maxutko1/semester-project-2-/Pics/20250319_132219.jpg

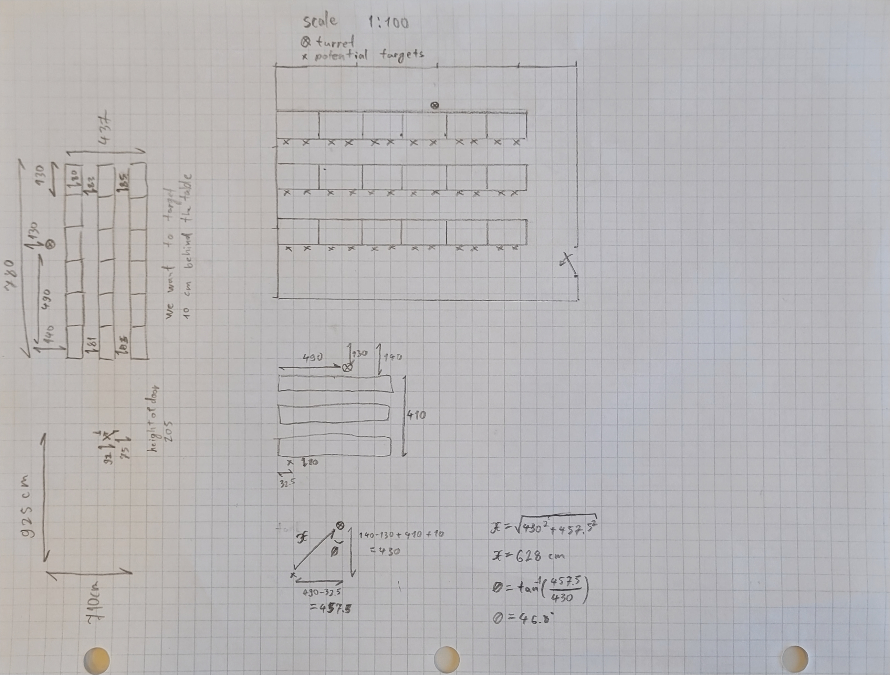
Pics/20250319_132219.jpg
