maxutko1/semester-project-2-/Pressure Tank/very shot pic.jpg

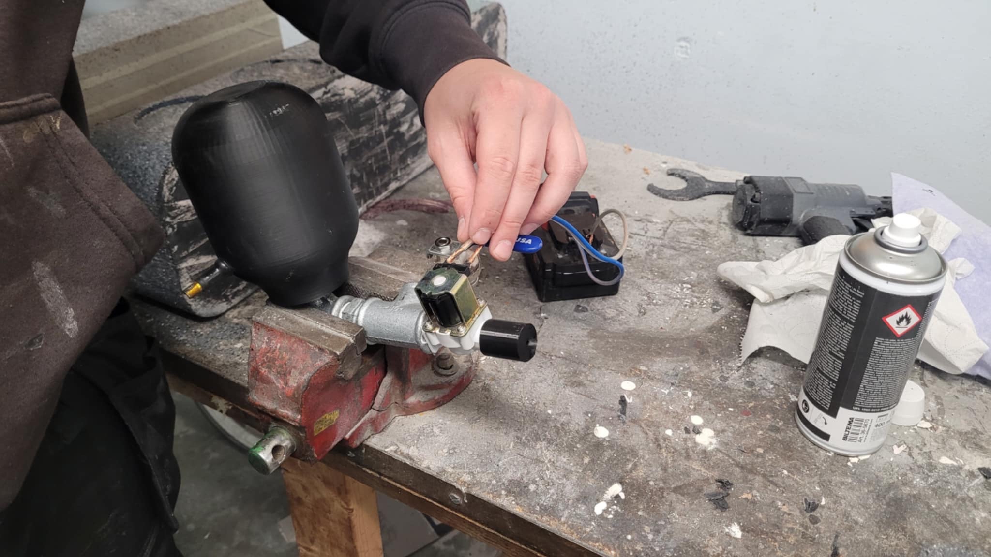
Pressure Tank/very shot pic.jpg
