maxutko1/semester-project-2-/Budget word document.docx

# Budget

Budgeting is often one of the biggest challenges for any engineering project, especially during the learning phase. While it's tempting to prioritize getting a working prototype at all costs, adhering to a budget is critical—both for discipline and to avoid creating unrealistic expectations for future users or customers. For this project, we maintained a total budget of 2000 DKK, which we successfully stayed within.

A significant portion of the budget was allocated to motors and 3D printing. The motors selected for this project are relatively powerful, and due to the iterative nature of our design process, we performed extensive testing and reprinting of components. Although this consumed more filament than a more streamlined approach might have, we collectively agreed that multiple test cycles would result in a more refined final product. The trade-off in material cost was deemed worthwhile for the performance and reliability gains.

Some components were purchased purely for testing purposes—such as breadboards and jumper wires—due to recent limitations in the university facilities. As many students will recognize, these shortages followed the departure of Niels, a key staff member whose absence is still felt. As a result, we found it necessary to procure basic prototyping equipment ourselves to avoid unnecessary delays.

There are also a few items not reflected in the official budget, primarily because they were either unavailable through standard vendors in Denmark or were significantly more affordable through overseas suppliers. These include the PD power delivery board (see Power Board section), the DC-DC buck converter, and the high-pressure pump. These components were instead paid for directly by individual team members, often sourced from “Chinesium” suppliers—a lighthearted term we use for affordable international marketplaces.

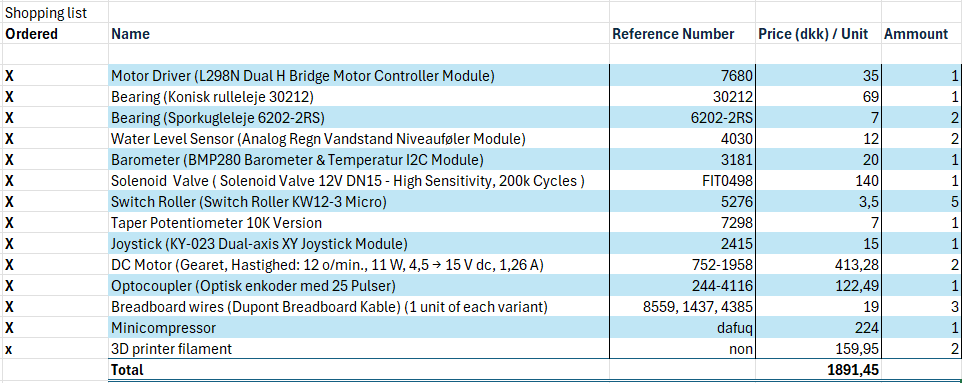
[picture p13: figure]
Et billede, der indeholder tekst, skærmbillede, nummer/tal, Font/skrifttype Indhold genereret af kunstig intelligens kan være forkert.
