maxutko1/semester-project-2-/Cad models/ic162-microswitch-1.snapshot.2/Screenshot_2.jpg

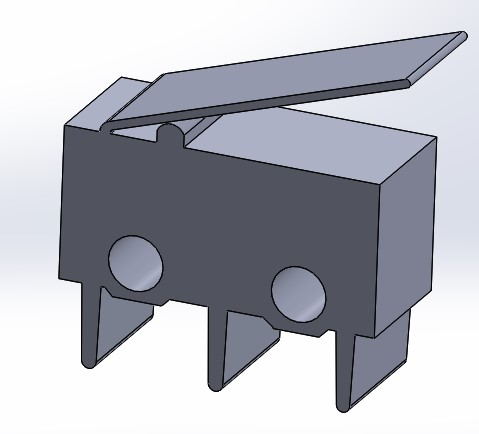
Cad models/ic162-microswitch-1.snapshot.2/Screenshot_2.jpg
