maxutko1/semester-project-2-/Cad models/PotentiometerB10K.png

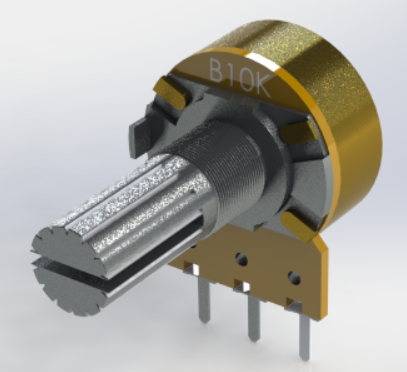
Cad models/PotentiometerB10K.png
