maxutko1/semester-project-2-/Cad models/PotentiometerB10KBack.png

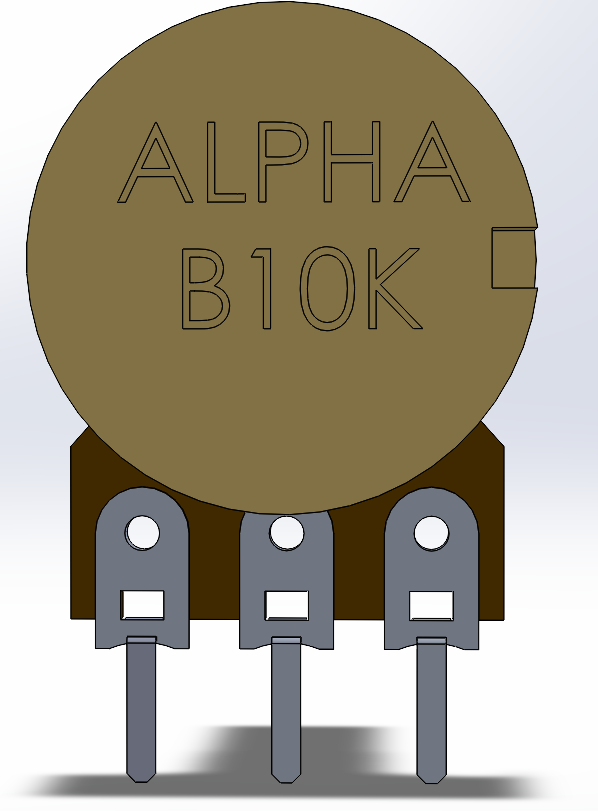
Cad models/PotentiometerB10KBack.png
