maxutko1/semester-project-2-/Cad models/PotentiometerB10KDown.png

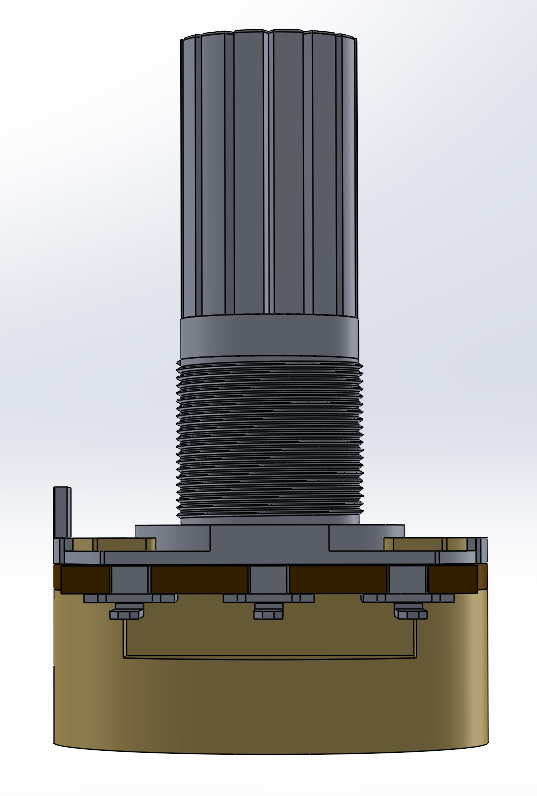
Cad models/PotentiometerB10KDown.png
