maxutko1/semester-project-2-/Cad models/PotentiometerB10KFront.png

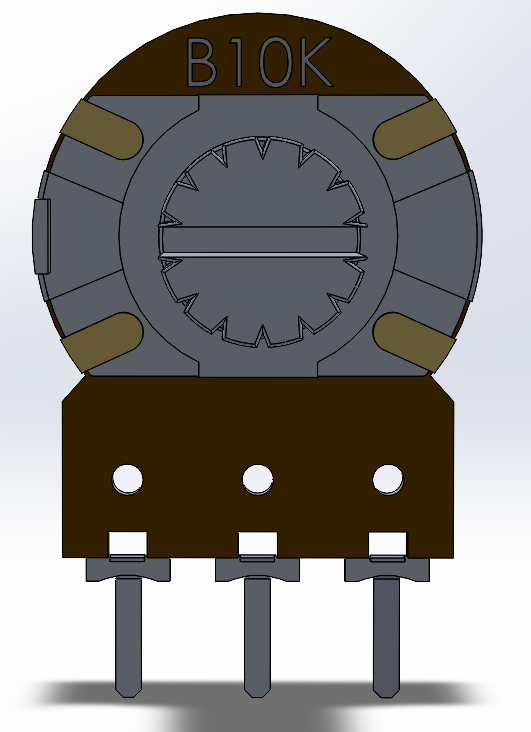
Cad models/PotentiometerB10KFront.png
