maxutko1/semester-project-2-/Cad models/PotentiometerB10KLeft.png

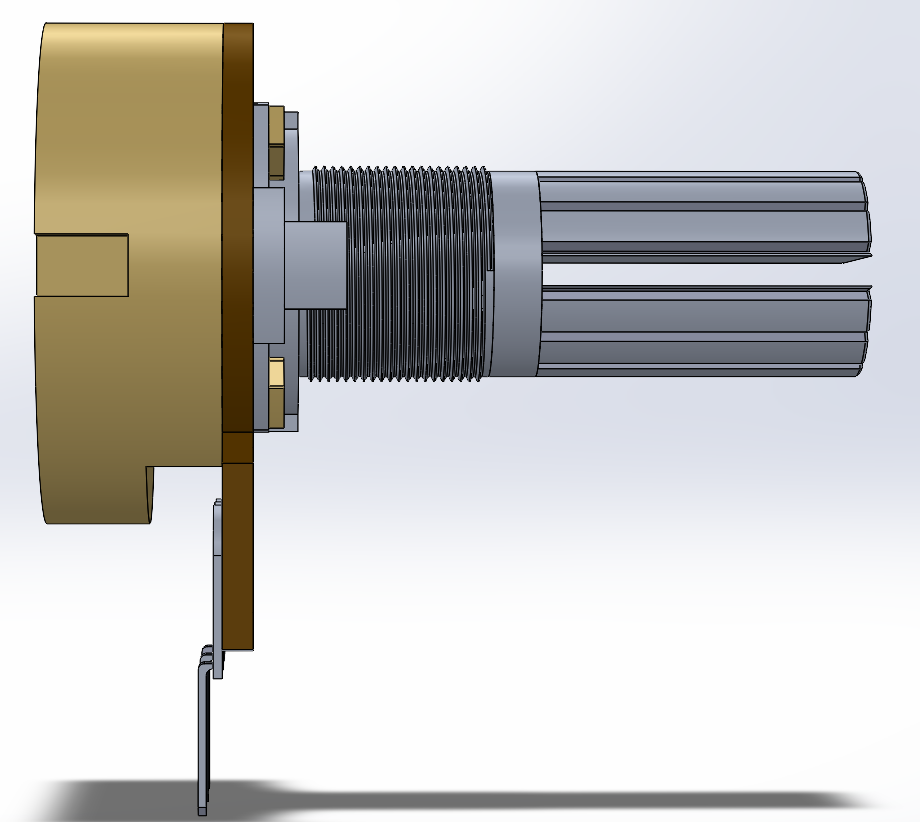
Cad models/PotentiometerB10KLeft.png
