maxutko1/semester-project-2-/Cad models/PotentiometerB10KUp.png

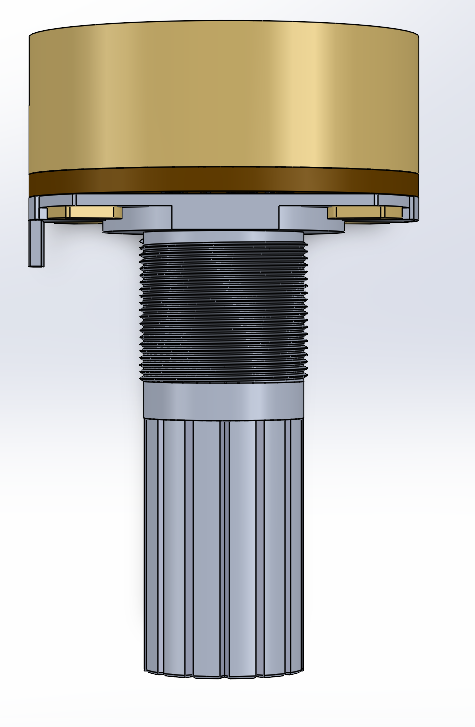
Cad models/PotentiometerB10KUp.png
