maxutko1/semester-project-2-/Cad models/water-level-sensor-5.snapshot.5/Water_level_sensor 3.PNG

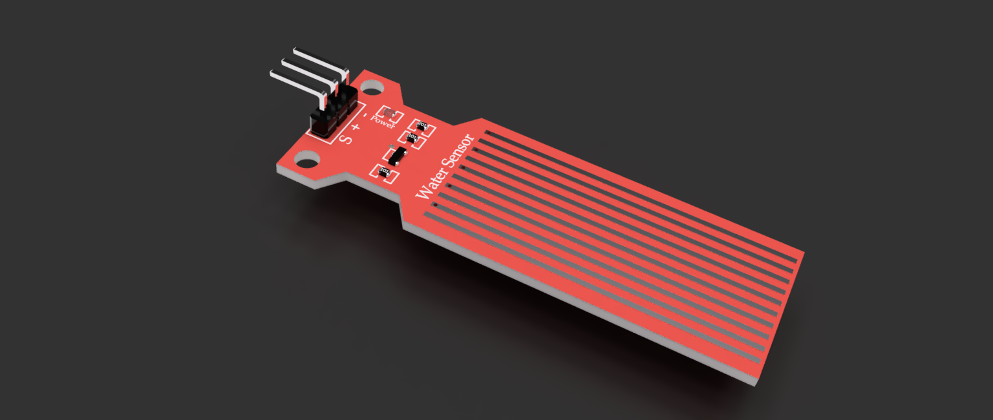
Cad models/water-level-sensor-5.snapshot.5/Water_level_sensor 3.PNG
