maxutko1/semester-project-2-/Mock model for torret/Nueva carpeta/6202.JPG

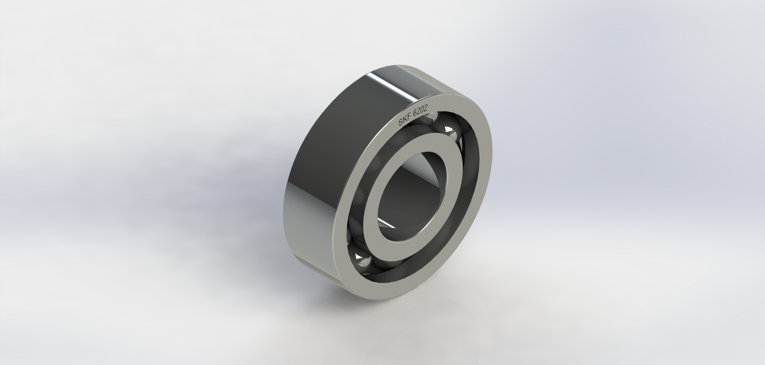
Mock model for torret/Nueva carpeta/6202.JPG
