maxutko1/semester-project-2-/Mock model for torret/Sin título.png

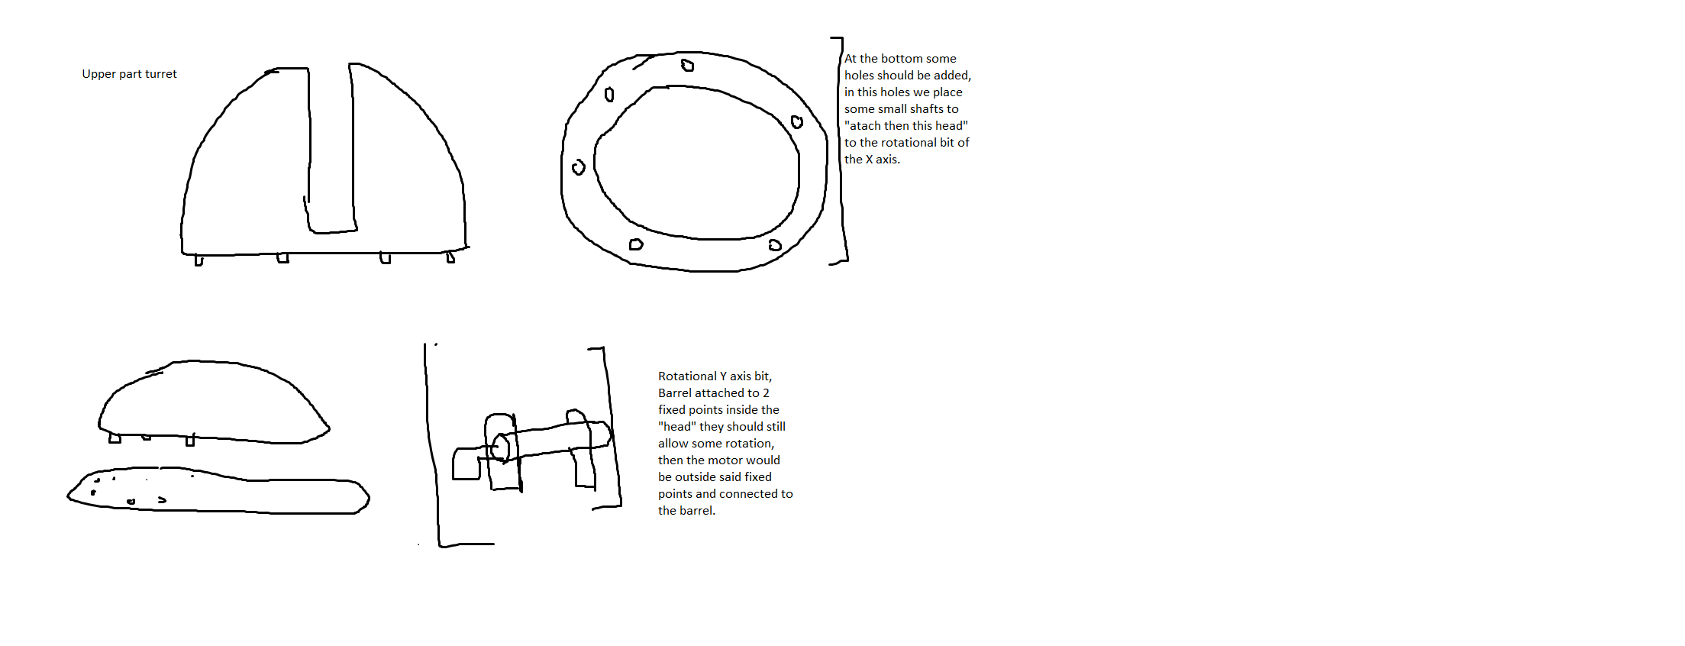
Mock model for torret/Sin título.png
