maxutko1/semester-project-2-/paint.fuckerydo.png

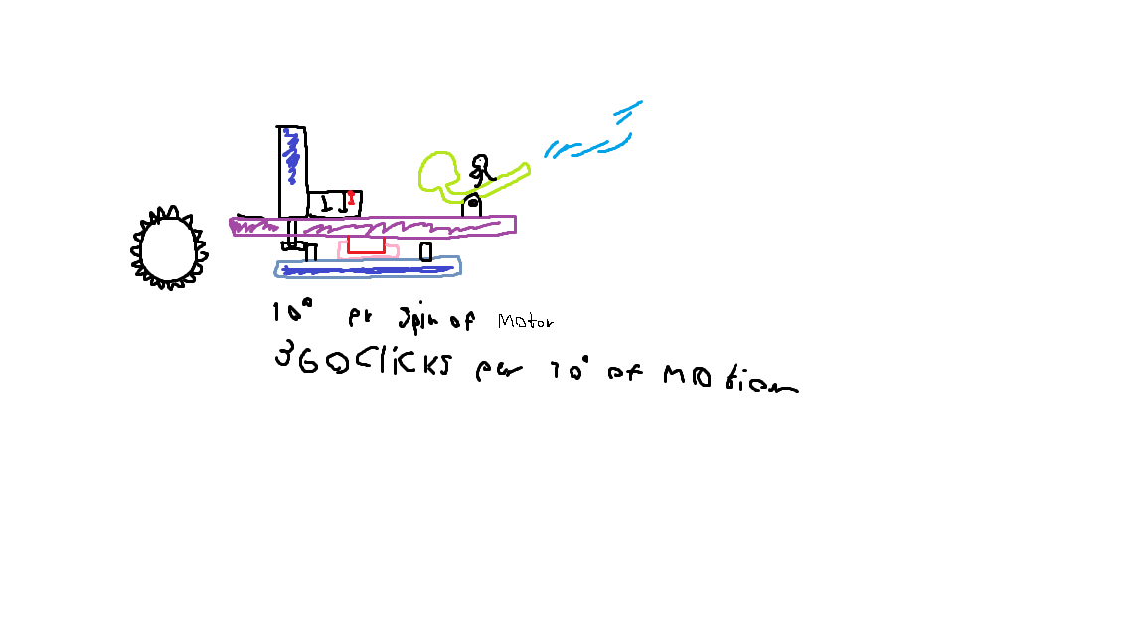
paint.fuckerydo.png
