maxutko1/semester-project-2-/Pics/20250320_143324.jpg

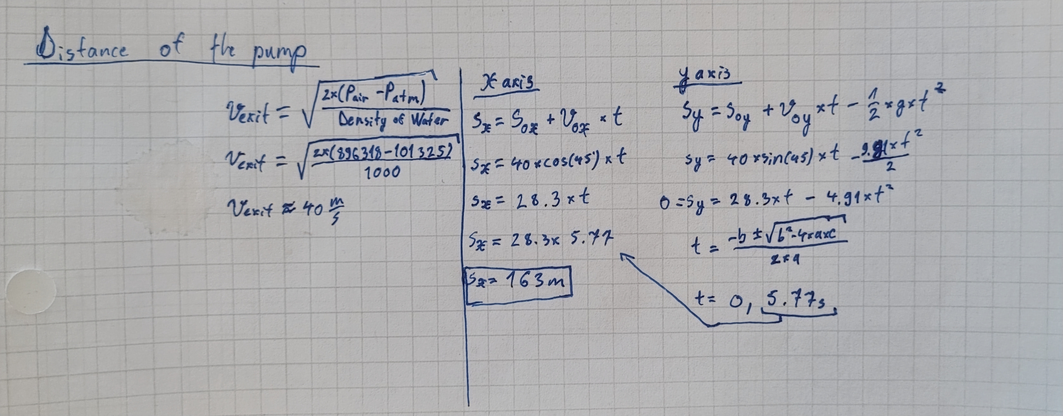
Pics/20250320_143324.jpg
