maxutko1/semester-project-2-/Pics/Sketch base.png

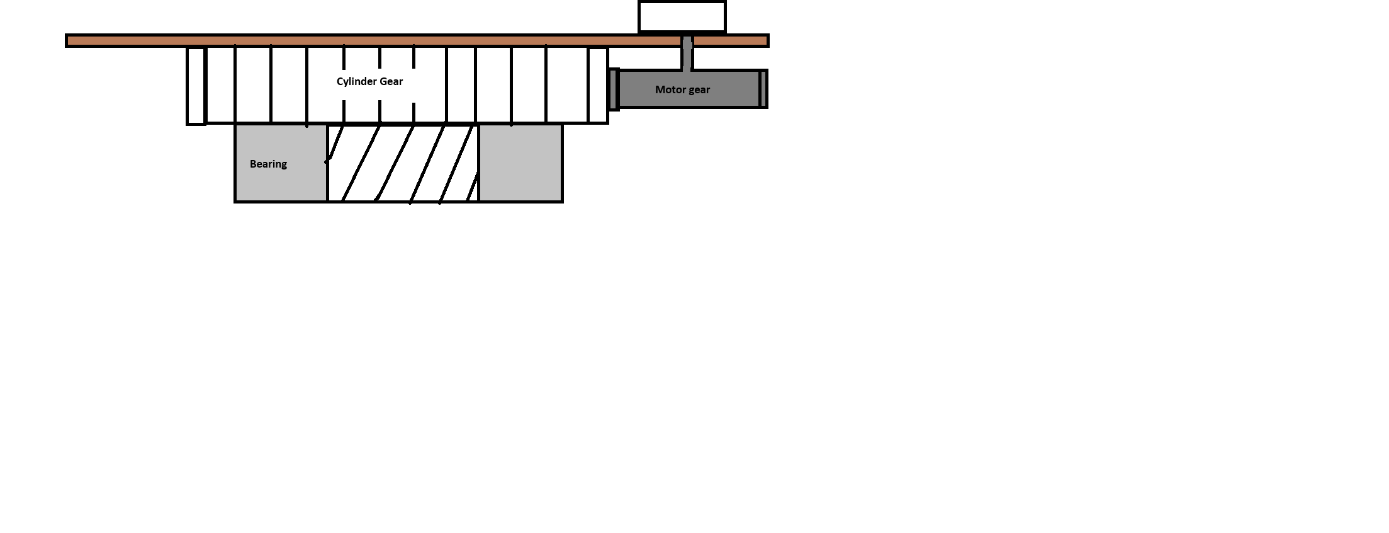
Pics/Sketch base.png
