maxutko1/semester-project-2-/Pressure Tank/20250307_152540.jpg

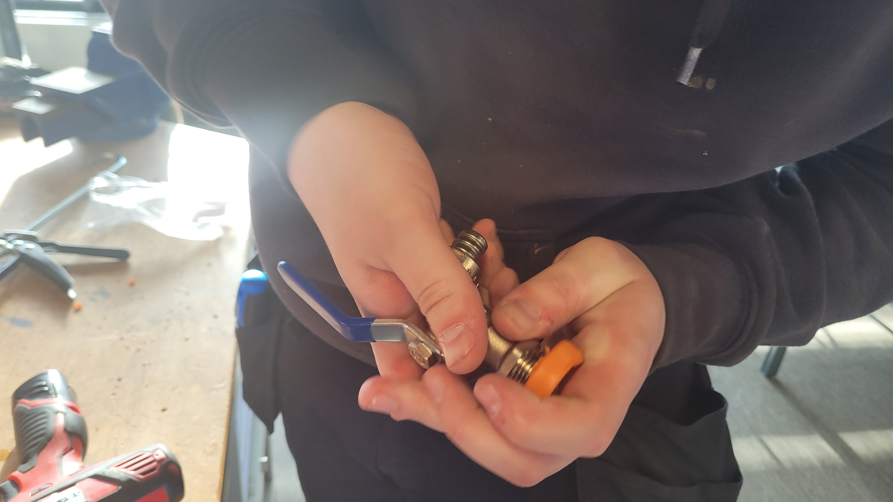
Pressure Tank/20250307_152540.jpg
