maxutko1/semester-project-2-/Pressure Tank/20250310_104949.jpg

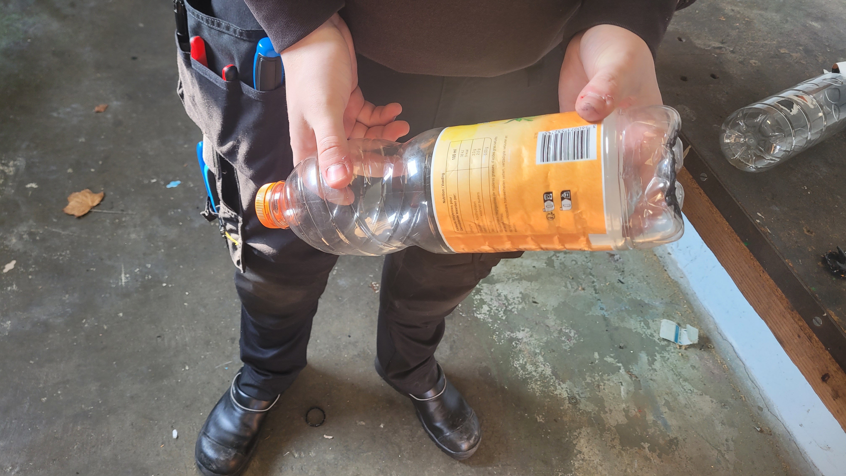
Pressure Tank/20250310_104949.jpg
