maxutko1/semester-project-2-/Pressure Tank/20250310_111705.jpg

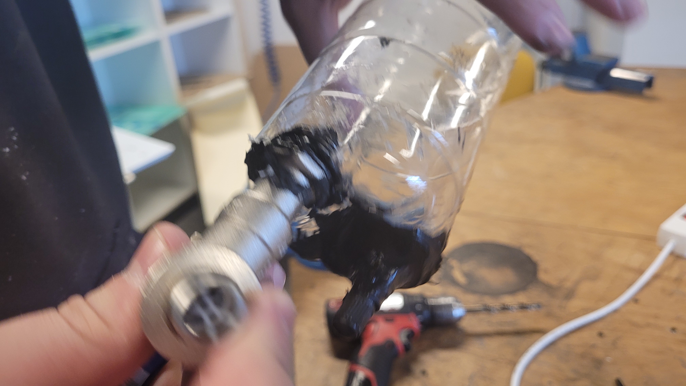
Pressure Tank/20250310_111705.jpg
