maxutko1/semester-project-2-/Pressure Tank/20250312_123249.jpg

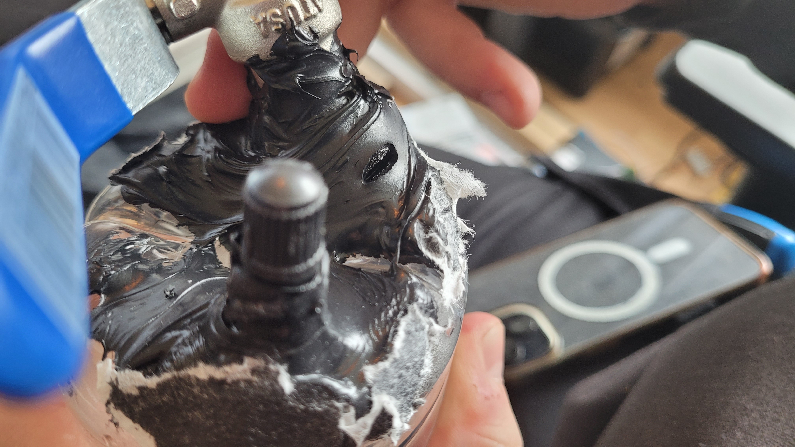
Pressure Tank/20250312_123249.jpg
