maxutko1/semester-project-2-/Pressure Tank/fittings-1-2-1.snapshot.18/Render.JPG

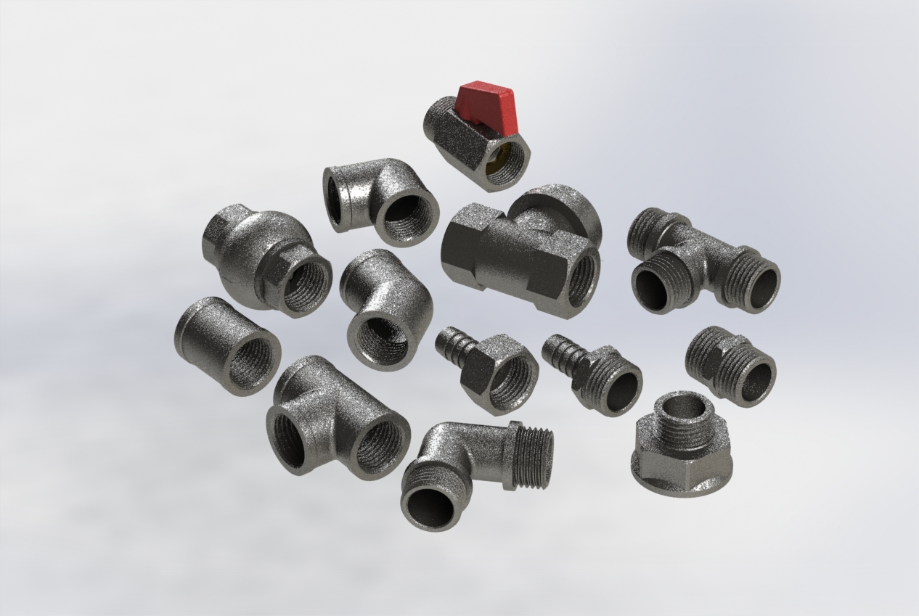
Pressure Tank/fittings-1-2-1.snapshot.18/Render.JPG
