maxutko1/semester-project-2-/Pressure Tank/shooty pic.jpg

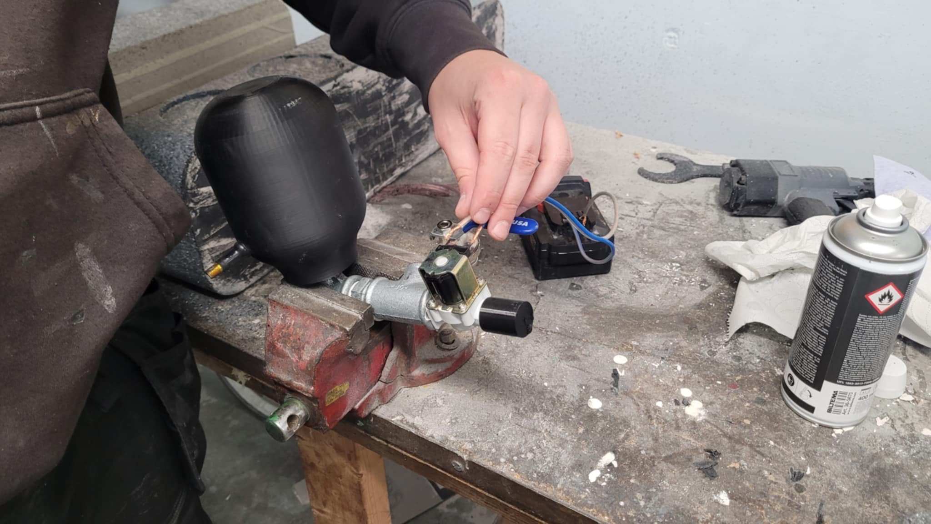
Pressure Tank/shooty pic.jpg
