maxutko1/semester-project-2-/Excel sheets/Shopping List 18.03.2025.xlsx

Shopping list
Ordered | Name | Reference Number | Price (dkk) / Unit | Ammount | Link
X | Motor Driver (L298N Dual H Bridge Motor Controller Module) | 7680 | 35 | 1 | https://ardustore.dk/produkt/l298n-dual-h-bridge-motor-controller-module?gad_source=1
X | Bearing (Konisk rulleleje 30212) | 30212 | 69 | 1 | https://billiglejer.dk/da/30200-serien/3166-konisk-rulleleje-30212.html
X | Bearing (Sporkugleleje 6202-2RS) | 6202-2RS | 7 | 2 | https://billiglejer.dk/da/6200-serien/138-sporkugleleje-6202-2rs.html?gad_source=1
X | Water Level Sensor (Analog Regn Vandstand Niveauføler Module) | 4030 | 12 | 2 | https://ardustore.dk/produkt/analog-regn-vandstand-niveaufoeler-module?gad_source=1
X | Barometer (BMP280 Barometer & Temperatur I2C Module) | 3181 | 20 | 1 | https://ardustore.dk/produkt/bmp280-barometer-temperatur-i2c-module?gad_source=1
X | Solenoid Valve ( Solenoid Valve 12V DN15 - High Sensitivity, 200k Cycles ) | FIT0498 | 140 | 1 | https://let-elektronik.dk/12v-solenoid-valve-dn15
X | Switch Roller (Switch Roller KW12-3 Micro) | 5276 | 3.5 | 5 | https://ardustore.dk/produkt/switch-roller-kw12-3-micro?gad_source=1
X | Taper Potentiometer 10K Version | 7298 | 7 | 1 | https://ardustore.dk/produkt/taper-potmeter
X | Joystick (KY-023 Dual-axis XY Joystick Module) | 2415 | 15 | 1 | https://ardustore.dk/produkt/ky-023-dual-axis-xy-joystick-module
X | DC Motor (Gearet, Hastighed: 12 o/min., 11 W, 4,5 → 15 V dc, 1,26 A) | 752-1958 | 413.28 | 2 | https://dk.rs-online.com/web/p/dc-motorer-jaevnstromsmotorer/7521958
X | Optocoupler (Optisk enkoder med 25 Pulser) | 244-4116 | 122.49 | 1 | https://dk.rs-online.com/web/p/optiske-roterende-indkodere/2444116?gb=s
X | Breadboard wires (Dupont Breadboard Kable) (1 unit of each variant) | 8559, 1437, 4385 | 19 | 3 | https://ardustore.dk/produkt/dupont-breadboard-kabel
X | Minicompressor | dafuq | 224 | 1
x | 3D printer filament | non | 159.95 | 2 | https://3deksperten.dk/products/3de-basic-pla-black-1-75mm-1kg
 | Total |  | 1891.45
