maxutko1/semester-project-2-/Cad models/dual-axis-xy-joystick-module-with-push-button-1.snapshot.1/Joystick/Thumb Joystick.SLDASM

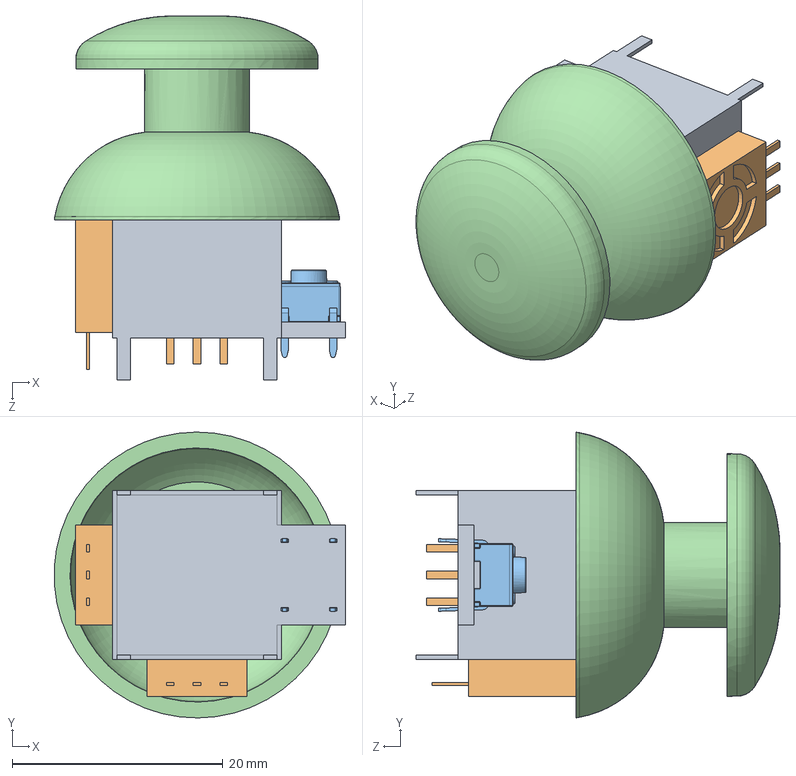
[picture p70: CAD file, 2025-04-01]
Cad models/dual-axis-xy-joystick-module-with-push-button-1.snapshot.1/Joystick/Thumb Joystick.SLDASM
27.6 x 27.1 x 34.5 mm
potentiometer x 2
tactileswitch-short
joystickhead
