maxutko1/semester-project-2-/Cad models/dual-axis-xy-joystick-module-with-push-button-1.snapshot.1/Joystick/Joystick assembly.STEP

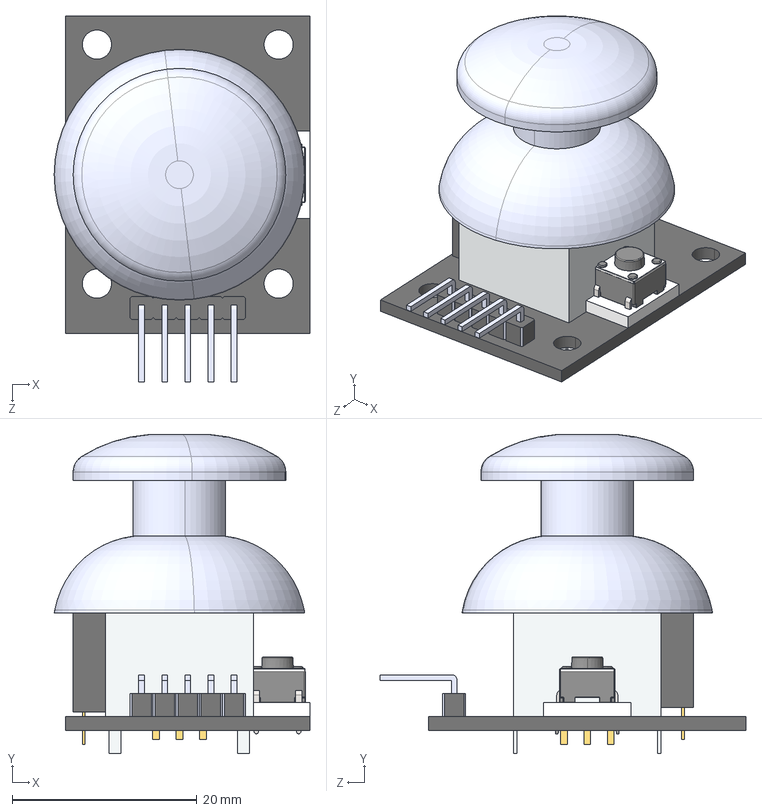
[picture p71: CAD file, 2025-04-01]
Cad models/dual-axis-xy-joystick-module-with-push-button-1.snapshot.1/Joystick/Joystick assembly.STEP
27.7 x 34.5 x 39.5 mm
board
potentiometer___ x 2
tactileswitch-short
joystickhead___
