maxutko1/semester-project-2-/Absolutely every .stl/POT10K.step

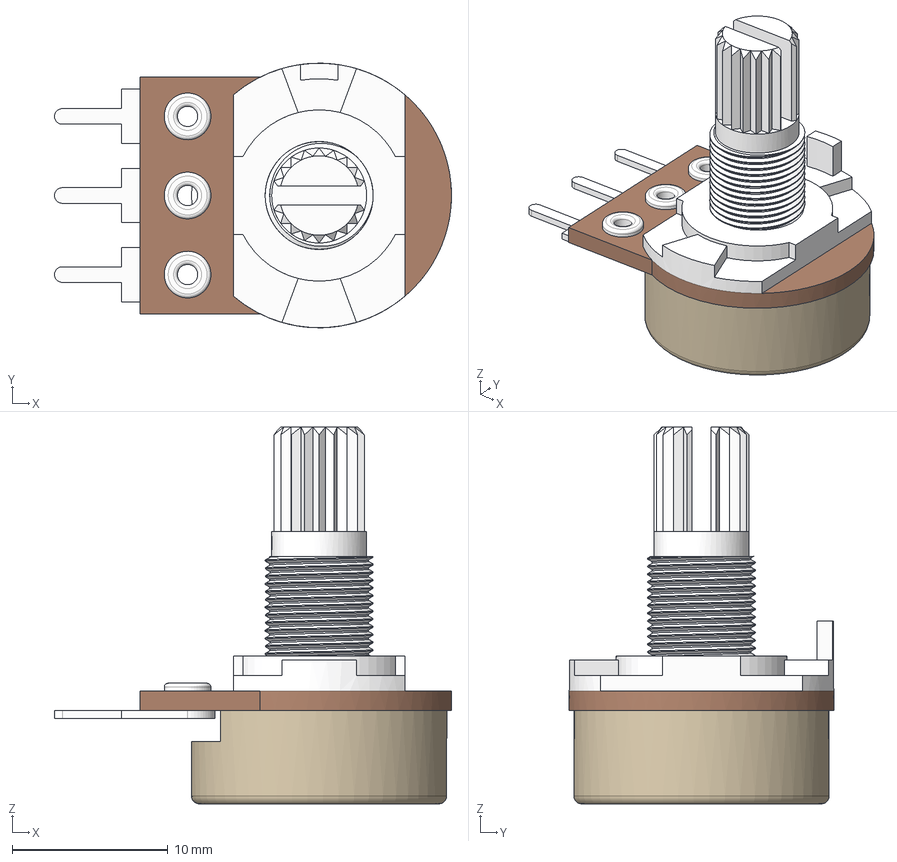
[picture p72: CAD file, 2025-05-29]
Absolutely every .stl/POT10K.step
25.5 x 17.0 x 24.2 mm
