maxutko1/semester-project-2-/Cad models/bmp388-barometer-1.snapshot.1/BMP388_Barometer v1.step

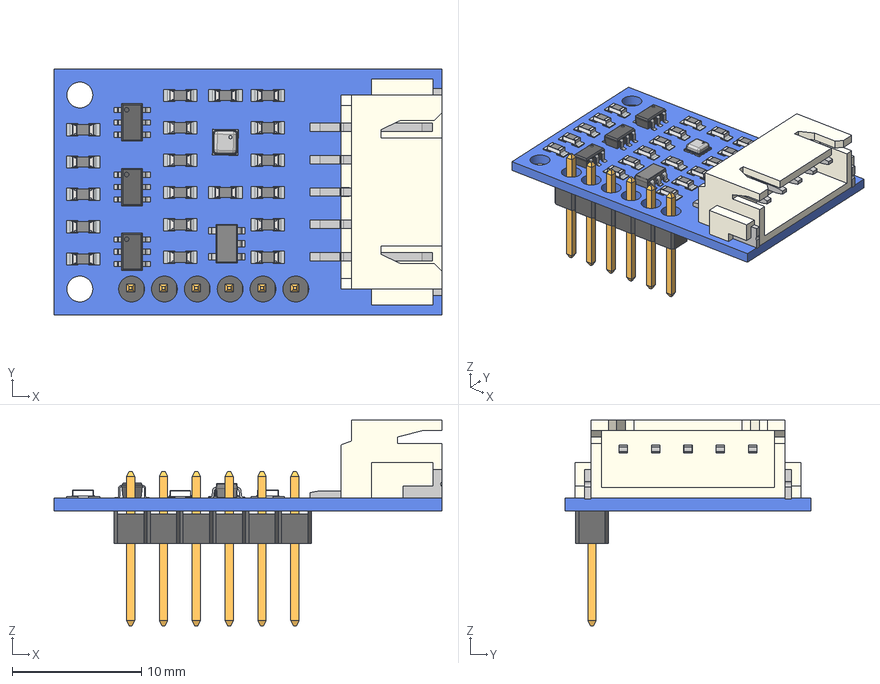
[picture p73: CAD file, 2025-04-01]
Cad models/bmp388-barometer-1.snapshot.1/BMP388_Barometer v1.step
30.0 x 19.0 x 15.9 mm
Base_PCB
JST-XH5-SMD.step
6-Pin Header - Male - 2.54mm.step
smd_0603.step x 20
SOT23-6.step x 3
SOT23-5.stp
Bosch BMP388.step
