maxutko1/semester-project-2-/Cad models/dual-axis-xy-joystick-module-with-push-button-1.snapshot.1/Joystick/board.SLDPRT

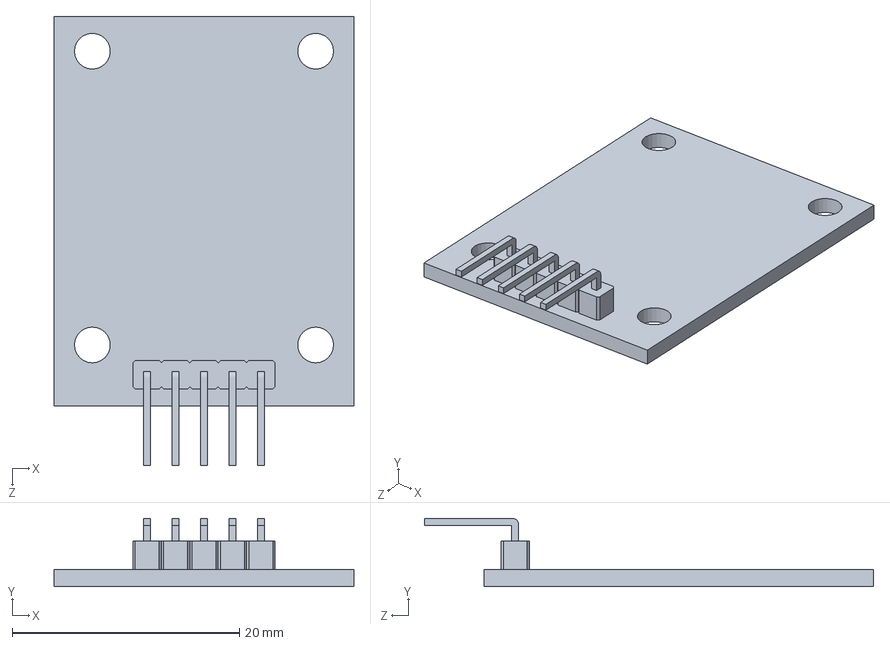
[picture p74: CAD file, 2025-04-01]
Cad models/dual-axis-xy-joystick-module-with-push-button-1.snapshot.1/Joystick/board.SLDPRT
26.4 x 6.01 x 39.5 mm
