maxutko1/semester-project-2-/Cad models/hydralectric-solenoid-valve-1-2-inch-1.snapshot.1/SOLENOID_FLUSH.STEP

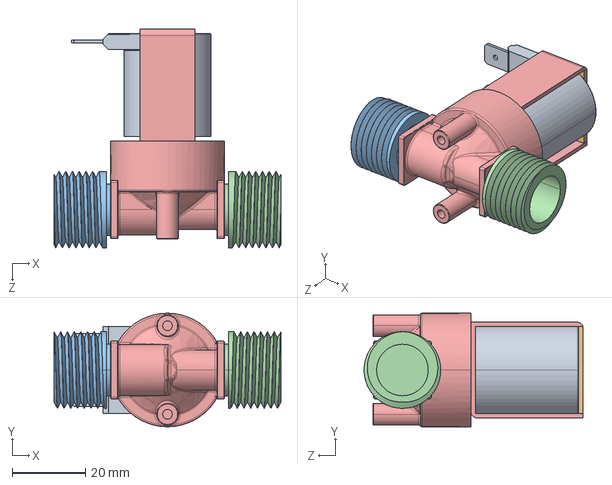
[picture p75: CAD file, 2025-04-01]
Cad models/hydralectric-solenoid-valve-1-2-inch-1.snapshot.1/SOLENOID_FLUSH.STEP
62.1 x 31.1 x 59.8 mm
