maxutko1/semester-project-2-/Cad models/ic162-microswitch-1.snapshot.2/IC162-Microswitch.SLDPRT

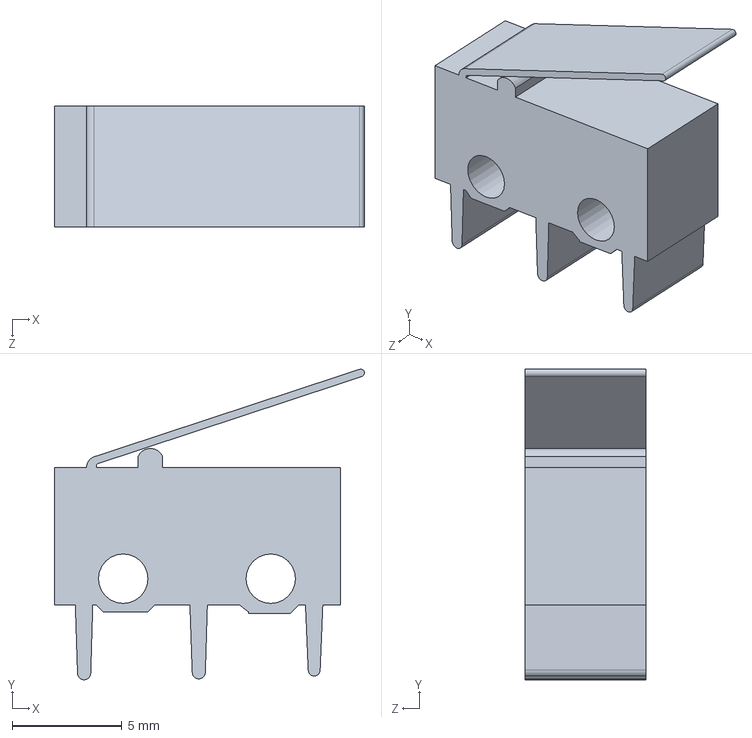
[picture p76: CAD file, 2025-04-01]
Cad models/ic162-microswitch-1.snapshot.2/IC162-Microswitch.SLDPRT
14.1 x 14.1 x 5.50 mm
