maxutko1/semester-project-2-/Cad models/PotentiometerB10K.SLDPRT

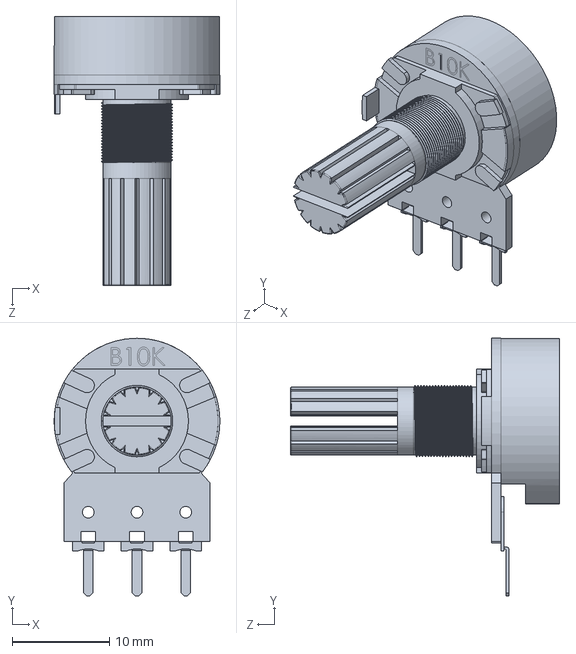
[picture p77: CAD file, 2025-05-29]
Cad models/PotentiometerB10K.SLDPRT
17.0 x 26.4 x 27.6 mm
