maxutko1/semester-project-2-/Cad models/water-level-sensor-5.snapshot.5/Water level sensor.step

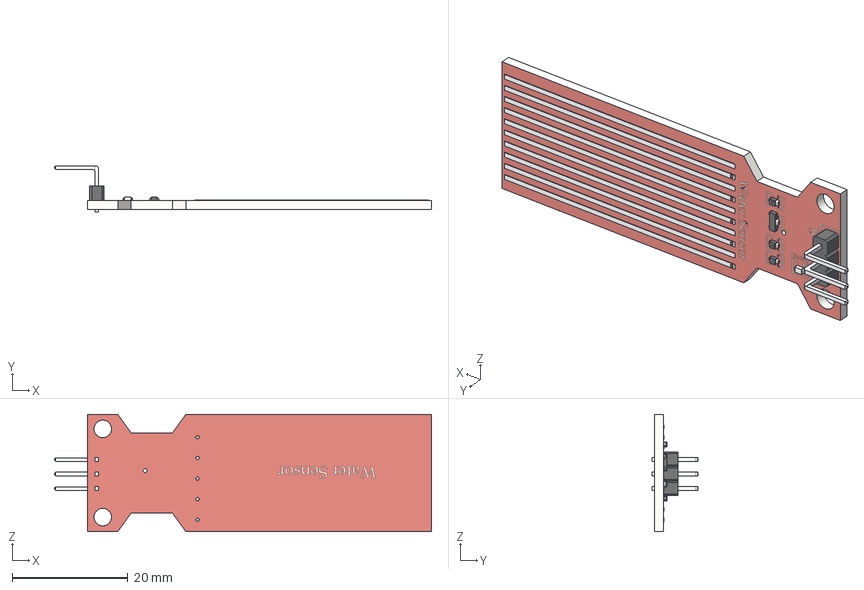
[picture p78: CAD file, 2025-04-01]
Cad models/water-level-sensor-5.snapshot.5/Water level sensor.step
65.0 x 8.00 x 20.2 mm
