maxutko1/semester-project-2-/Cad models/X-axis Motor holder/X AXIS ASSEMBLY/Y-axis Base.stp

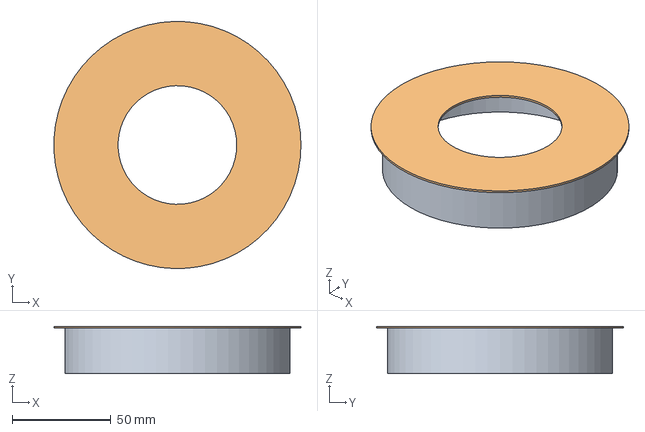
[picture p79: CAD file, 2025-05-20]
Cad models/X-axis Motor holder/X AXIS ASSEMBLY/Y-axis Base.stp
124.9 x 125.0 x 24.0 mm
