maxutko1/semester-project-2-/Mock model for torret/Nueva carpeta/SKF BALL BEARING 6202 15x35x11.STEP

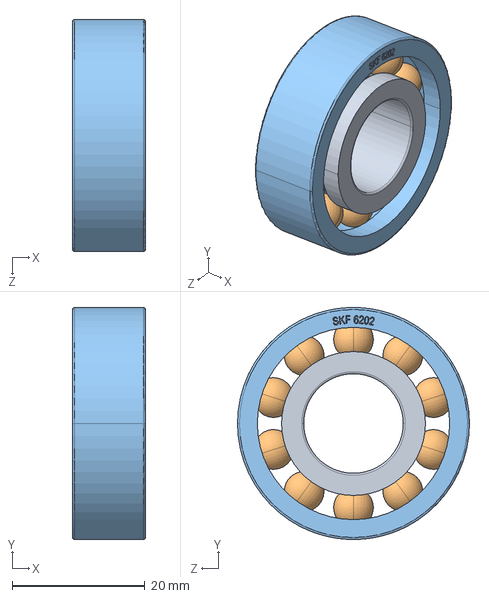
[picture p80: CAD file, 2025-03-25]
Mock model for torret/Nueva carpeta/SKF BALL BEARING 6202 15x35x11.STEP
11.0 x 35.0 x 35.0 mm
