maxutko1/semester-project-2-/Pressure Tank/fittings-1-2-1.snapshot.18/VTr.270.STEP

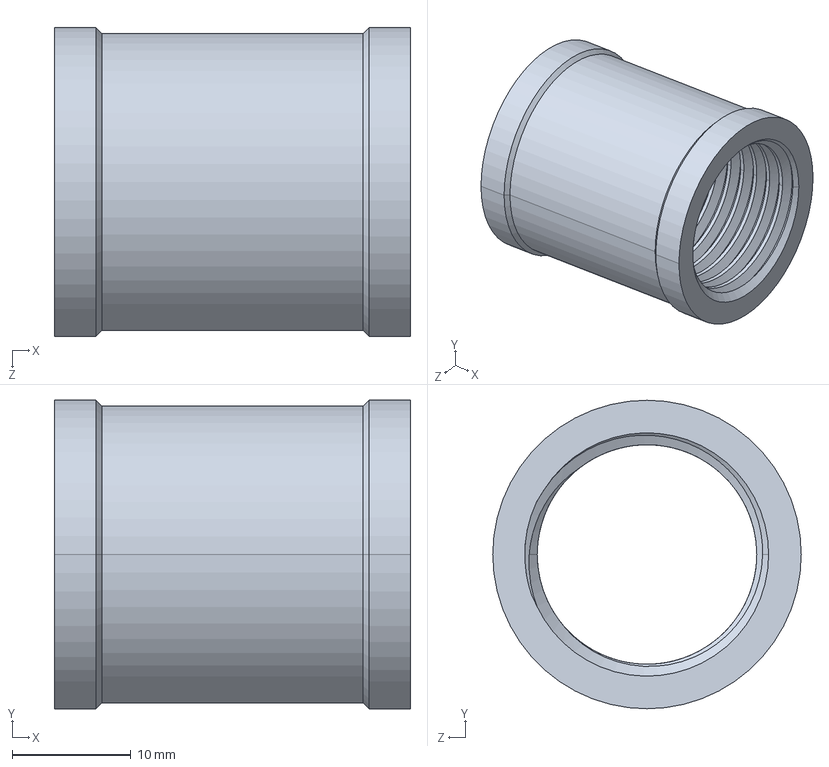
[picture p81: CAD file, 2025-05-20]
Pressure Tank/fittings-1-2-1.snapshot.18/VTr.270.STEP
30.0 x 26.0 x 26.0 mm
