maxutko1/semester-project-2-/Absolutely every .stl/Manche V2.stl

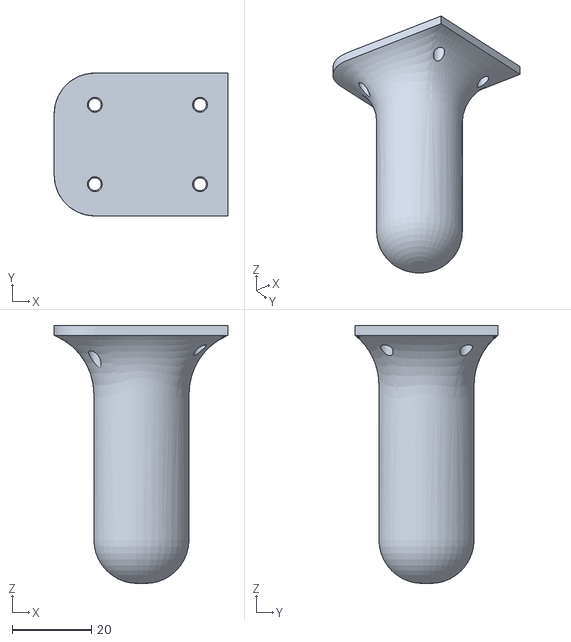
[picture p82: CAD file, 2025-05-29]
Absolutely every .stl/Manche V2.stl
43.8 x 36.0 x 65.0
