maxutko1/semester-project-2-/Cad models/16t gear.stl

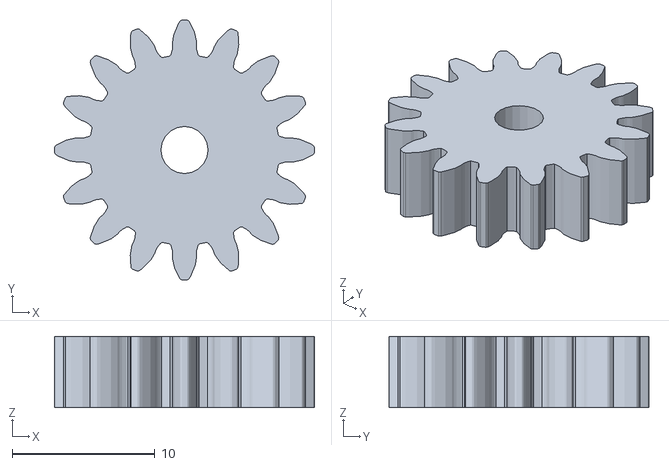
[picture p83: CAD file, 2025-05-27]
Cad models/16t gear.stl
18.2 x 18.2 x 5.00
