maxutko1/semester-project-2-/Cad models/X-axis Motor holder/X AXIS ASSEMBLY/gear 3.stp

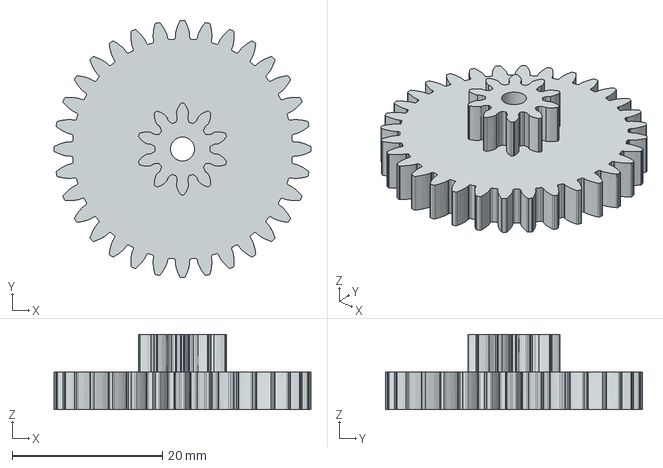
[picture p84: CAD file, 2025-05-17]
Cad models/X-axis Motor holder/X AXIS ASSEMBLY/gear 3.stp
34.2 x 34.2 x 10.0 mm
