maxutko1/semester-project-2-/Pressure Tank/fittings-1-2-1.snapshot.18/VTr.090.STEP

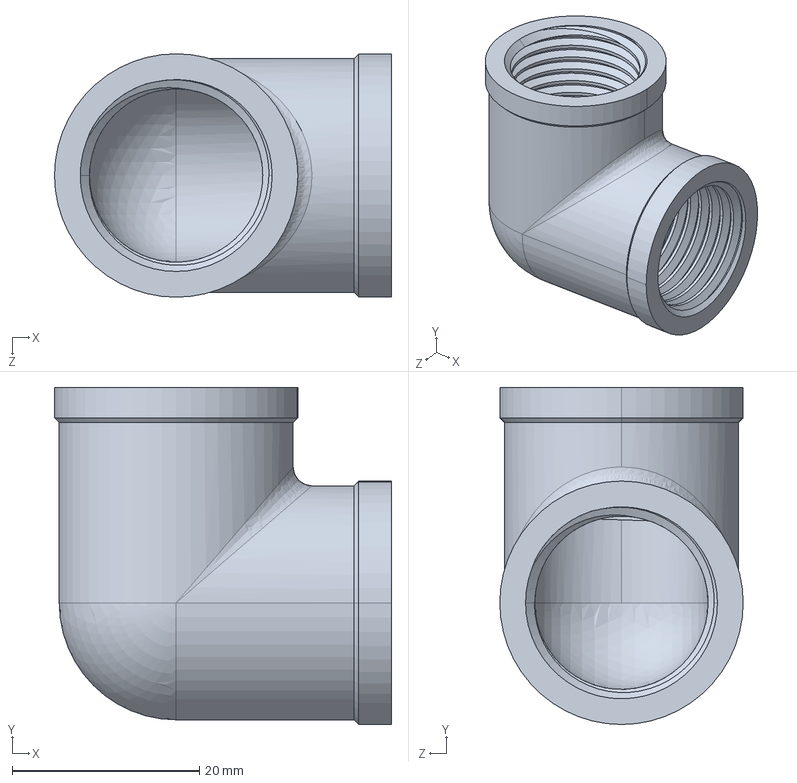
[picture p85: CAD file, 2025-05-20]
Pressure Tank/fittings-1-2-1.snapshot.18/VTr.090.STEP
36.0 x 36.0 x 26.0 mm
