maxutko1/semester-project-2-/Pressure Tank/Pressure tank, 3d print. rev 001 inventor file.stp

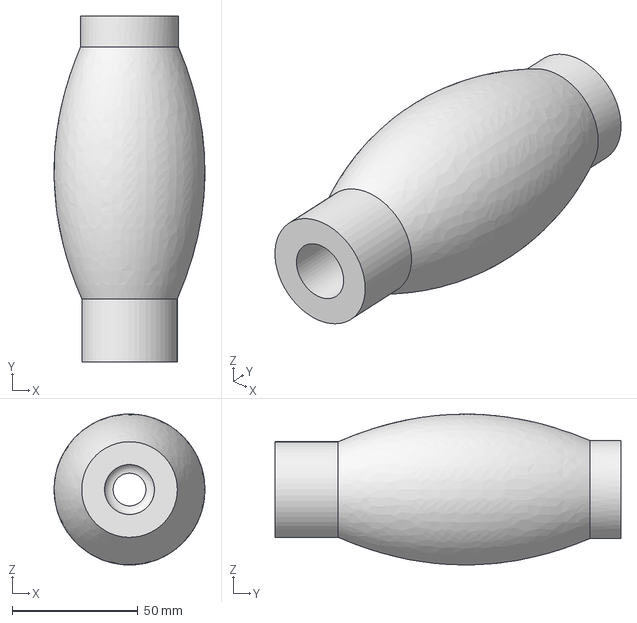
[picture p86: CAD file, 2025-03-20]
Pressure Tank/Pressure tank, 3d print. rev 001 inventor file.stp
60.0 x 137.3 x 60.0 mm
