maxutko1/semester-project-2-/Absolutely every .stl/Joystick Holder.stl

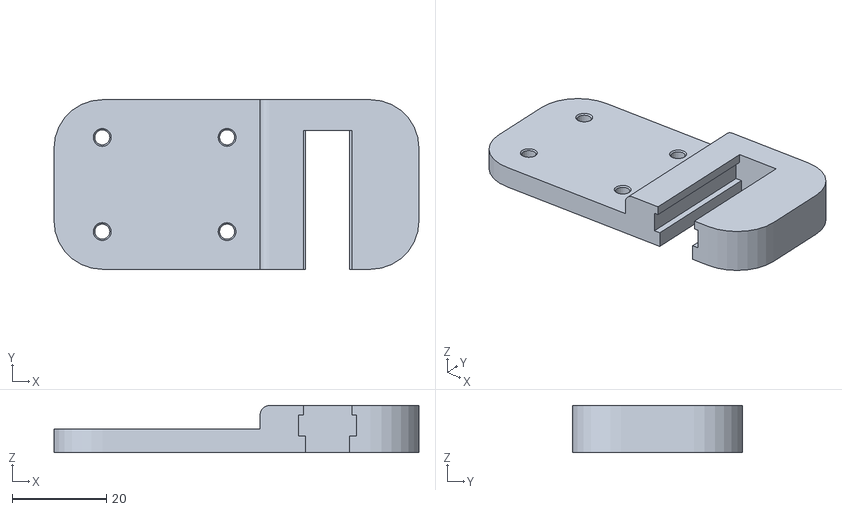
[picture p87: CAD file, 2025-05-29]
Absolutely every .stl/Joystick Holder.stl
77.5 x 36.0 x 10.0
