maxutko1/semester-project-2-/Cad models/25t gear.stl

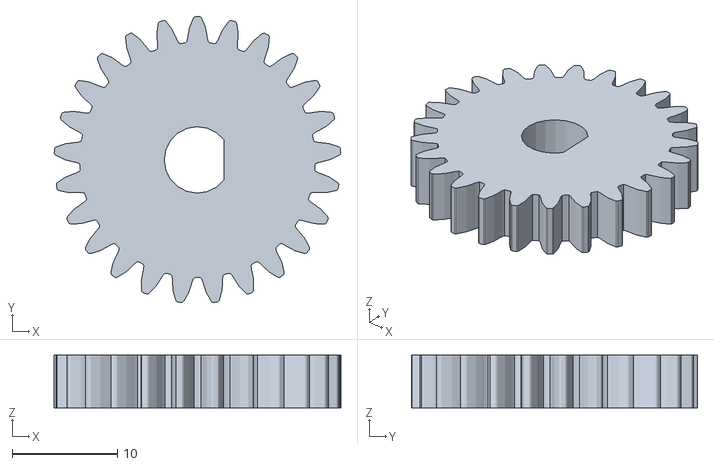
[picture p88: CAD file, 2025-05-27]
Cad models/25t gear.stl
27.2 x 27.1 x 5.00
