maxutko1/semester-project-2-/Cad models/dual-axis-xy-joystick-module-with-push-button-1.snapshot.1/Joystick/potentiometer.SLDPRT

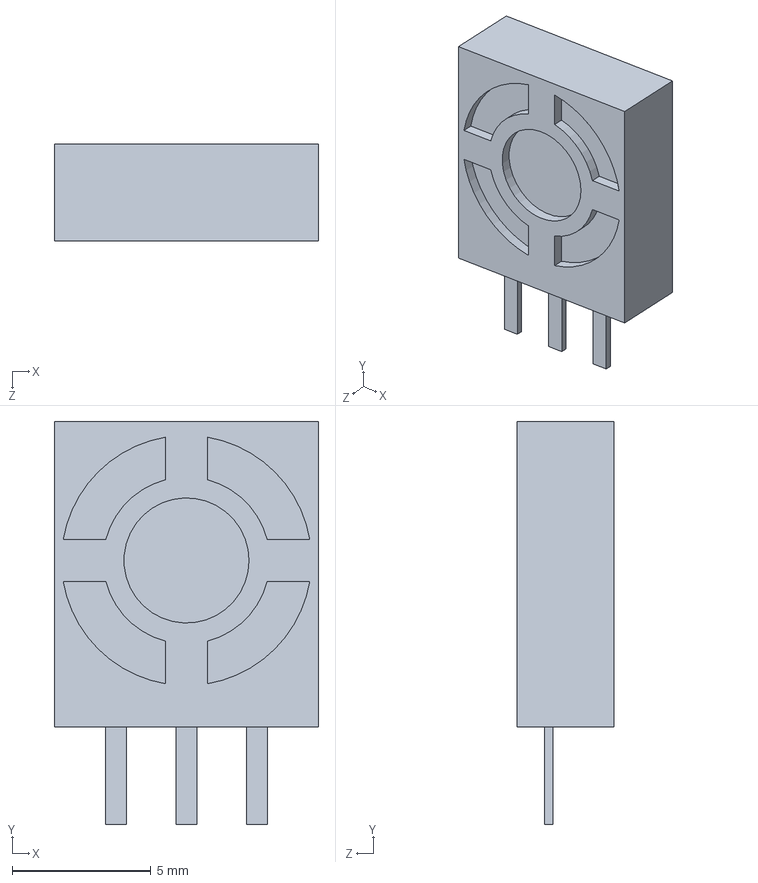
[picture p89: CAD file, 2025-04-01]
Cad models/dual-axis-xy-joystick-module-with-push-button-1.snapshot.1/Joystick/potentiometer.SLDPRT
9.50 x 14.5 x 3.50 mm
