maxutko1/semester-project-2-/Cad models/X-axis Motor holder/X AXIS ASSEMBLY/Test Base.stp

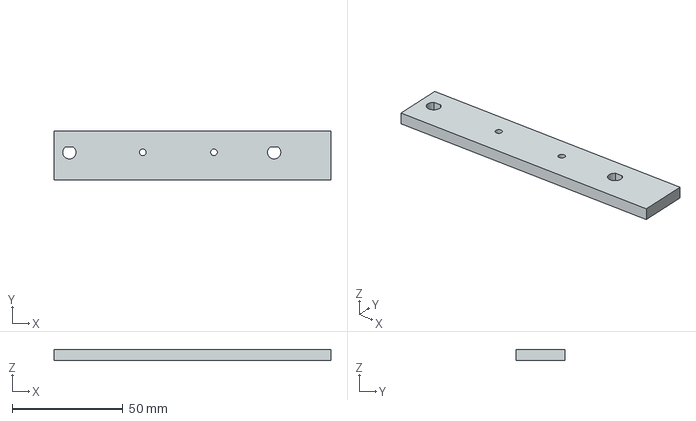
[picture p90: CAD file, 2025-05-17]
Cad models/X-axis Motor holder/X AXIS ASSEMBLY/Test Base.stp
125.3 x 22.1 x 5.00 mm
