maxutko1/semester-project-2-/Pressure Tank/fittings-1-2-1.snapshot.18/VTr.654.STEP

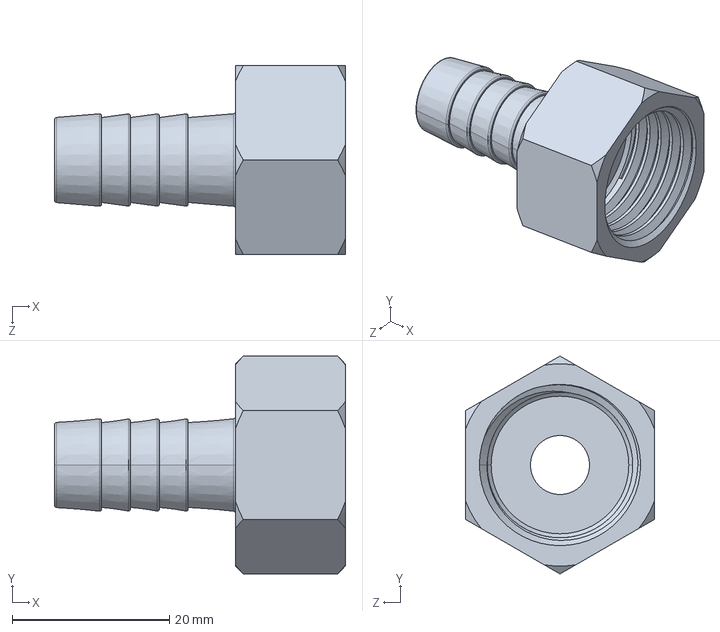
[picture p91: CAD file, 2025-05-20]
Pressure Tank/fittings-1-2-1.snapshot.18/VTr.654.STEP
37.0 x 27.7 x 24.0 mm
