maxutko1/semester-project-2-/Absolutely every .stl/holders for y axis motor rev 002.stl

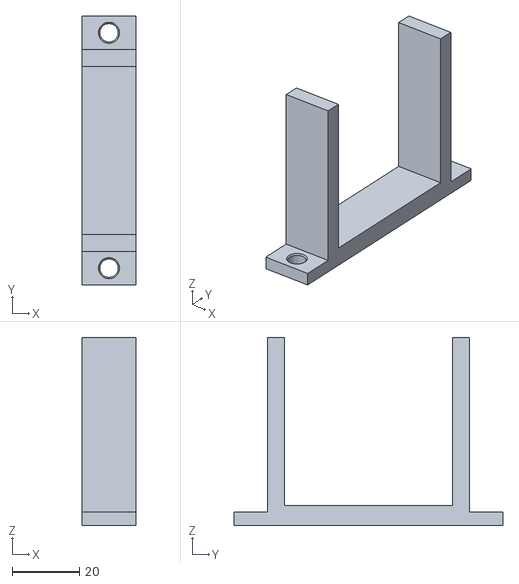
[picture p92: CAD file, 2025-05-27]
Absolutely every .stl/holders for y axis motor rev 002.stl
16.0 x 80.0 x 56.0
