maxutko1/semester-project-2-/Cad models/dual-axis-xy-joystick-module-with-push-button-1.snapshot.1/Joystick/body.SLDPRT

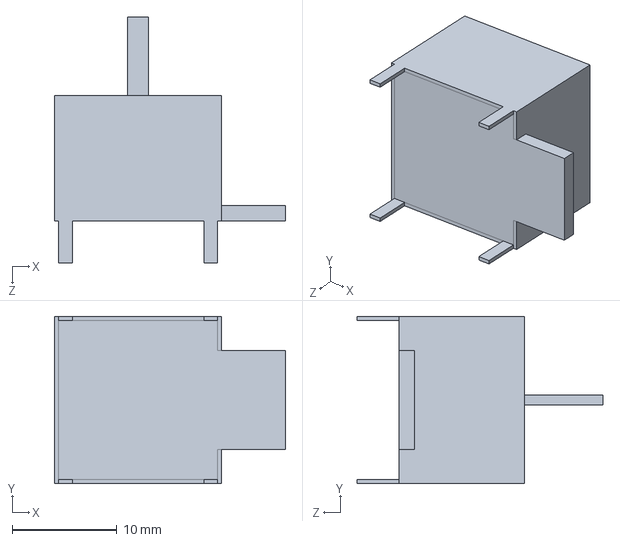
[picture p93: CAD file, 2025-04-01]
Cad models/dual-axis-xy-joystick-module-with-push-button-1.snapshot.1/Joystick/body.SLDPRT
22.1 x 16.0 x 23.5 mm
