maxutko1/semester-project-2-/Cad models/X-axis Motor holder/X AXIS ASSEMBLY/encoder gear.stp

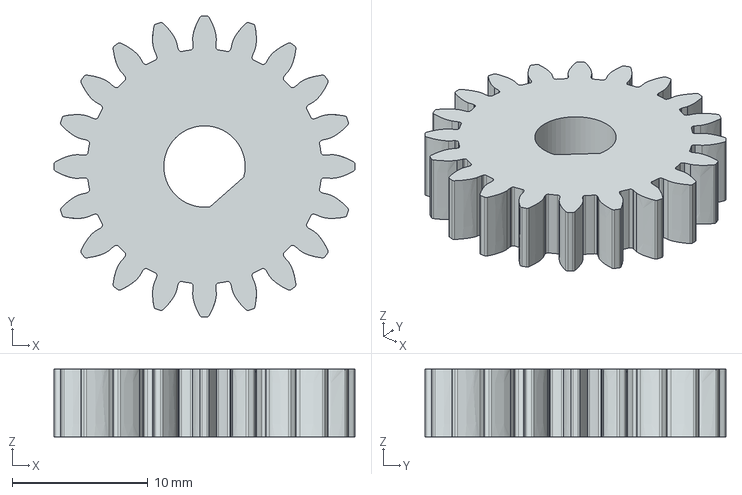
[picture p94: CAD file, 2025-05-17]
Cad models/X-axis Motor holder/X AXIS ASSEMBLY/encoder gear.stp
22.2 x 22.2 x 5.00 mm
