maxutko1/semester-project-2-/Pressure Tank/fittings-1-2-1.snapshot.18/VTr.093.STEP

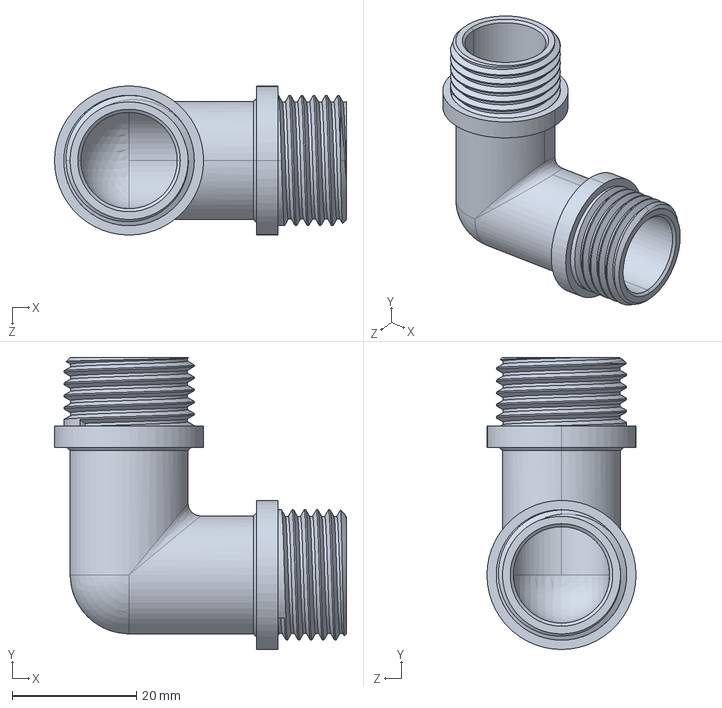
[picture p95: CAD file, 2025-05-20]
Pressure Tank/fittings-1-2-1.snapshot.18/VTr.093.STEP
47.0 x 47.0 x 24.0 mm
