maxutko1/semester-project-2-/Absolutely every .stl/holder for y axis motor.stl

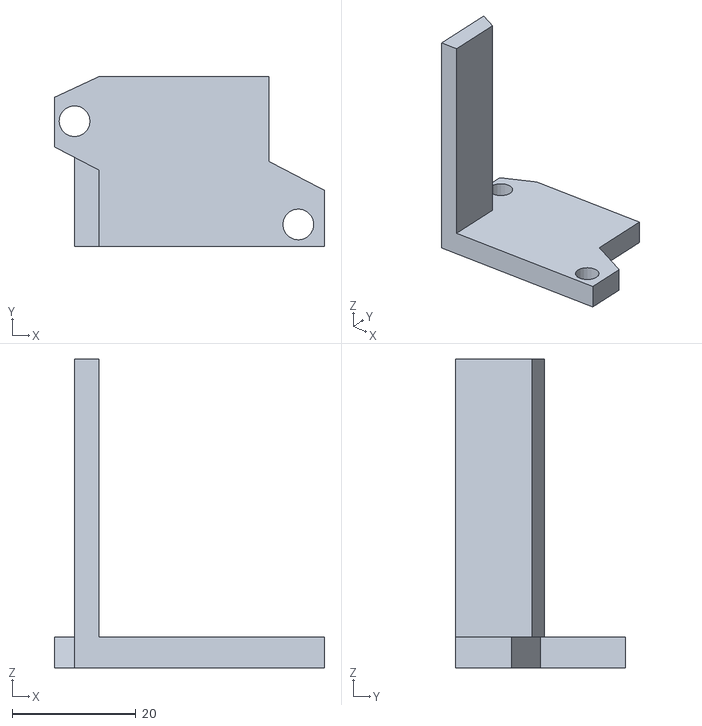
[picture p96: CAD file, 2025-05-27]
Absolutely every .stl/holder for y axis motor.stl
43.7 x 27.5 x 50.0
