maxutko1/semester-project-2-/Cad models/X-axis Motor holder/X AXIS ASSEMBLY/gear 1.stp

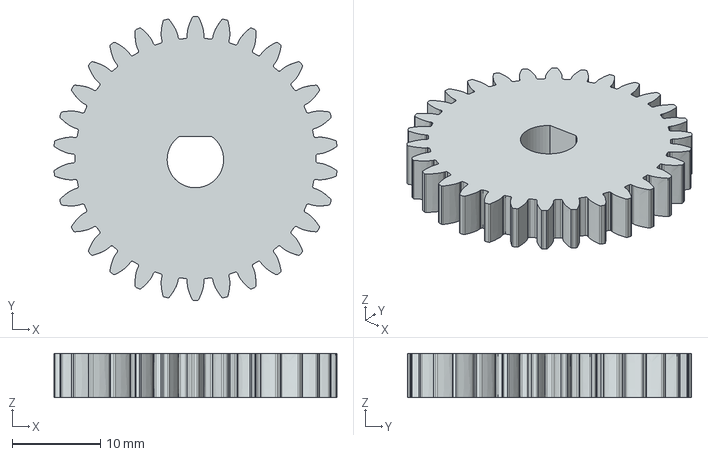
[picture p97: CAD file, 2025-05-17]
Cad models/X-axis Motor holder/X AXIS ASSEMBLY/gear 1.stp
32.1 x 32.2 x 5.00 mm
