maxutko1/semester-project-2-/Pressure Tank/fittings-1-2-1.snapshot.18/VTr.131.STEP

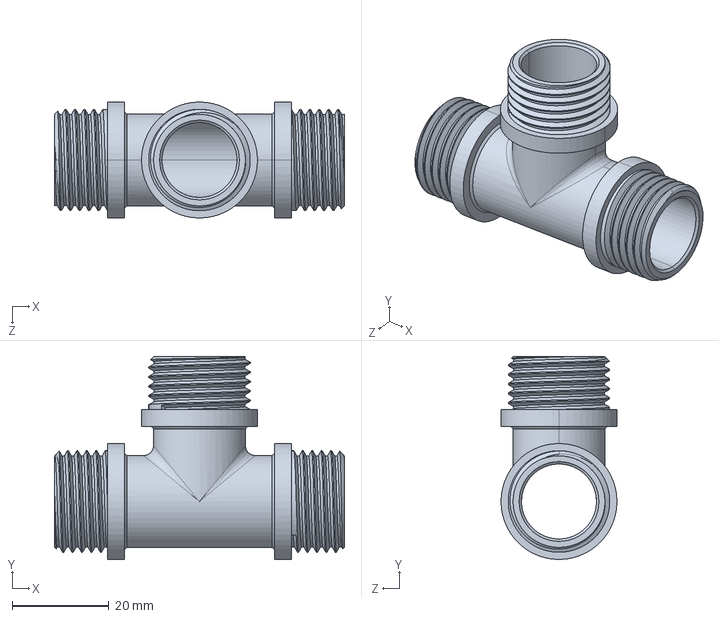
[picture p98: CAD file, 2025-05-20]
Pressure Tank/fittings-1-2-1.snapshot.18/VTr.131.STEP
60.0 x 42.0 x 24.0 mm
