maxutko1/semester-project-2-/Absolutely every .stl/Y-axis new.stl

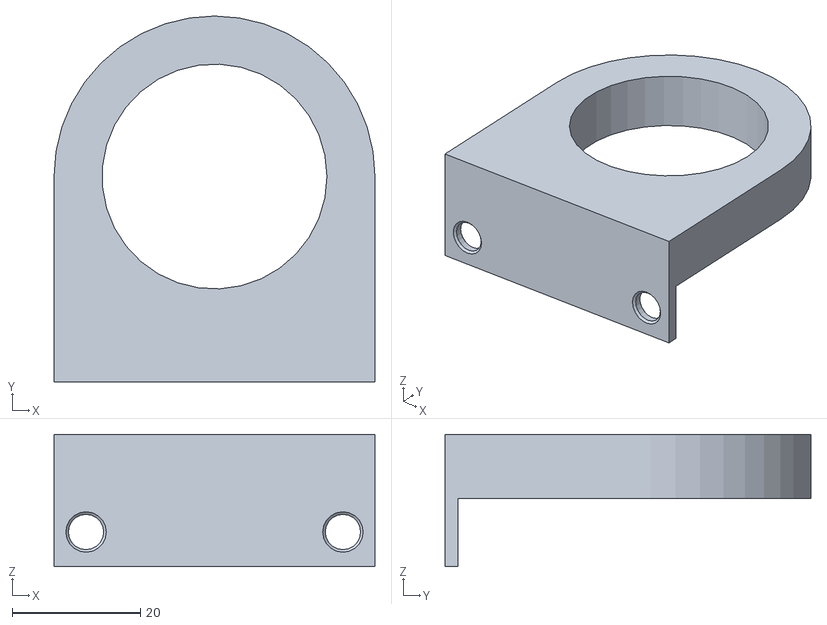
[picture p99: CAD file, 2025-05-21]
Absolutely every .stl/Y-axis new.stl
50.0 x 57.0 x 20.6
