maxutko1/semester-project-2-/Cad models/dual-axis-xy-joystick-module-with-push-button-1.snapshot.1/Joystick/tactileswitch-short.SLDPRT

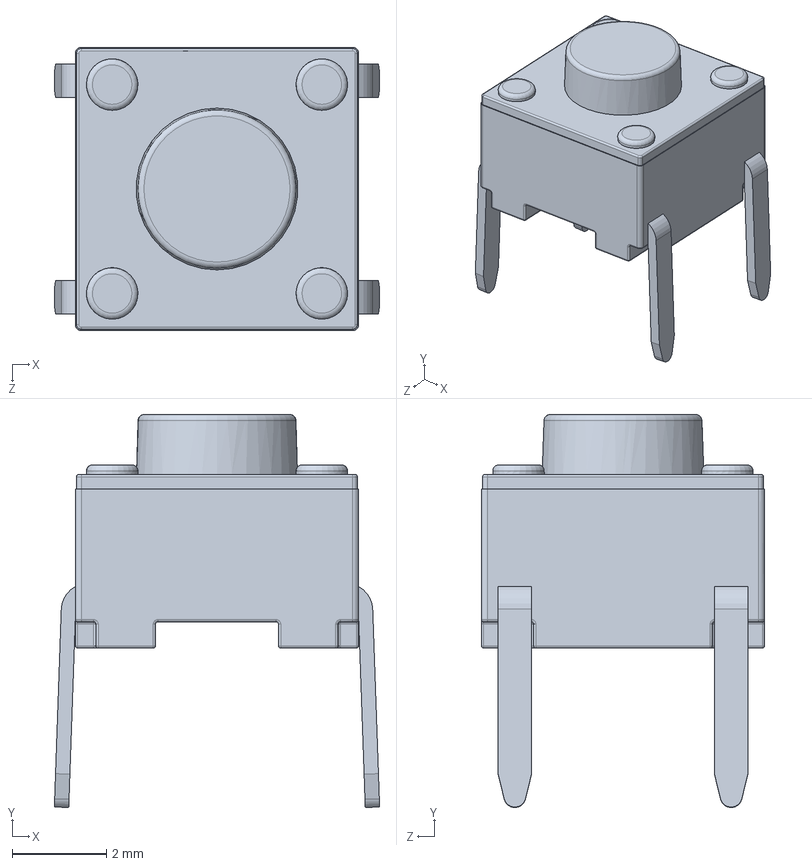
[picture p100: CAD file, 2025-04-01]
Cad models/dual-axis-xy-joystick-module-with-push-button-1.snapshot.1/Joystick/tactileswitch-short.SLDPRT
6.89 x 8.33 x 6.01 mm
