maxutko1/semester-project-2-/Cad models/X-axis Motor holder/X AXIS ASSEMBLY/gear 2.stp

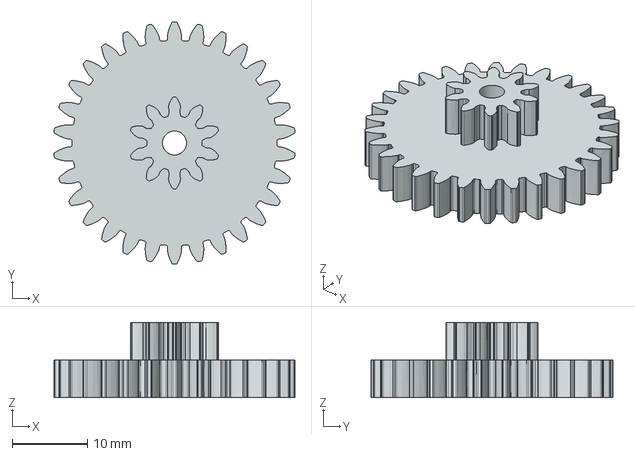
[picture p101: CAD file, 2025-05-17]
Cad models/X-axis Motor holder/X AXIS ASSEMBLY/gear 2.stp
32.1 x 32.2 x 10.0 mm
