maxutko1/semester-project-2-/Pressure Tank/fittings-1-2-1.snapshot.18/VT.151.STEP

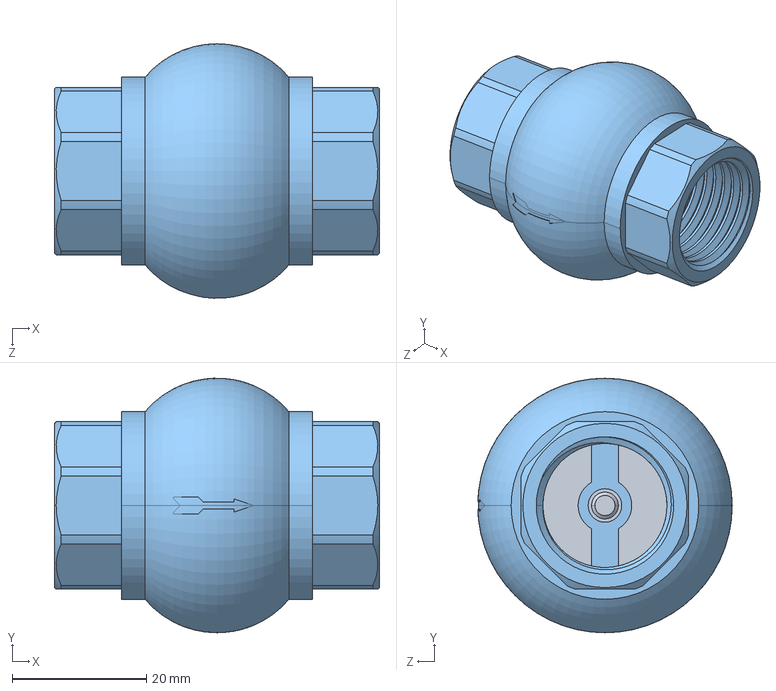
[picture p102: CAD file, 2025-05-20]
Pressure Tank/fittings-1-2-1.snapshot.18/VT.151.STEP
48.5 x 38.0 x 38.0 mm
