maxutko1/semester-project-2-/Cad models/dual-axis-xy-joystick-module-with-push-button-1.snapshot.1/Joystick/joystickhead.SLDPRT

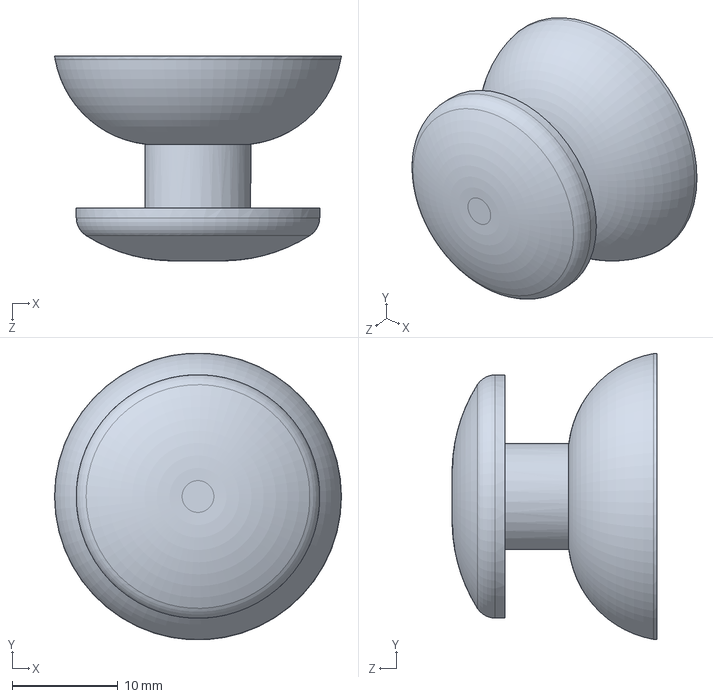
[picture p103: CAD file, 2025-04-01]
Cad models/dual-axis-xy-joystick-module-with-push-button-1.snapshot.1/Joystick/joystickhead.SLDPRT
27.1 x 27.1 x 19.3 mm
