maxutko1/semester-project-2-/Pressure Tank/fittings-1-2-1.snapshot.18/VTr.582.STEP

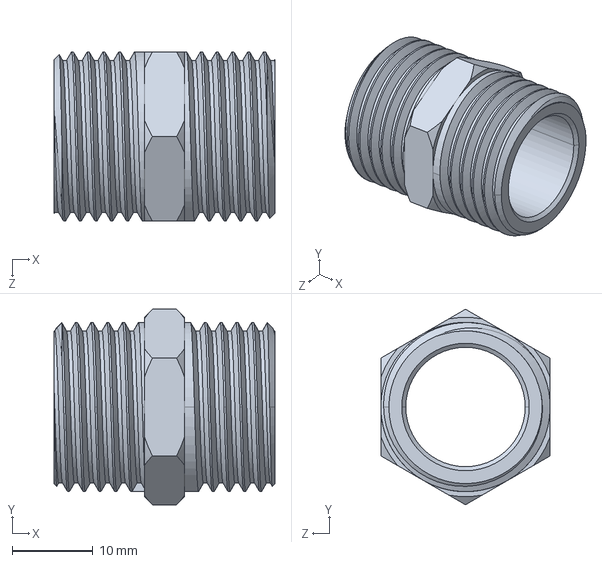
[picture p104: CAD file, 2025-05-20]
Pressure Tank/fittings-1-2-1.snapshot.18/VTr.582.STEP
27.4 x 24.2 x 21.0 mm
