maxutko1/semester-project-2-/Absolutely every .stl/Connecting Cylinder_1 with holes.stl

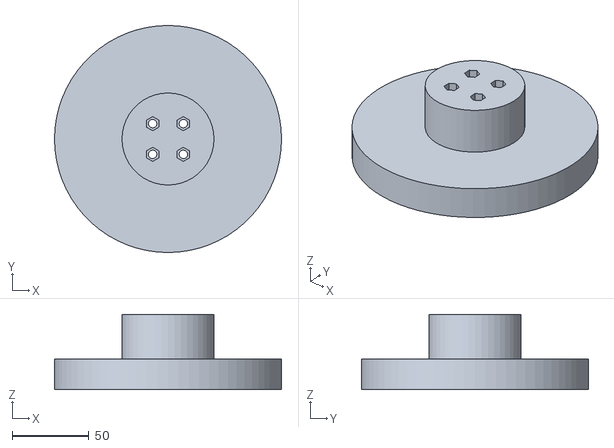
[picture p105: CAD file, 2025-05-21]
Absolutely every .stl/Connecting Cylinder_1 with holes.stl
148.0 x 148.0 x 49.0
