maxutko1/semester-project-2-/Pressure Tank/fittings-1-2-1.snapshot.18/VTr.091.STEP

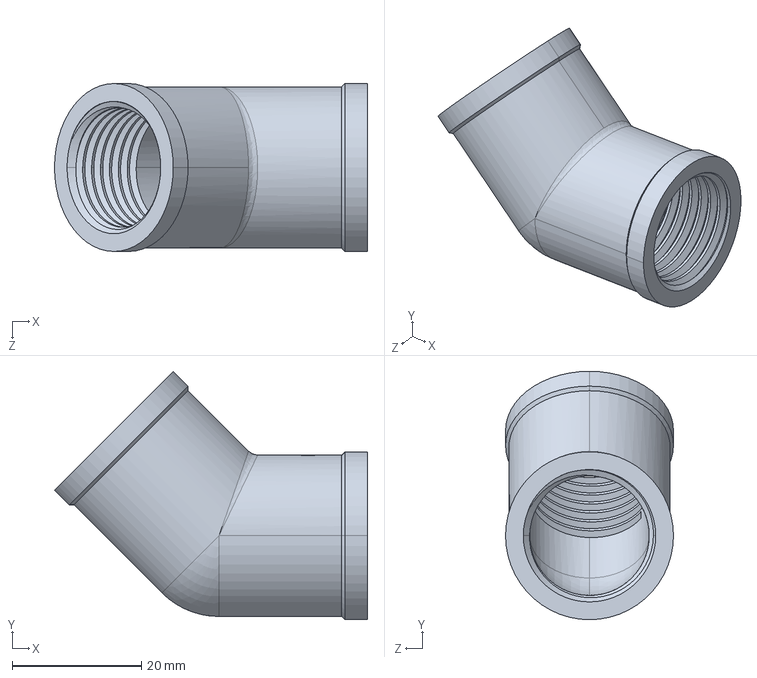
[picture p106: CAD file, 2025-05-20]
Pressure Tank/fittings-1-2-1.snapshot.18/VTr.091.STEP
48.5 x 38.5 x 26.0 mm
