maxutko1/semester-project-2-/Absolutely every .stl/axel for x axis turning.stl

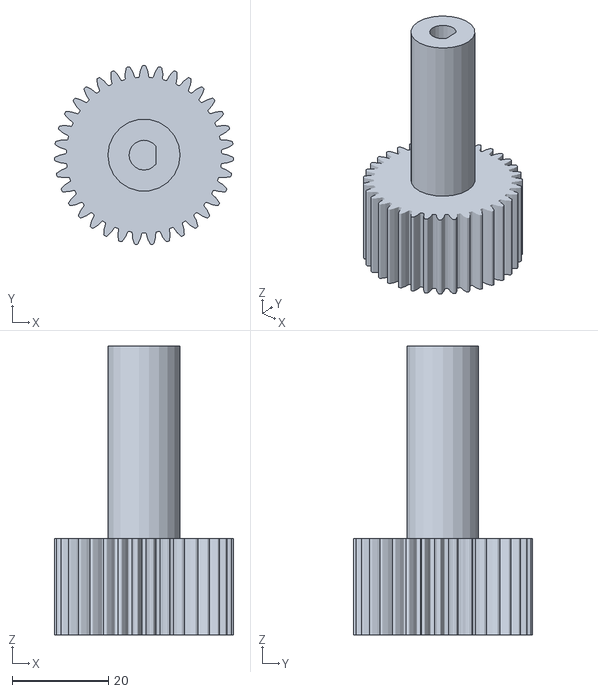
[picture p107: CAD file, 2025-05-20]
Absolutely every .stl/axel for x axis turning.stl
37.2 x 37.1 x 60.0
