maxutko1/semester-project-2-/Absolutely every .stl/y axis holder part 2.stl

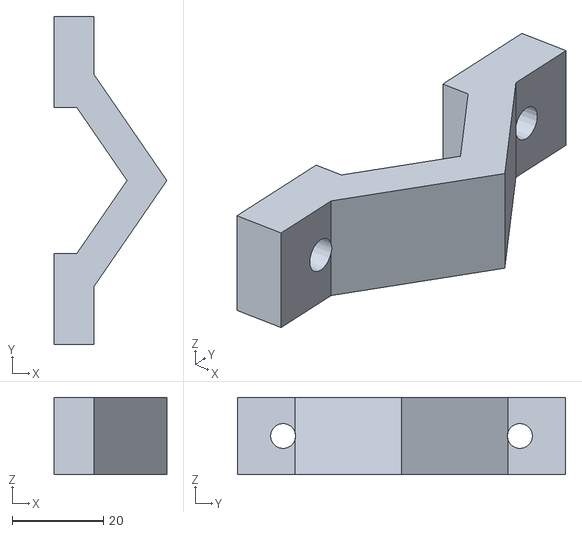
[picture p109: CAD file, 2025-05-20]
Absolutely every .stl/y axis holder part 2.stl
24.8 x 72.0 x 17.0
