maxutko1/semester-project-2-/Pressure Tank/fittings-1-2-1.snapshot.18/VTr.592.STEP

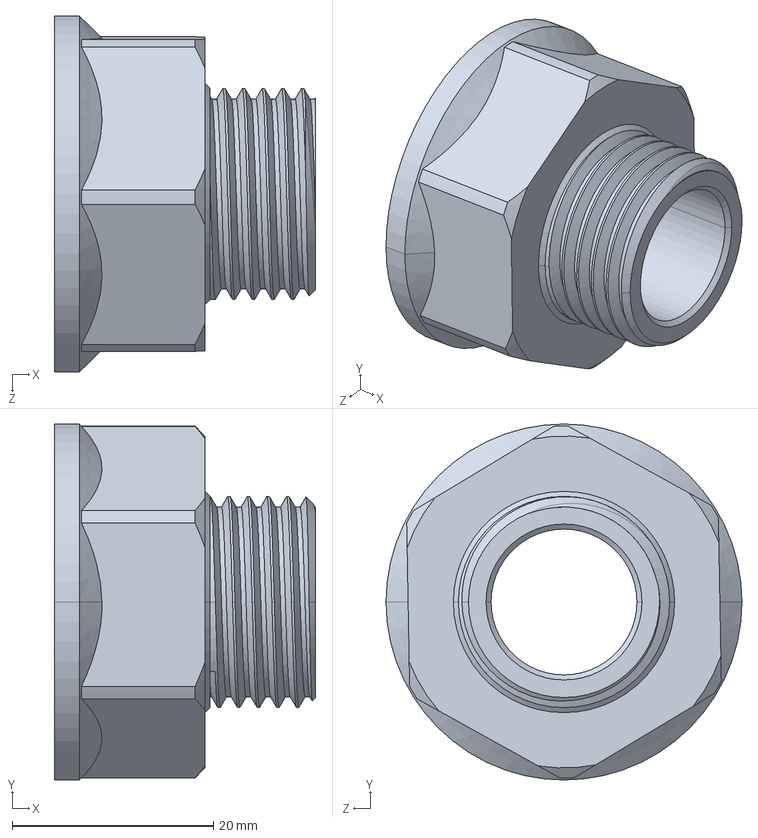
[picture p110: CAD file, 2025-05-20]
Pressure Tank/fittings-1-2-1.snapshot.18/VTr.592.STEP
26.0 x 35.4 x 35.4 mm
