maxutko1/semester-project-2-/Absolutely every .stl/base for big bearing.stl

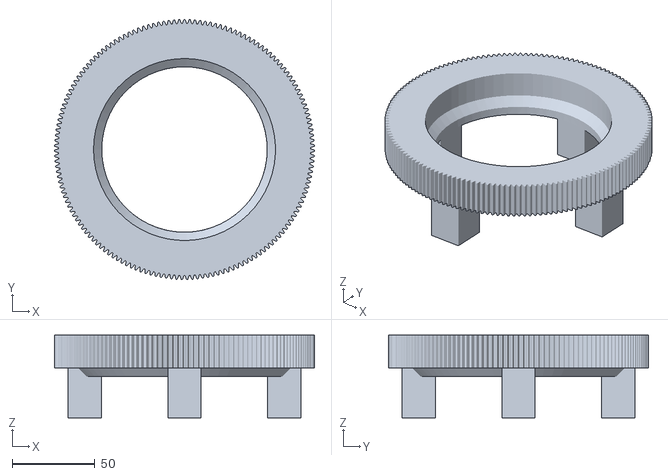
[picture p111: CAD file, 2025-05-20]
Absolutely every .stl/base for big bearing.stl
157.2 x 157.2 x 50.0
