maxutko1/semester-project-2-/Pressure Tank/fittings-1-2-1.snapshot.18/VTr.650.STEP

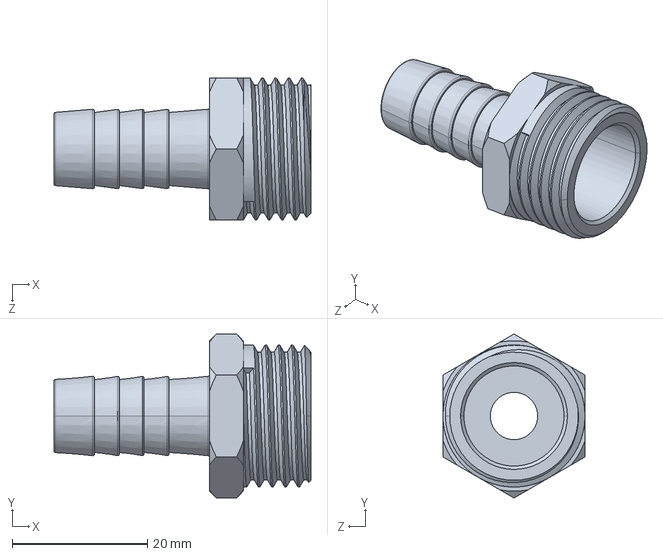
[picture p112: CAD file, 2025-05-20]
Pressure Tank/fittings-1-2-1.snapshot.18/VTr.650.STEP
38.0 x 24.2 x 21.0 mm
