maxutko1/semester-project-2-/Absolutely every .stl/new y axis_1.stl

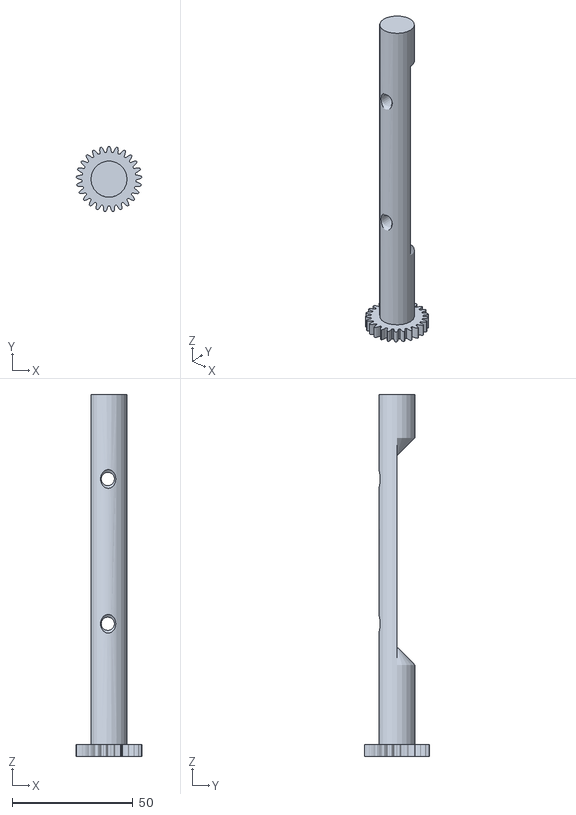
[picture p113: CAD file, 2025-05-20]
Absolutely every .stl/new y axis_1.stl
27.2 x 27.1 x 150.0
