maxutko1/semester-project-2-/Pressure Tank/fittings-1-2-1.snapshot.18/VT.388.STEP

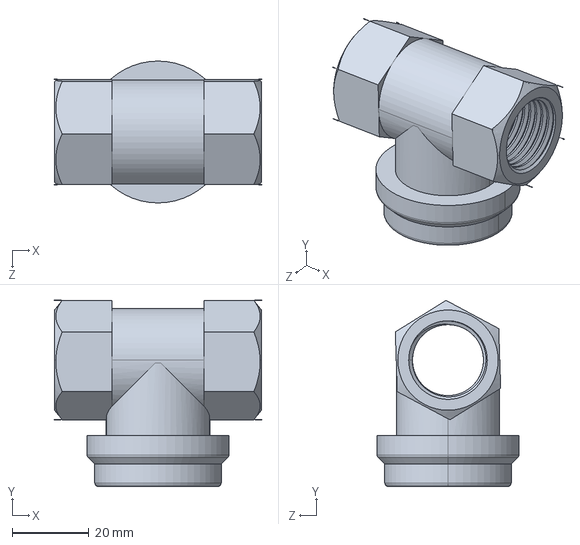
[picture p114: CAD file, 2025-05-20]
Pressure Tank/fittings-1-2-1.snapshot.18/VT.388.STEP
54.0 x 48.6 x 37.0 mm
