maxutko1/semester-project-2-/Absolutely every .stl/motor right part.stl

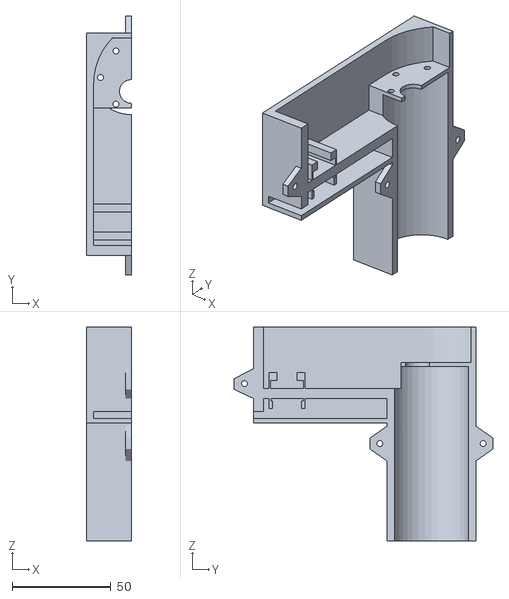
[picture p115: CAD file, 2025-05-16]
Absolutely every .stl/motor right part.stl
22.5 x 130.9 x 108.1
