maxutko1/semester-project-2-/Absolutely every .stl/base.stl

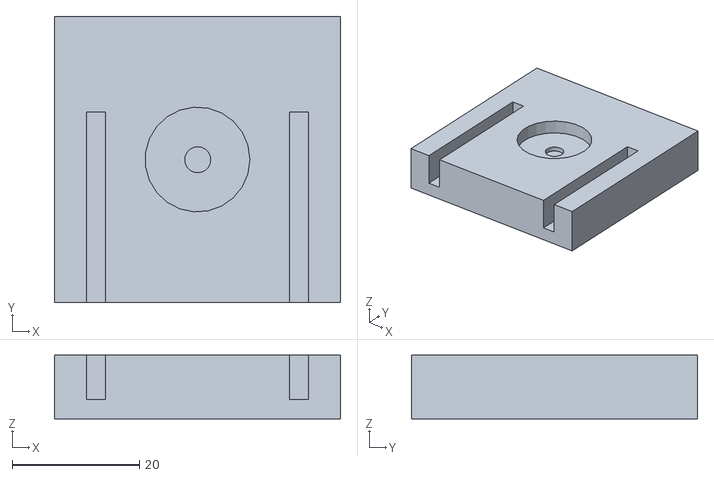
[picture p116: CAD file, 2025-05-15]
Absolutely every .stl/base.stl
45.0 x 45.0 x 10.0
