maxutko1/semester-project-2-/Absolutely every .stl/lid model.stl

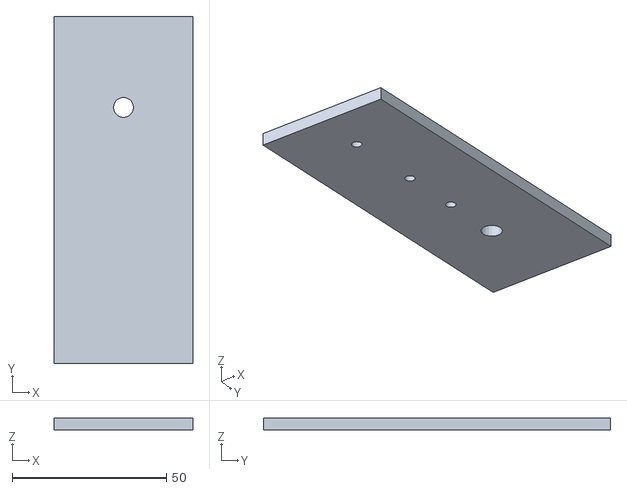
[picture p117: CAD file, 2025-05-15]
Absolutely every .stl/lid model.stl
45.0 x 112.5 x 4.00
