maxutko1/semester-project-2-/Absolutely every .stl/Holder 1 Part 1.stl

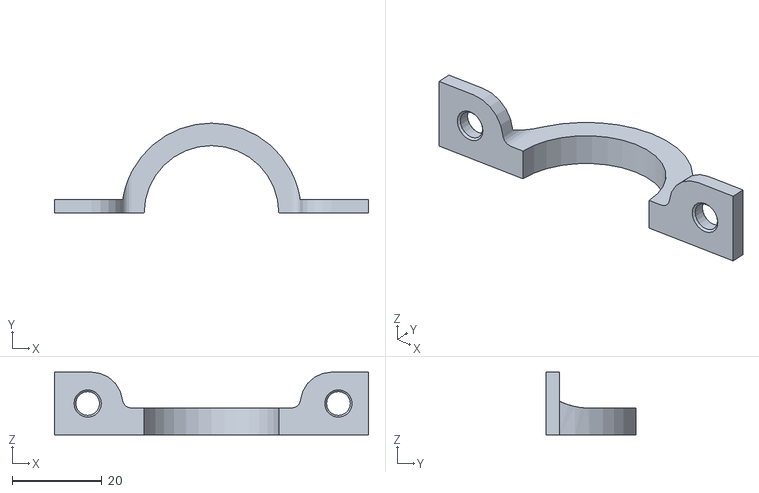
[picture p118: CAD file, 2025-05-15]
Absolutely every .stl/Holder 1 Part 1.stl
70.0 x 20.0 x 14.0
