maxutko1/semester-project-2-/Absolutely every .stl/Connecting Cylinder.stl

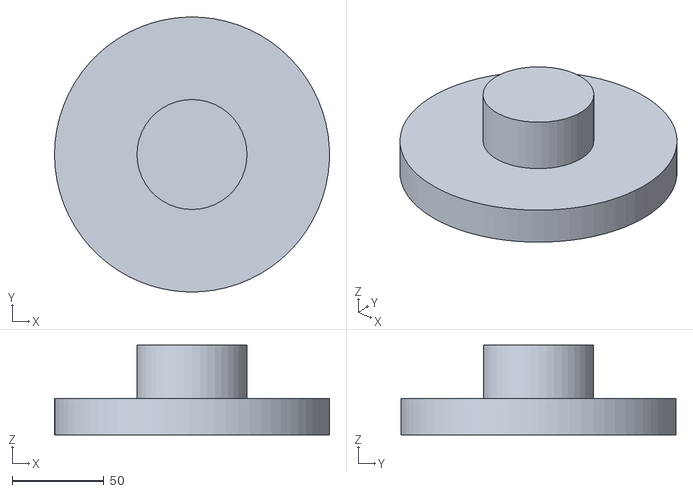
[picture p119: CAD file, 2025-05-15]
Absolutely every .stl/Connecting Cylinder.stl
150.0 x 150.0 x 49.0
