maxutko1/semester-project-2-/Absolutely every .stl/Holder 1 Part 2.stl

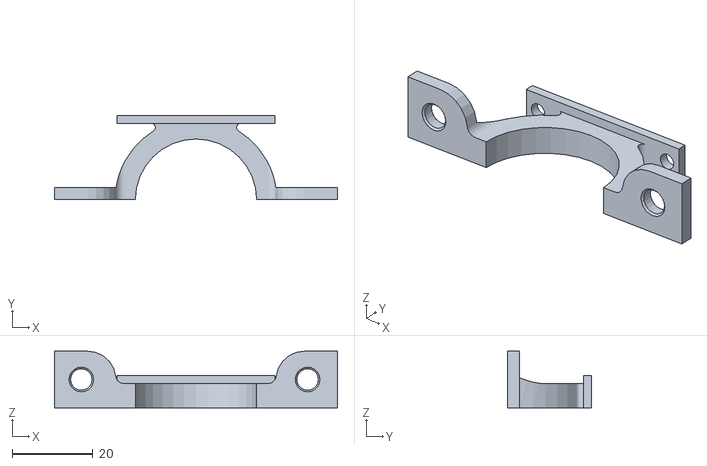
[picture p120: CAD file, 2025-05-15]
Absolutely every .stl/Holder 1 Part 2.stl
70.0 x 20.9 x 14.0
