maxutko1/semester-project-2-/Absolutely every .stl/mount on y axis part 1.stl

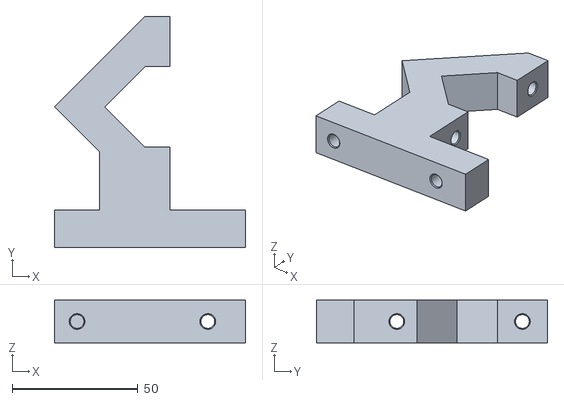
[picture p121: CAD file, 2025-05-15]
Absolutely every .stl/mount on y axis part 1.stl
76.0 x 92.0 x 17.0
