maxutko1/semester-project-2-/Absolutely every .stl/New Legs Holder.stl

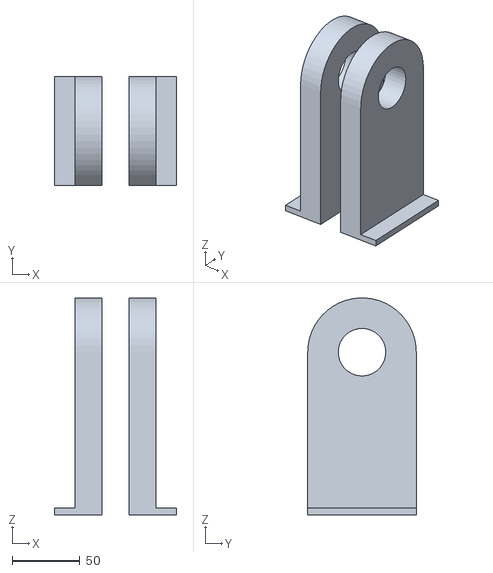
[picture p122: CAD file, 2025-05-15]
Absolutely every .stl/New Legs Holder.stl
90.0 x 80.0 x 159.9
