maxutko1/semester-project-2-/Absolutely every .stl/holder for pump 2.stl

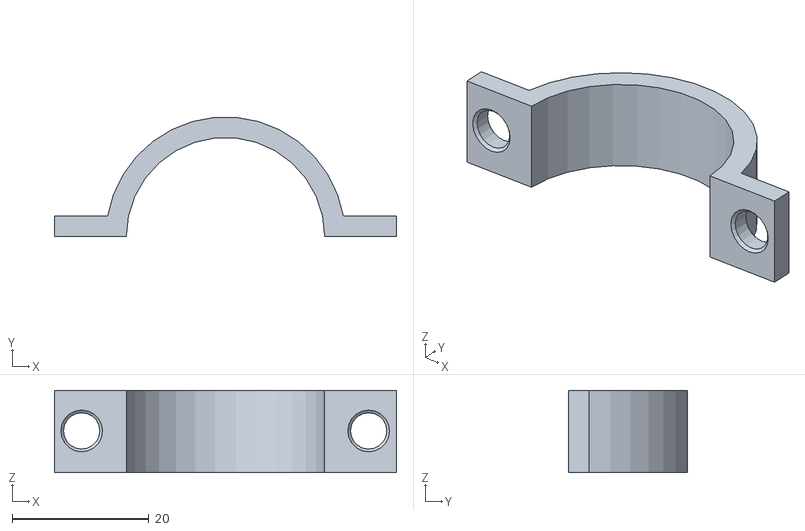
[picture p123: CAD file, 2025-05-13]
Absolutely every .stl/holder for pump 2.stl
50.0 x 17.4 x 12.0
