maxutko1/semester-project-2-/Absolutely every .stl/holder, new.stl

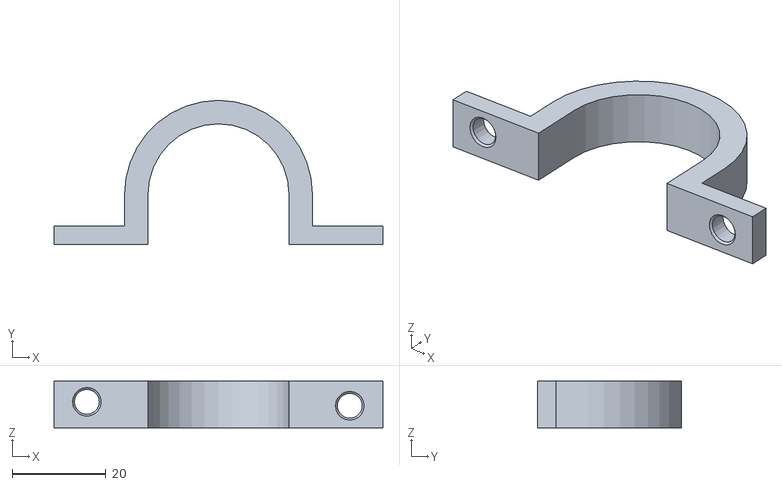
[picture p124: CAD file, 2025-05-13]
Absolutely every .stl/holder, new.stl
70.0 x 30.7 x 10.0
