maxutko1/semester-project-2-/Absolutely every .stl/holder for pump.stl

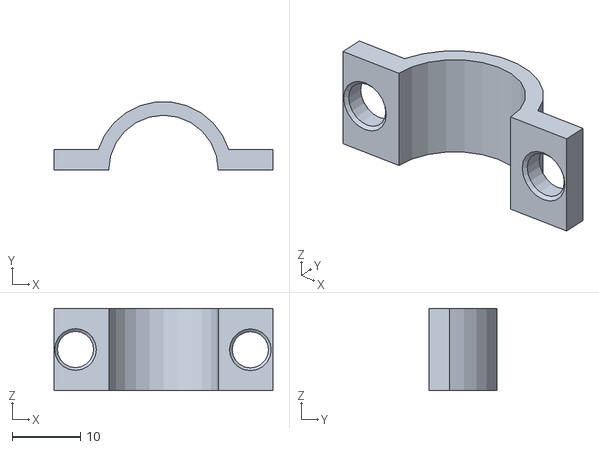
[picture p125: CAD file, 2025-05-13]
Absolutely every .stl/holder for pump.stl
32.0 x 9.93 x 12.0
