maxutko1/semester-project-2-/Absolutely every .stl/turn around mf.stl

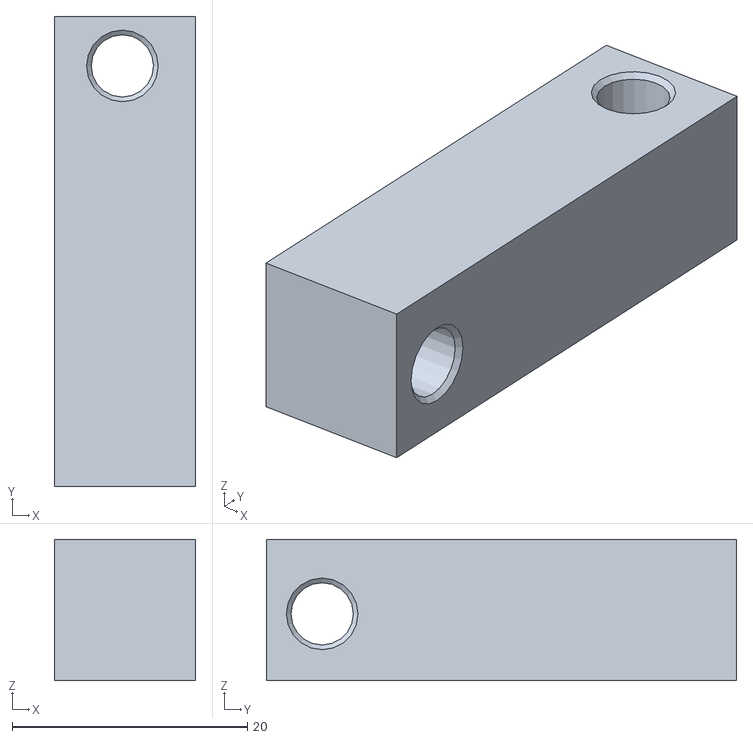
[picture p126: CAD file, 2025-05-13]
Absolutely every .stl/turn around mf.stl
12.0 x 40.0 x 12.0
