maxutko1/semester-project-2-/Absolutely every .stl/Holder.stl

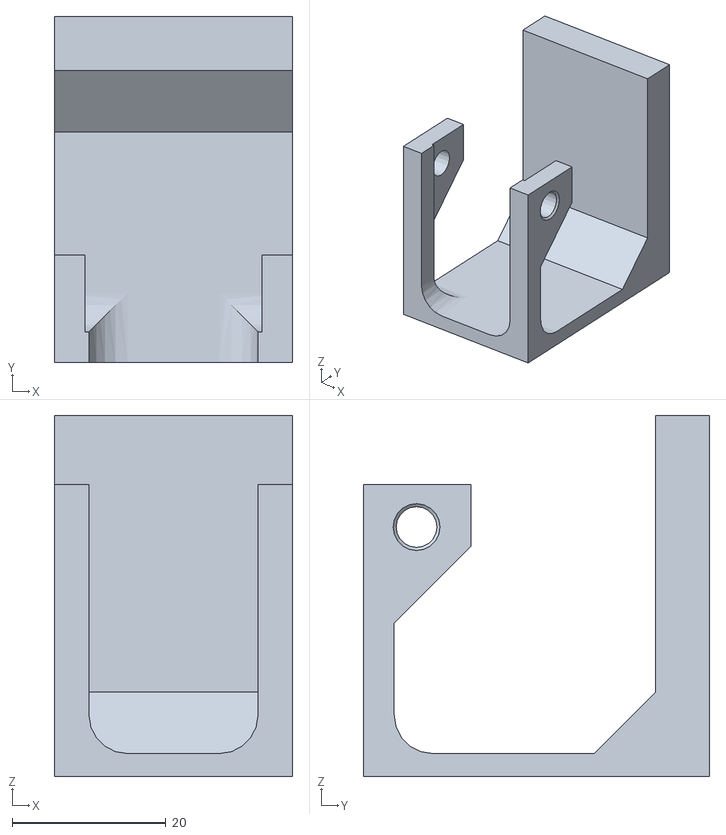
[picture p127: CAD file, 2025-05-12]
Absolutely every .stl/Holder.stl
31.0 x 45.0 x 47.0
