maxutko1/semester-project-2-/Absolutely every .stl/Pressure tank, 3d print. rev 007 STL.stl

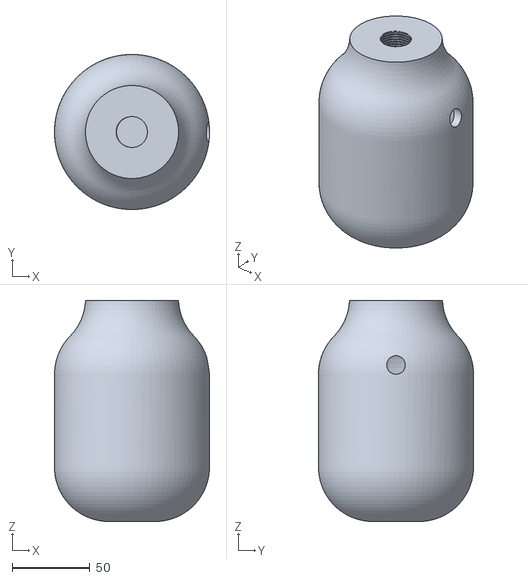
[picture p128: CAD file, 2025-05-12]
Absolutely every .stl/Pressure tank, 3d print. rev 007 STL.stl
100.0 x 100.0 x 142.5
