maxutko1/semester-project-2-/Absolutely every .stl/model1_2.stl

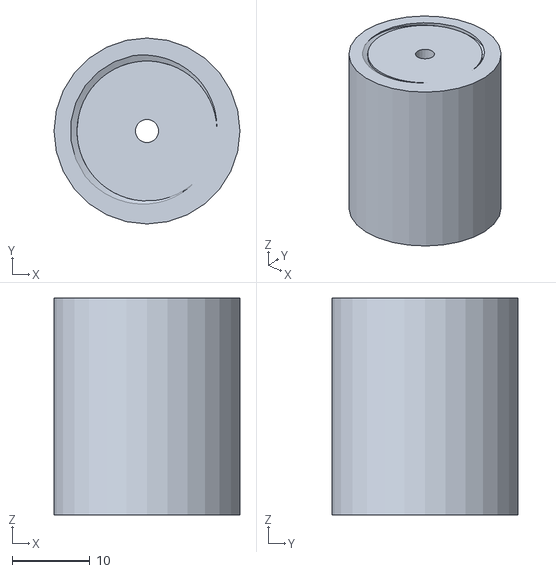
[picture p129: CAD file, 2025-05-12]
Absolutely every .stl/model1_2.stl
24.0 x 24.0 x 28.0
