maxutko1/semester-project-2-/Absolutely every .stl/Rotating Shaft.stl

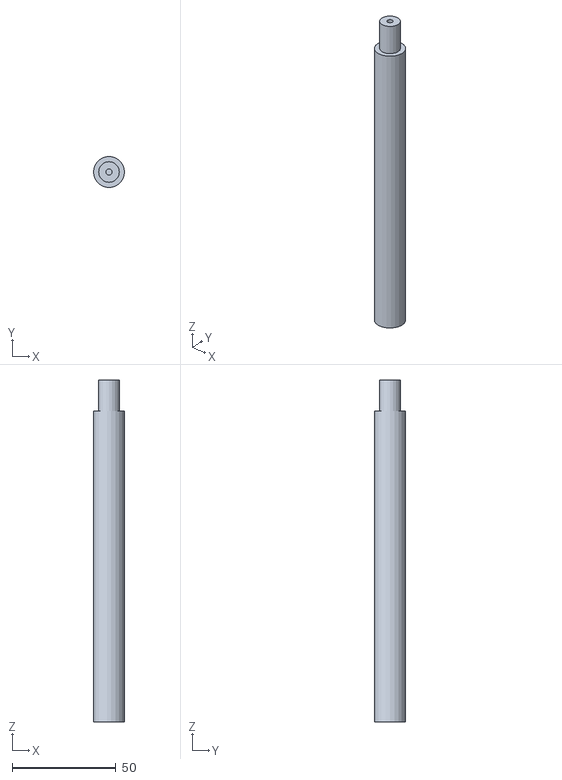
[picture p130: CAD file, 2025-05-12]
Absolutely every .stl/Rotating Shaft.stl
15.0 x 14.8 x 165.0
