maxutko1/semester-project-2-/Absolutely every .stl/Y-axis.stl

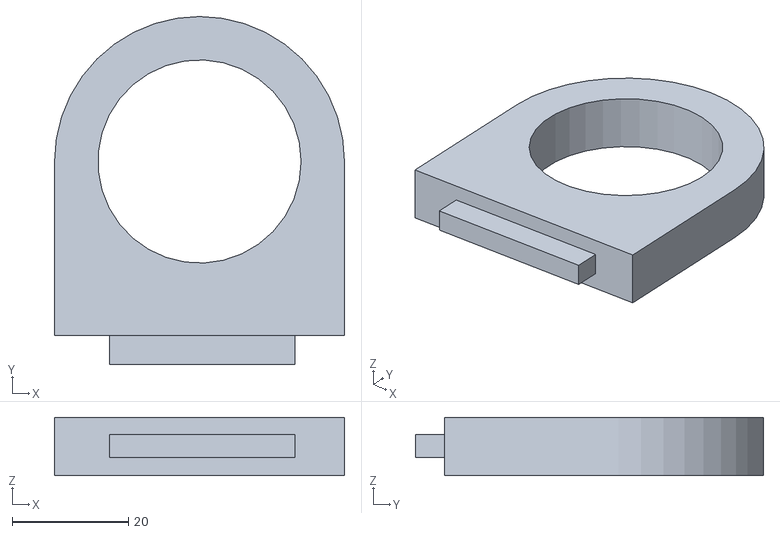
[picture p132: CAD file, 2025-05-12]
Absolutely every .stl/Y-axis.stl
50.0 x 60.0 x 10.0
