maxutko1/semester-project-2-/Absolutely every .stl/model1_4.stl

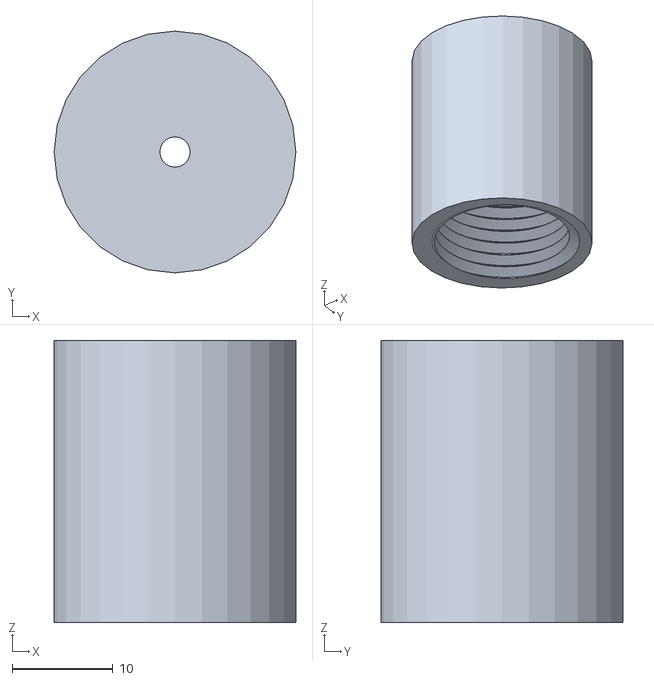
[picture p133: CAD file, 2025-05-12]
Absolutely every .stl/model1_4.stl
24.0 x 24.0 x 28.0
