maxutko1/semester-project-2-/Absolutely every .stl/model1_1.stl

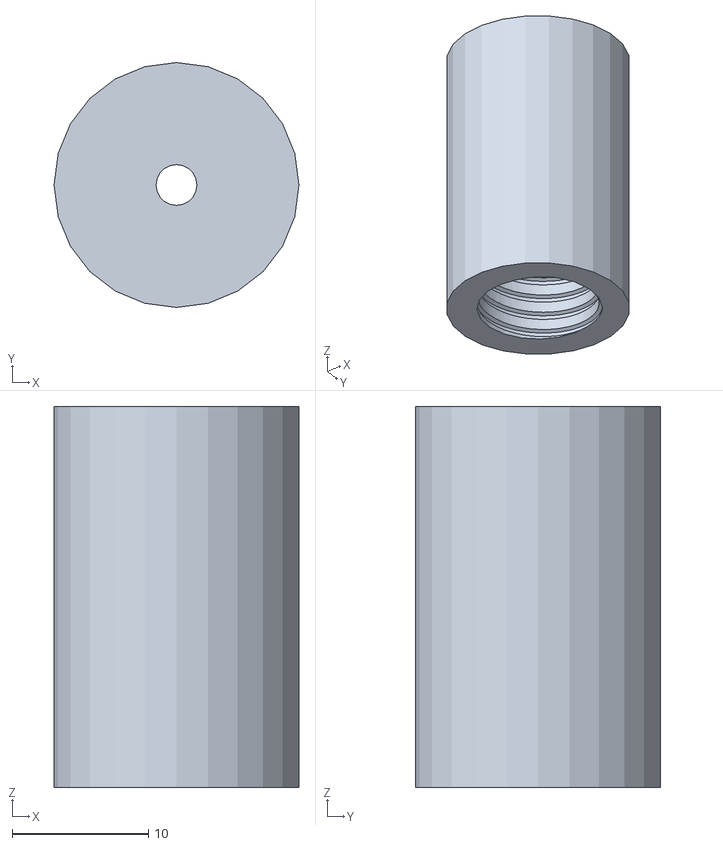
[picture p134: CAD file, 2025-05-12]
Absolutely every .stl/model1_1.stl
18.0 x 18.0 x 28.0
