maxutko1/semester-project-2-/Absolutely every .stl/Pressure tank, 3d print. rev 006.stl

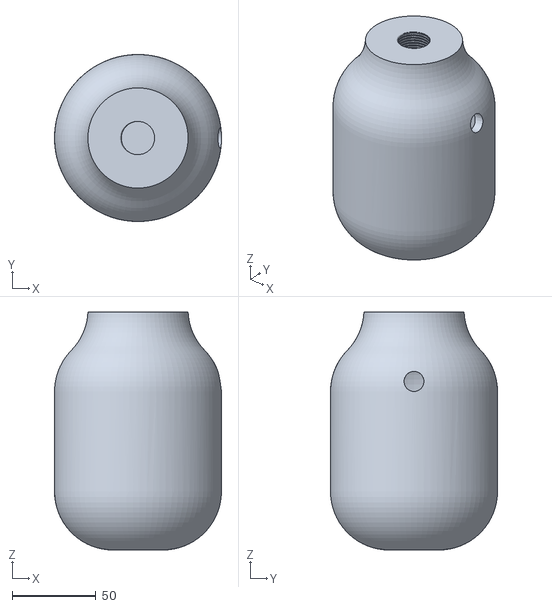
[picture p135: CAD file, 2025-05-12]
Absolutely every .stl/Pressure tank, 3d print. rev 006.stl
100.0 x 100.0 x 142.5
