maxutko1/semester-project-2-/Absolutely every .stl/model rev 4.stl

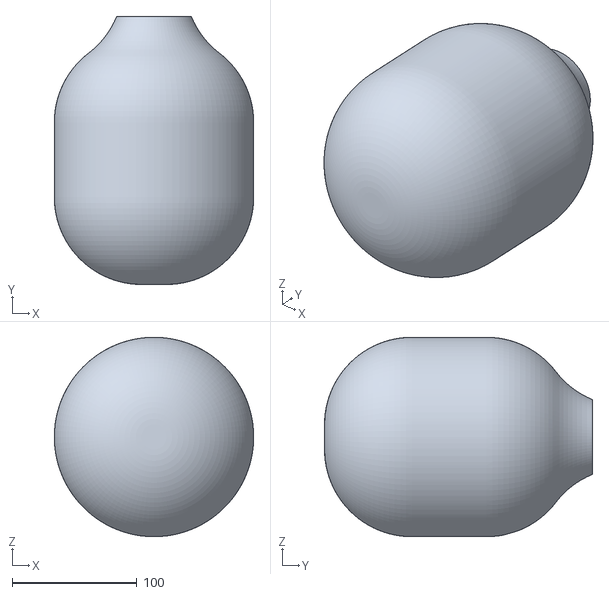
[picture p136: CAD file, 2025-05-12]
Absolutely every .stl/model rev 4.stl
160.0 x 215.0 x 160.0
