maxutko1/semester-project-2-/Absolutely every .stl/Tank Gasket.stl

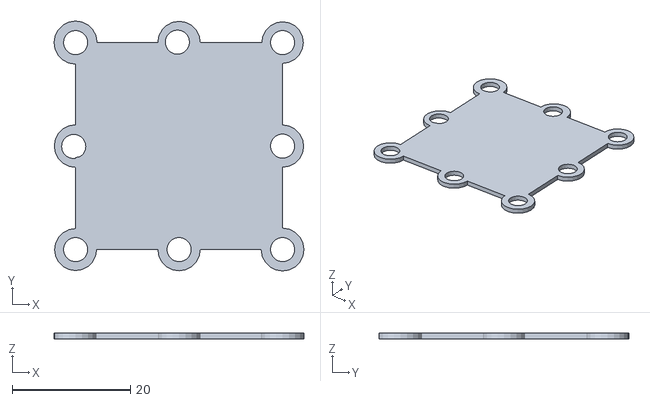
[picture p137: CAD file, 2025-03-26]
Absolutely every .stl/Tank Gasket.stl
42.3 x 42.3 x 1
