maxutko1/semester-project-2-/Absolutely every .stl/Tank Lid.stl

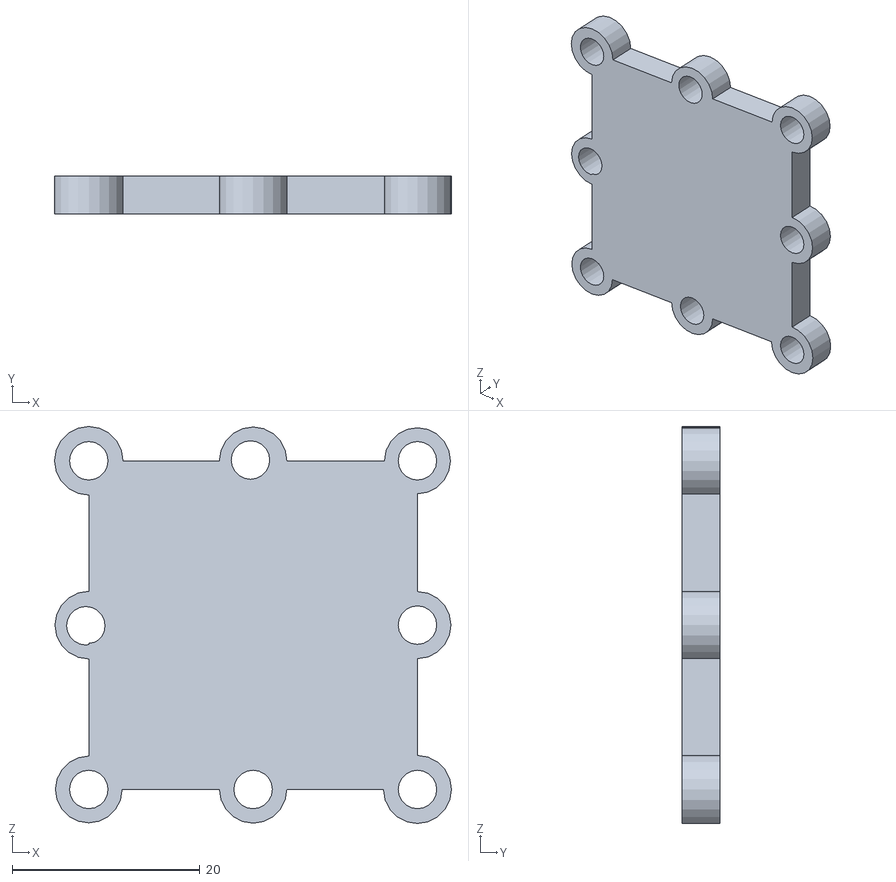
[picture p138: CAD file, 2025-03-25]
Absolutely every .stl/Tank Lid.stl
42.3 x 4.00 x 42.3
