maxutko1/semester-project-2-/Absolutely every .stl/model1.stl

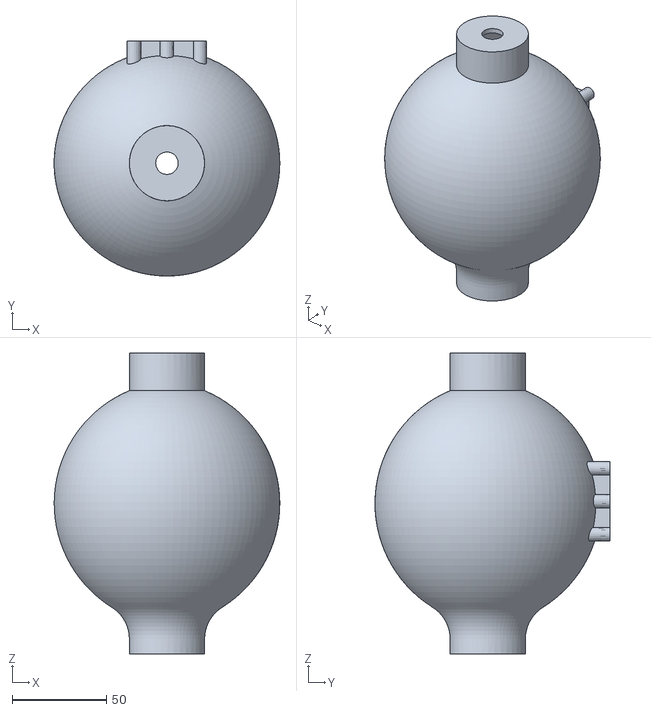
[picture p139: CAD file, 2025-03-25]
Absolutely every .stl/model1.stl
119.9 x 125.0 x 160.0
