maxutko1/semester-project-2-/Absolutely every .stl/Pressure tank, 3d print. rev 001 something new.stl

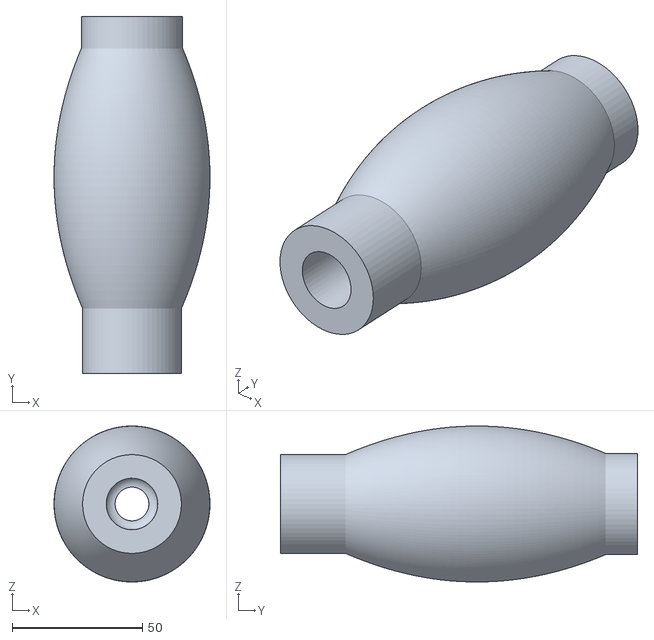
[picture p140: CAD file, 2025-03-22]
Absolutely every .stl/Pressure tank, 3d print. rev 001 something new.stl
60.0 x 137.3 x 60.0
