maxutko1/semester-project-2-/Absolutely every .stl/new bigger tank.stl

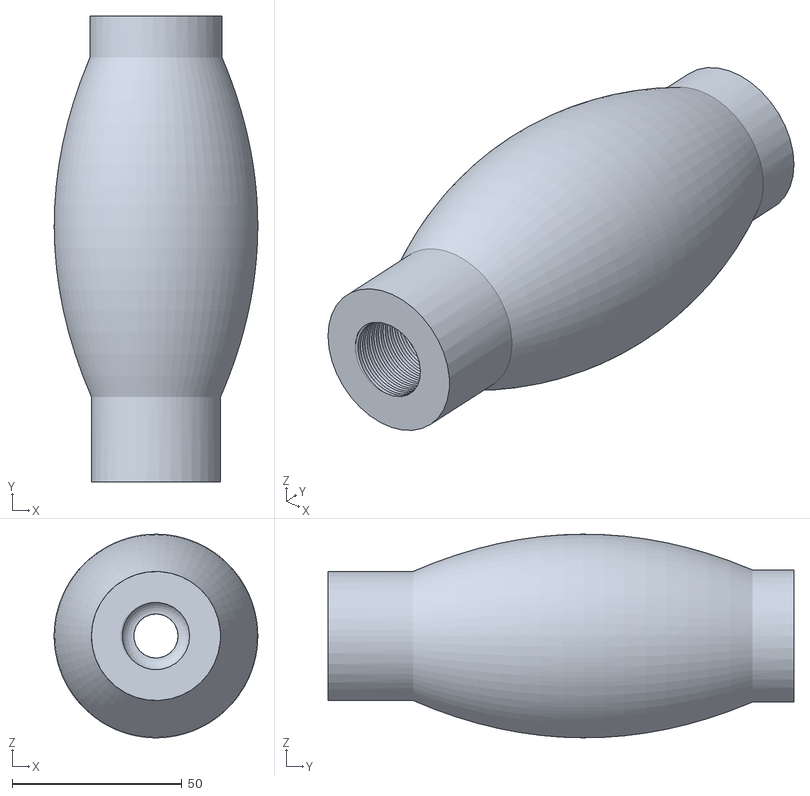
[picture p141: CAD file, 2025-03-22]
Absolutely every .stl/new bigger tank.stl
60.0 x 137.3 x 60.0
