maxutko1/semester-project-2-/(list of files, cad)

Other CAD files:
Pressure Tank/Tank gasket.gcode.3mf
Pressure Tank/Pressure tank, 3d print. rev 001.stp
Absolutely every .stl/new gear for encoder.stl
Absolutely every .stl/motor model.stl
Absolutely every .stl/nx pressure tank.stl
163119831-100-6202-2z/6202-2z.x_t
Absolutely every .prt/1m 20t gear.prt
Absolutely every .prt/22mm holder part 1.prt
Absolutely every .prt/30212 NX model.prt
Absolutely every .prt/32mm holder.prt
Absolutely every .prt/6-Pin Header - Male - 2.54mm.step (1).prt
Absolutely every .prt/6-Pin Header - Male - 2.54mm.step.prt
Absolutely every .prt/6202 bearing part 2.prt
Absolutely every .prt/6202 bearing.prt
Absolutely every .prt/6202.prt
Absolutely every .prt/90 degree bend.prt
Absolutely every .prt/90 degree turn.prt
Absolutely every .prt/ANSI B18.6.5M - 3.5 x 1.3 x 13 - B - I.prt
Absolutely every .prt/BMP388_Barometer v1_step.prt
Absolutely every .prt/Barometer.prt
Absolutely every .prt/Base.prt
Absolutely every .prt/Base_PCB.prt
Absolutely every .prt/Body.prt
Absolutely every .prt/Bosch BMP388.step.prt
Absolutely every .prt/Box Assembly.prt
Absolutely every .prt/Box shell.prt
Absolutely every .prt/Box side 1.prt
Absolutely every .prt/Box.prt
Absolutely every .prt/Cannon.prt
Absolutely every .prt/Connecting Cylinder.prt
Absolutely every .prt/Diaphram.prt
Absolutely every .prt/Entire assembly.prt
Absolutely every .prt/Frame.prt
Absolutely every .prt/Head(Rotational part).prt
Absolutely every .prt/JST-XH5-SMD.step.prt
Absolutely every .prt/Joystick Holder.prt
Absolutely every .prt/Joystick assembly_step.prt
Absolutely every .prt/Motor Holder lower - test.prt
Absolutely every .prt/New Legs Holder.prt
Absolutely every .prt/Pin.prt
Absolutely every .prt/Piston.prt
Absolutely every .prt/Plunger.prt
Absolutely every .prt/Pressure Plate.prt
Absolutely every .prt/Relay holder part 1.prt
Absolutely every .prt/Relay holder part 2.prt
Absolutely every .prt/Rotating Shaft.prt
Absolutely every .prt/SKF BALL BEARING 6202 15x35x11_step.prt
Absolutely every .prt/SOLENOID_FLUSH_step.prt
Absolutely every .prt/SOT23-5.stp.prt
Absolutely every .prt/SOT23-6.step.prt
Absolutely every .prt/Solenoid.prt
Absolutely every .prt/Thumb Joystick___.prt
Absolutely every .prt/Torret.prt
Absolutely every .prt/Turret Head.prt
Absolutely every .prt/Water level sensor_step.prt
Absolutely every .prt/Water tank Valve and tube.prt
Absolutely every .prt/Y-axis.prt
Absolutely every .prt/ada boks.prt
Absolutely every .prt/assembly of pressure tank.prt
Absolutely every .prt/assembly1.prt
Absolutely every .prt/axel for x axis turning.prt
Absolutely every .prt/base for big bearing.stl.prt
Absolutely every .prt/base plate that was laser cut model.prt
Absolutely every .prt/bearing holder for axel for x axis turning.prt
Absolutely every .prt/board.prt
Absolutely every .prt/body___.prt
Absolutely every .prt/box part 2.prt
Absolutely every .prt/connecting thread part.prt
Absolutely every .prt/encoder gear.prt
Absolutely every .prt/gear 1.prt
Absolutely every .prt/gear 2.prt
Absolutely every .prt/gear 3.prt
Absolutely every .prt/gears.prt
Absolutely every .prt/holder for tank.prt
Absolutely every .prt/holder for y axis motor.prt
Absolutely every .prt/holders for y axis motor rev 002.prt
Absolutely every .prt/i have no idea at this point bro.prt
Absolutely every .prt/joystickhead___.prt
Absolutely every .prt/model rev 3.prt
Absolutely every .prt/model turret base.prt
Absolutely every .prt/model y motor.prt
Absolutely every .prt/model1.prt
Absolutely every .prt/model4.prt
Absolutely every .prt/motor holder upper.prt
Absolutely every .prt/new y axis.prt
Absolutely every .prt/nozzle.prt
Absolutely every .prt/nx pressure tank v2.prt
Absolutely every .prt/nx pressure tank.prt
Absolutely every .prt/potentiometer___.prt
Absolutely every .prt/shaft.prt
Absolutely every .prt/smd_0603.step.prt
Absolutely every .prt/solenoid valve.prt
Absolutely every .prt/t piece.prt
Absolutely every .prt/tactileswitch-short.prt
Absolutely every .prt/x axis 2.0.prt
Absolutely every .prt/y axis holder part 1 rev 002.prt
Absolutely every .prt/y axis holder part 1.prt
Absolutely every .prt/y axis holder part 2 rev 002.prt
Absolutely every .prt/y axis holder part 2.prt
Absolutely every .stl/Pressure tank, 3d print. rev 001 STL.stl
Absolutely every .stl/Pressure tank, 3d print. rev 002 STL.stl
Absolutely every .stl/Pressure tank, 3d print. rev 003 STL.stl
Absolutely every .stl/Pressure tank, 3d print. rev 005.stl
Absolutely every .stl/base for big bearing.stl.prt
Cad models/160385048-100-skf_bearing_30202_2/skf_bearing_30202_2.x_t
Cad models/161059289-100-30212-a/30212-a.x_t
Cad models/16t gear.prt
Cad models/1m 20t gear.prt
Cad models/22mm holder part 1.prt
Cad models/25t gear.prt
Cad models/32mm holder.prt
Cad models/6202 bearing part 2.prt
Cad models/90 degree bend.prt
Cad models/90 degree turn.prt
Cad models/ANSI B18.6.5M - 3.5 x 1.3 x 13 - B - I.prt
Cad models/Body.prt
Cad models/Diaphram.prt
Cad models/Entire assembly.prt
Cad models/Frame.prt
Cad models/Piston.prt
Cad models/Plunger.prt
Cad models/Pressure Plate.prt
Cad models/Relay holder part 1.prt
Cad models/Relay holder part 2.prt
Cad models/Solenoid.prt
Cad models/Tank Model.prt
Cad models/X-axis Motor holder/X AXIS ASSEMBLY/Test Base.3mf
Cad models/X-axis Motor holder/X AXIS ASSEMBLY/Y-axis Base.3mf
Cad models/X-axis Motor holder/X AXIS ASSEMBLY/encoder gear.3mf
Cad models/X-axis Motor holder/x axis 2.0.prt
Cad models/assembly of pressure tank.prt
Cad models/assembly1.prt
Cad models/axel for x axis turning.prt
Cad models/base for big bearing.stl.prt
Cad models/base plate that was laser cut model.prt
Cad models/bearing holder for axel for x axis turning.prt
Cad models/connecting thread part.prt
Cad models/dual-axis-xy-joystick-module-with-push-button-1.snapshot.1/Joystick/Joystick assembly.SLDASM
Cad models/holder for tank.prt
Cad models/i have no idea at this point bro.prt
Cad models/model rev 3.prt
Cad models/model turret base.prt
Cad models/model y motor.prt
Cad models/model1.prt
Cad models/model4.prt
Cad models/new y axis.prt
Cad models/nozzle.prt
Cad models/nx pressure tank v2.prt
Cad models/nx pressure tank.prt
Cad models/ring between connecting cylinder and base.prt
Cad models/solenoid valve.prt
Cad models/t piece.prt
Cad models/water-level-sensor-5.snapshot.5/Water level sensor.f3d
Cad models/y axis holder part 1 rev 002.prt
Cad models/y axis holder part 1.prt
Cad models/y axis holder part 2 rev 002.prt
Cad models/y axis holder part 2.prt
Joystick stuff/Holder/Joystick Holder.prt
Joystick stuff/Holder/Joystick grip.prt
Joystick stuff/Holder/Manche V2.prt
Joystick stuff/Holder/assembly joystick.prt
Mock model for torret/Nueva carpeta/SKF BALL BEARING 6202 15x35x11.SLDPRT
Mock model for torret/Nueva carpeta/SKF BALL BEARING 6202 15x35x11.ipt
Mock model for torret/Y-axis.prt
Pressure Tank/OldVersions/Pressure tank, 3d print. rev 001 inventor file.0001.ipt
Pressure Tank/Pressure tank, 3d print. rev 001 inventor file.ipt
Pressure Tank/fittings-1-2-1.snapshot.18/VT.151.IGS
Pressure Tank/fittings-1-2-1.snapshot.18/VT.388.IGS
Pressure Tank/fittings-1-2-1.snapshot.18/VTr.090.IGS
Pressure Tank/fittings-1-2-1.snapshot.18/VTr.091.IGS
Pressure Tank/fittings-1-2-1.snapshot.18/VTr.093.IGS
Pressure Tank/fittings-1-2-1.snapshot.18/VTr.130.IGS
Pressure Tank/fittings-1-2-1.snapshot.18/VTr.131.IGS
Pressure Tank/fittings-1-2-1.snapshot.18/VTr.270.IGS
Pressure Tank/fittings-1-2-1.snapshot.18/VTr.582.IGS
Pressure Tank/fittings-1-2-1.snapshot.18/VTr.592.IGS
Pressure Tank/fittings-1-2-1.snapshot.18/VTr.650.IGS
Pressure Tank/fittings-1-2-1.snapshot.18/VTr.654.IGS
