maxutko1/semester-project-2-/Maschine Drawings/assembly joystick.mechdraw.pdf

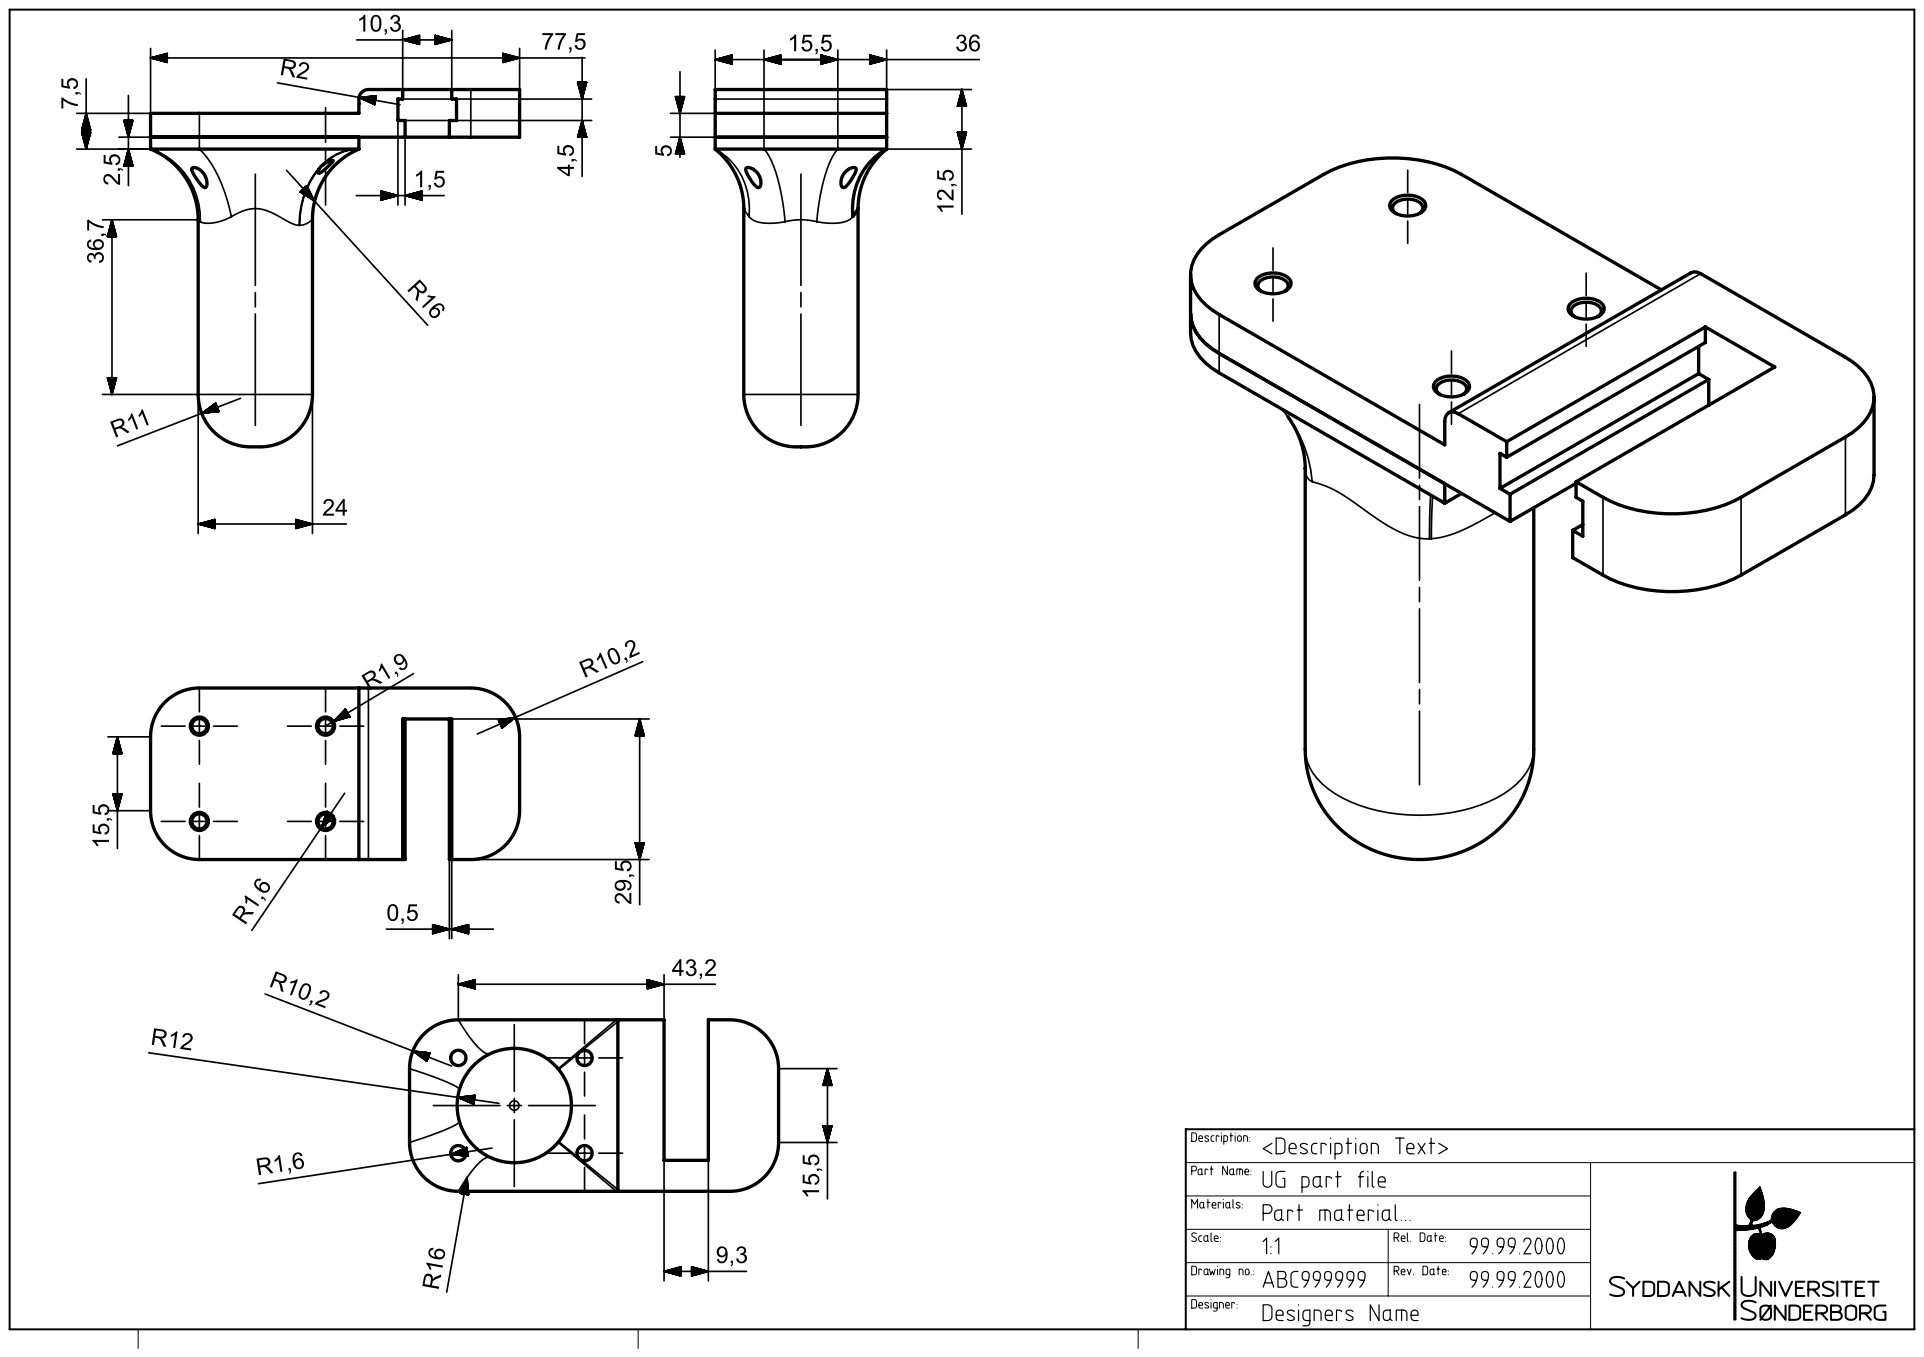
[picture p142: page 1]
