maxutko1/semester-project-2-/Apendix/All machine drawings.pdf

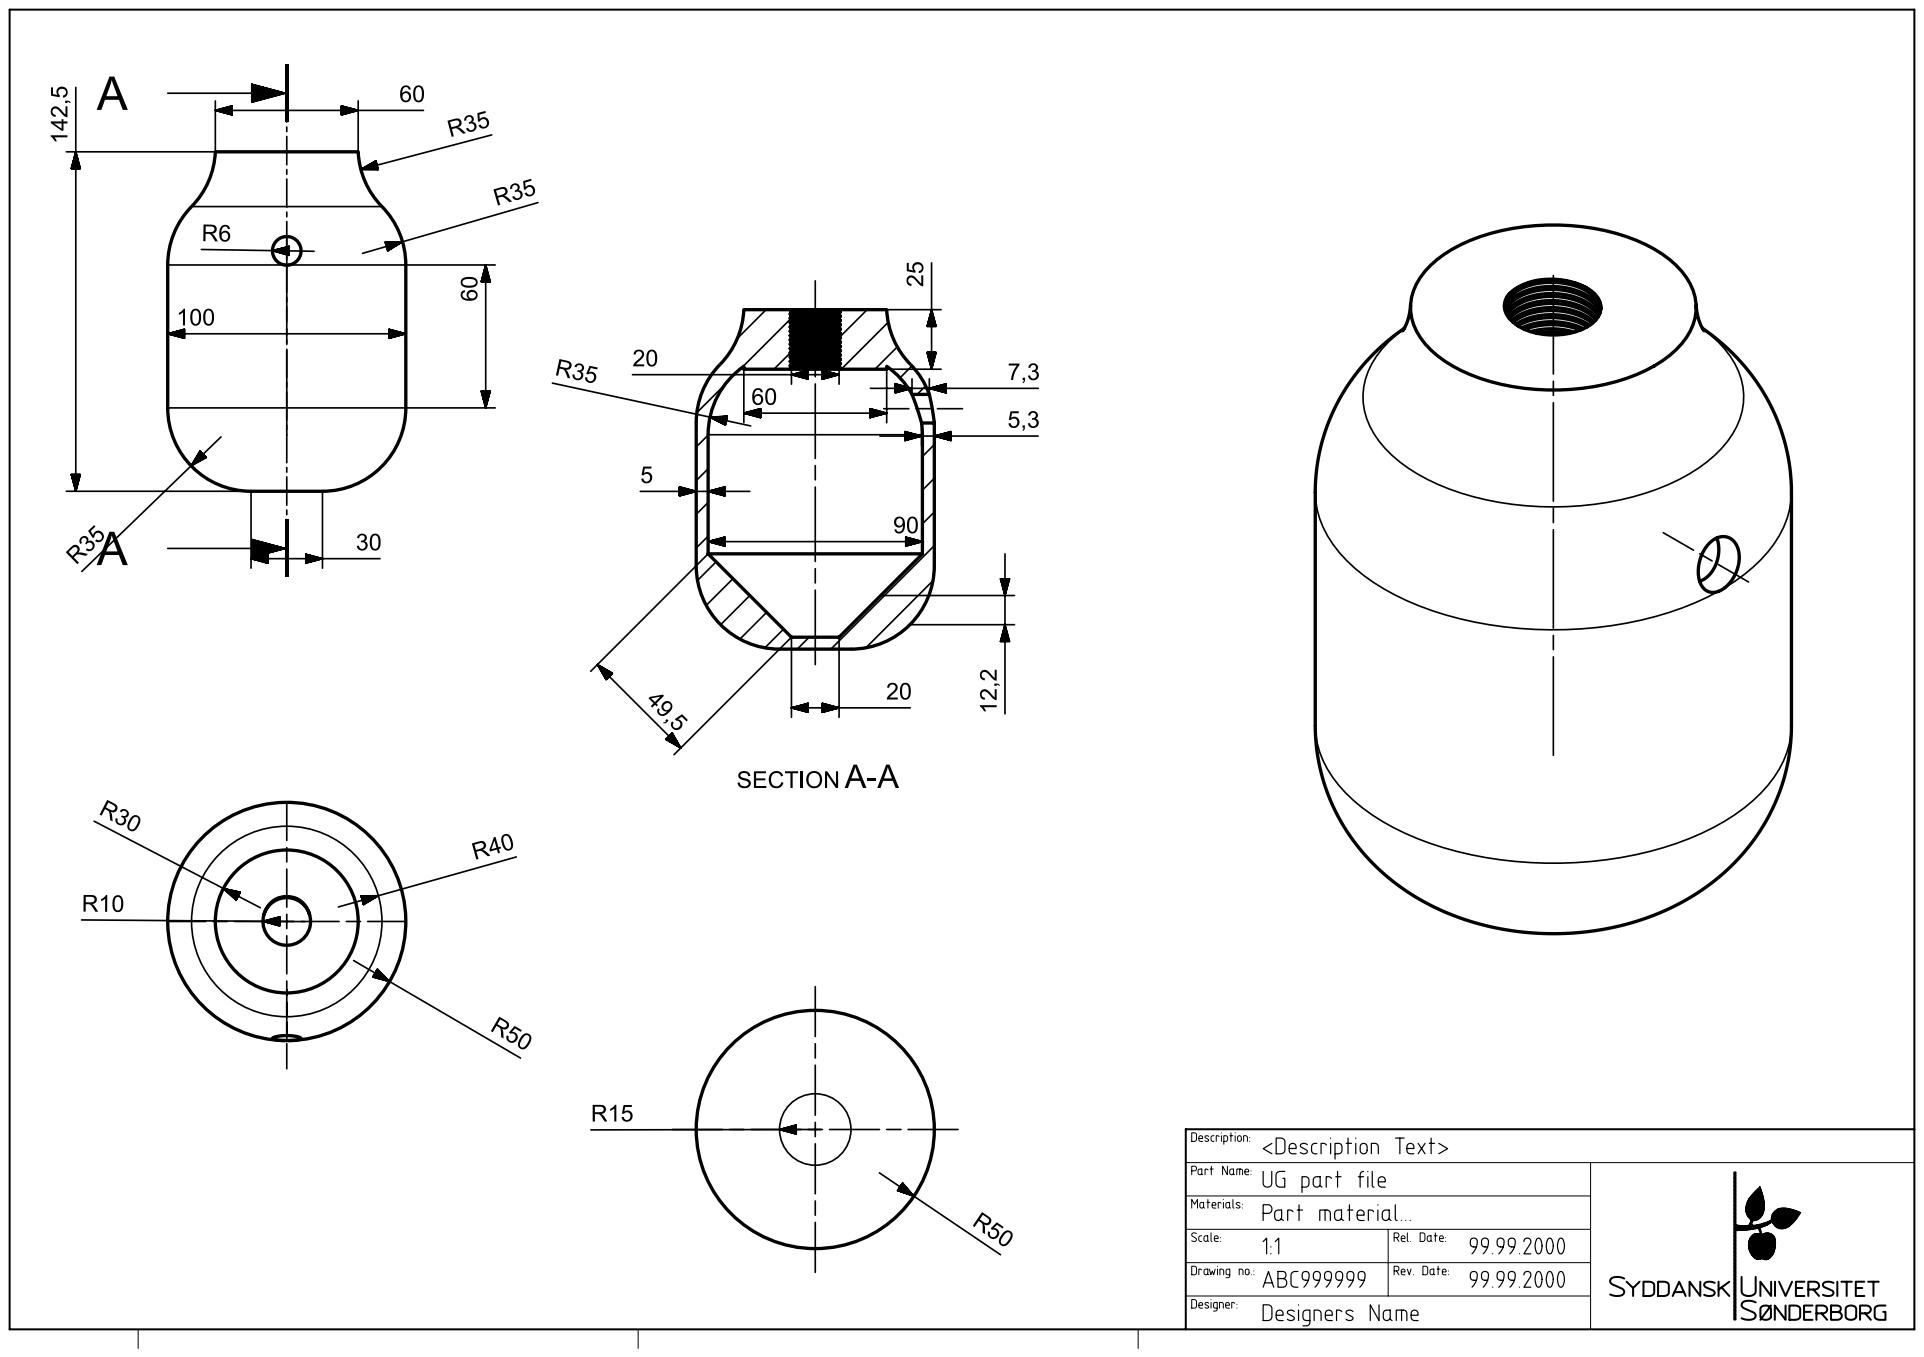
[picture p143: page 2]

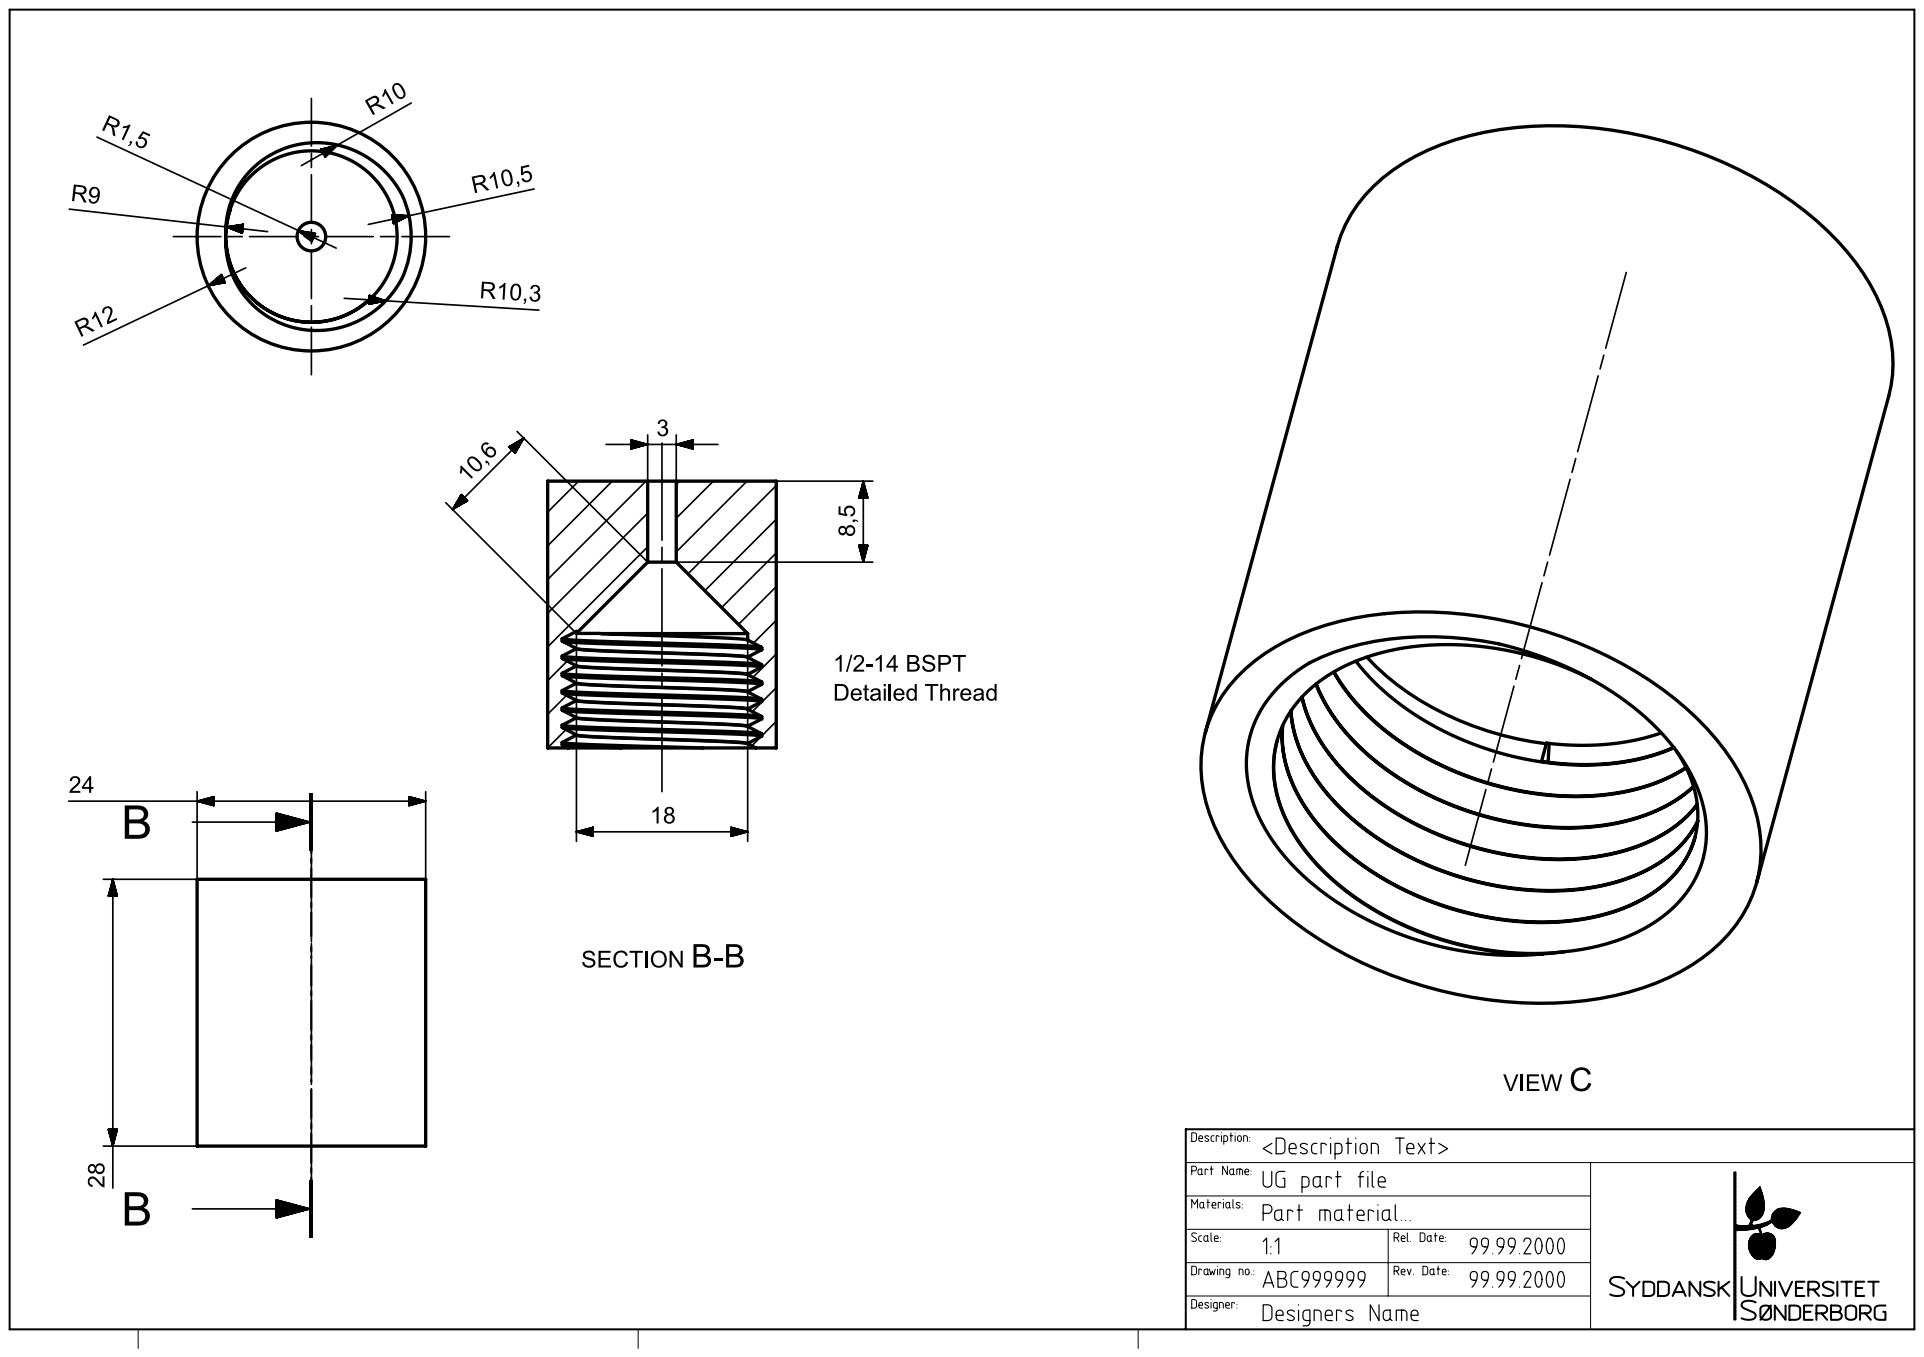
[picture p144: page 3]

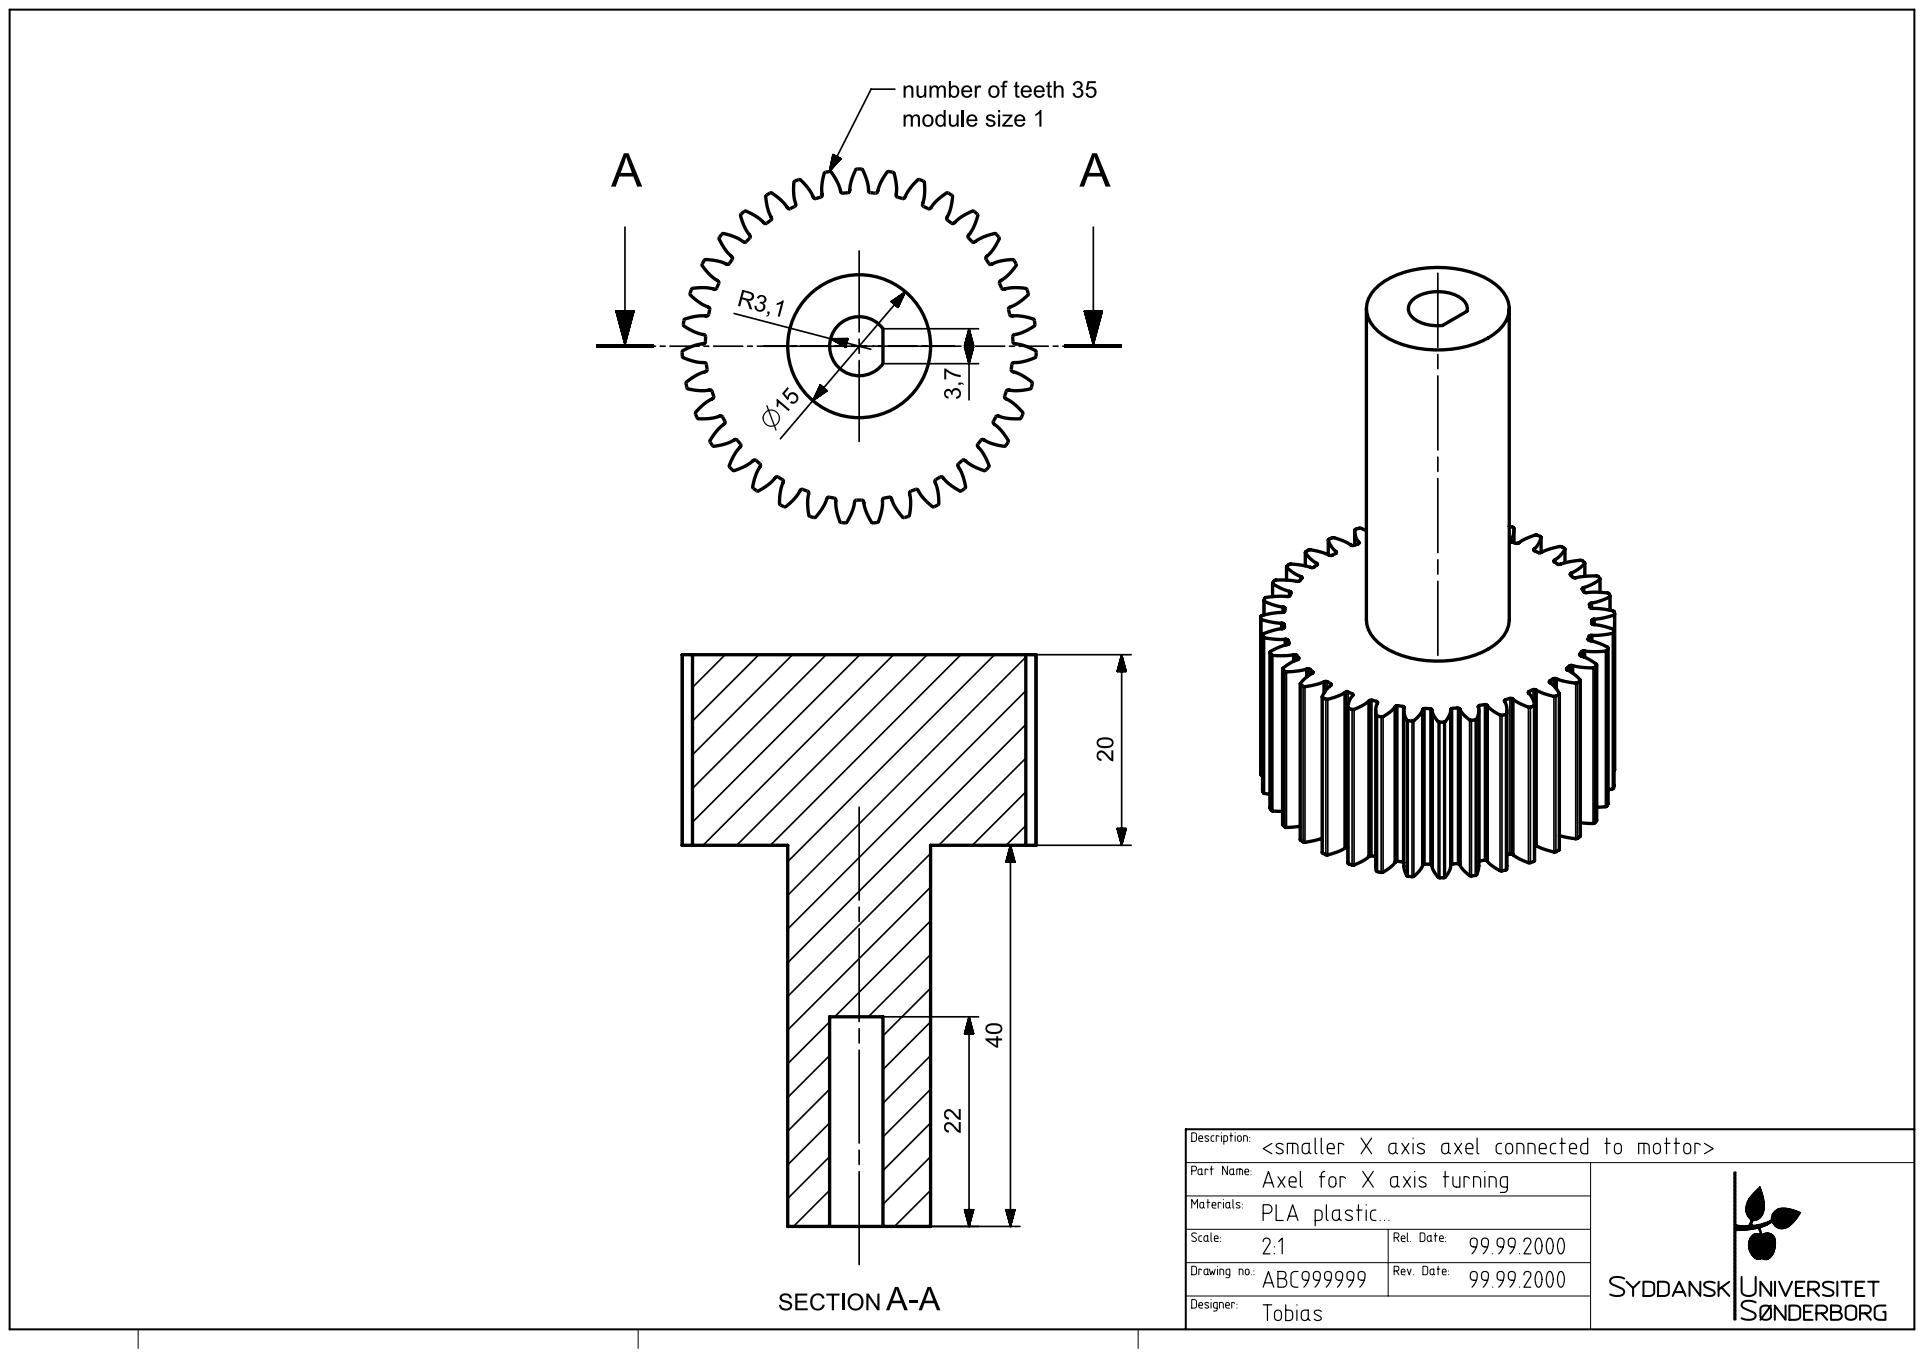
[picture p145: page 4]

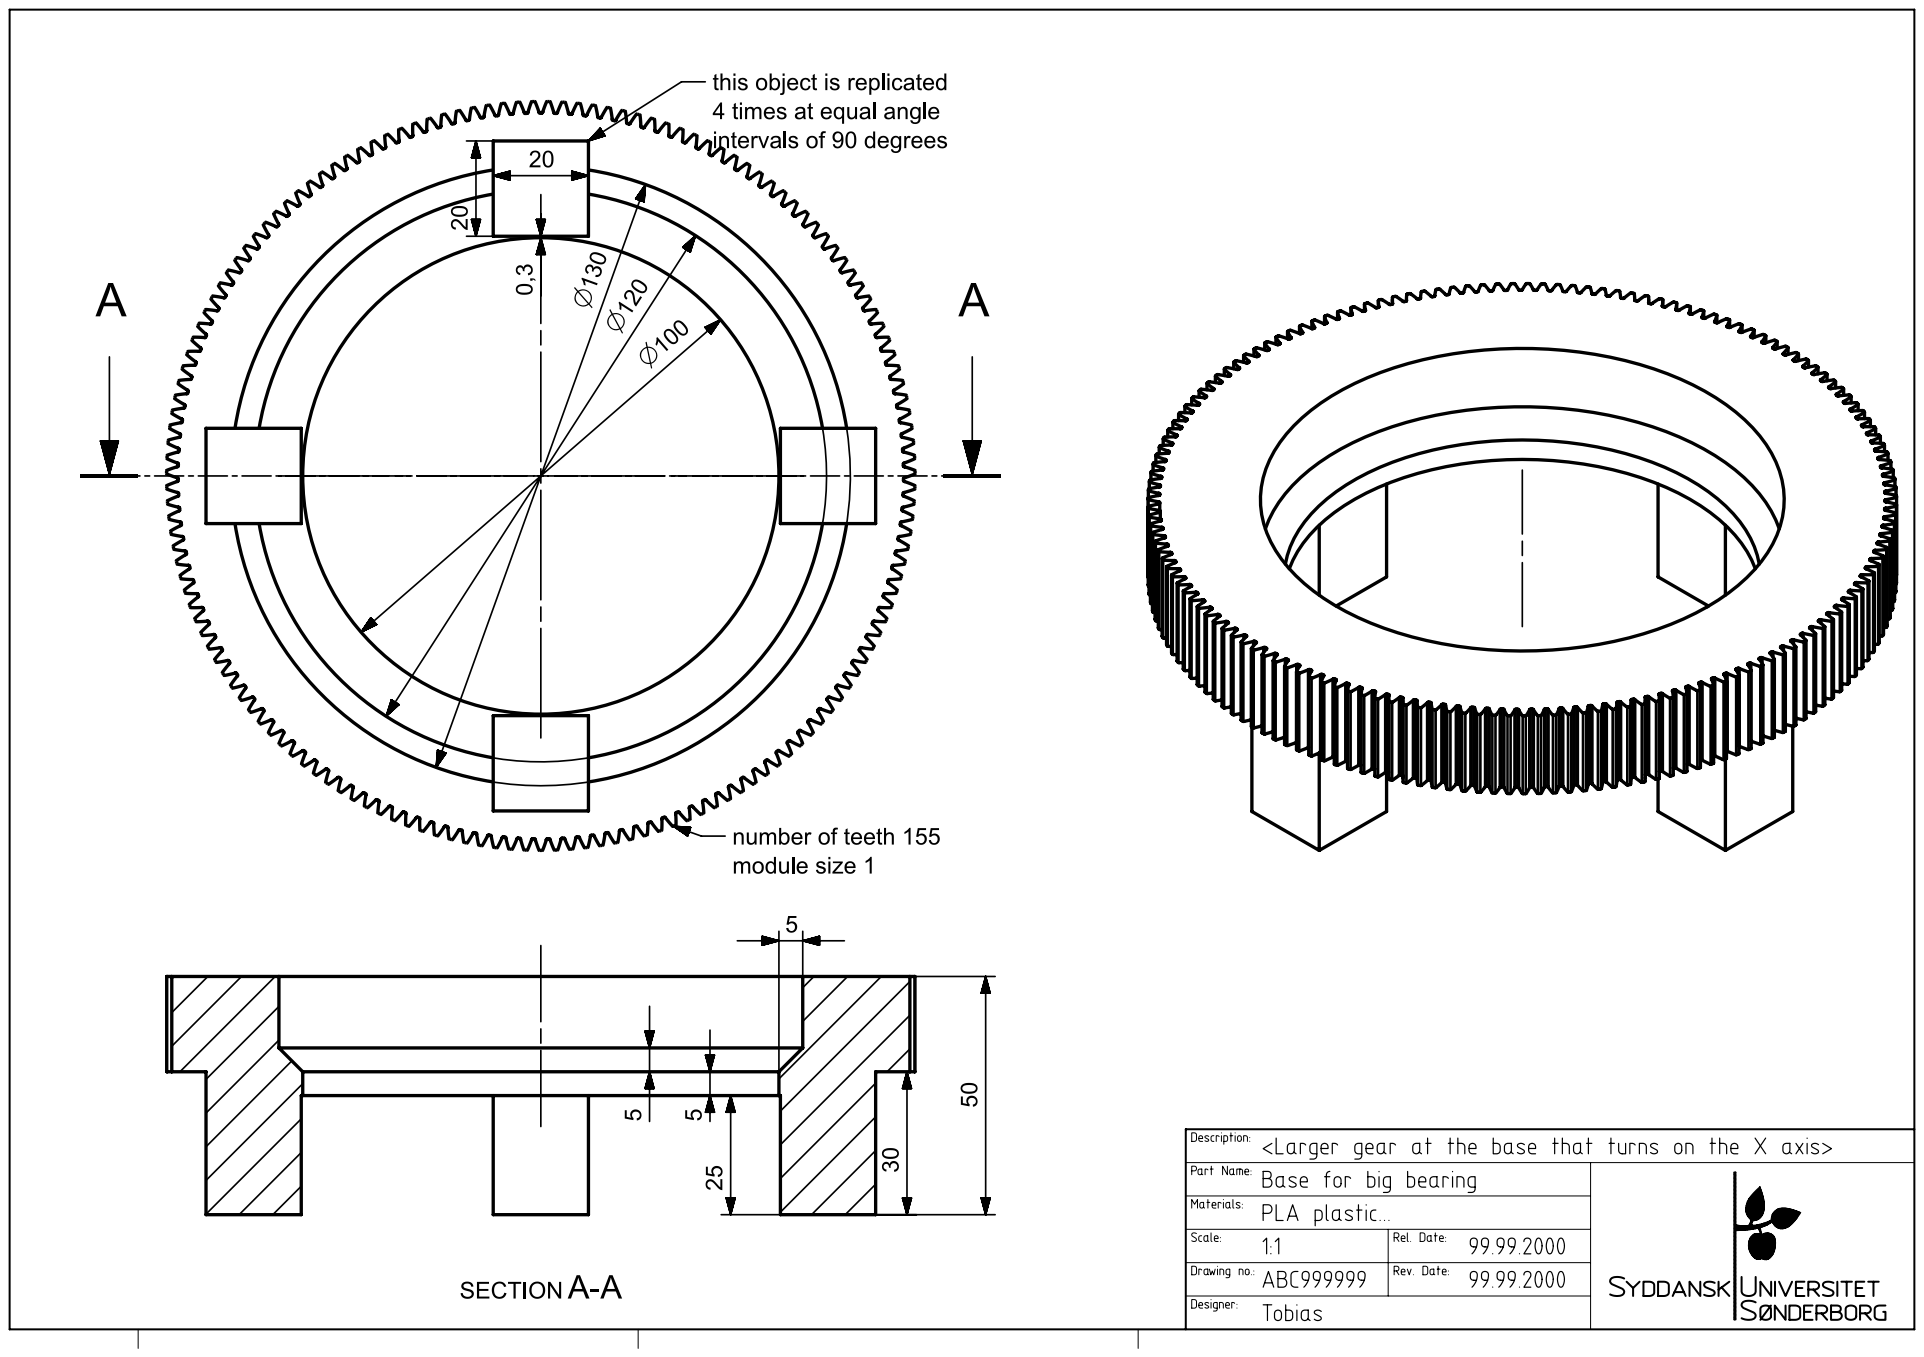
[picture p146: page 5]

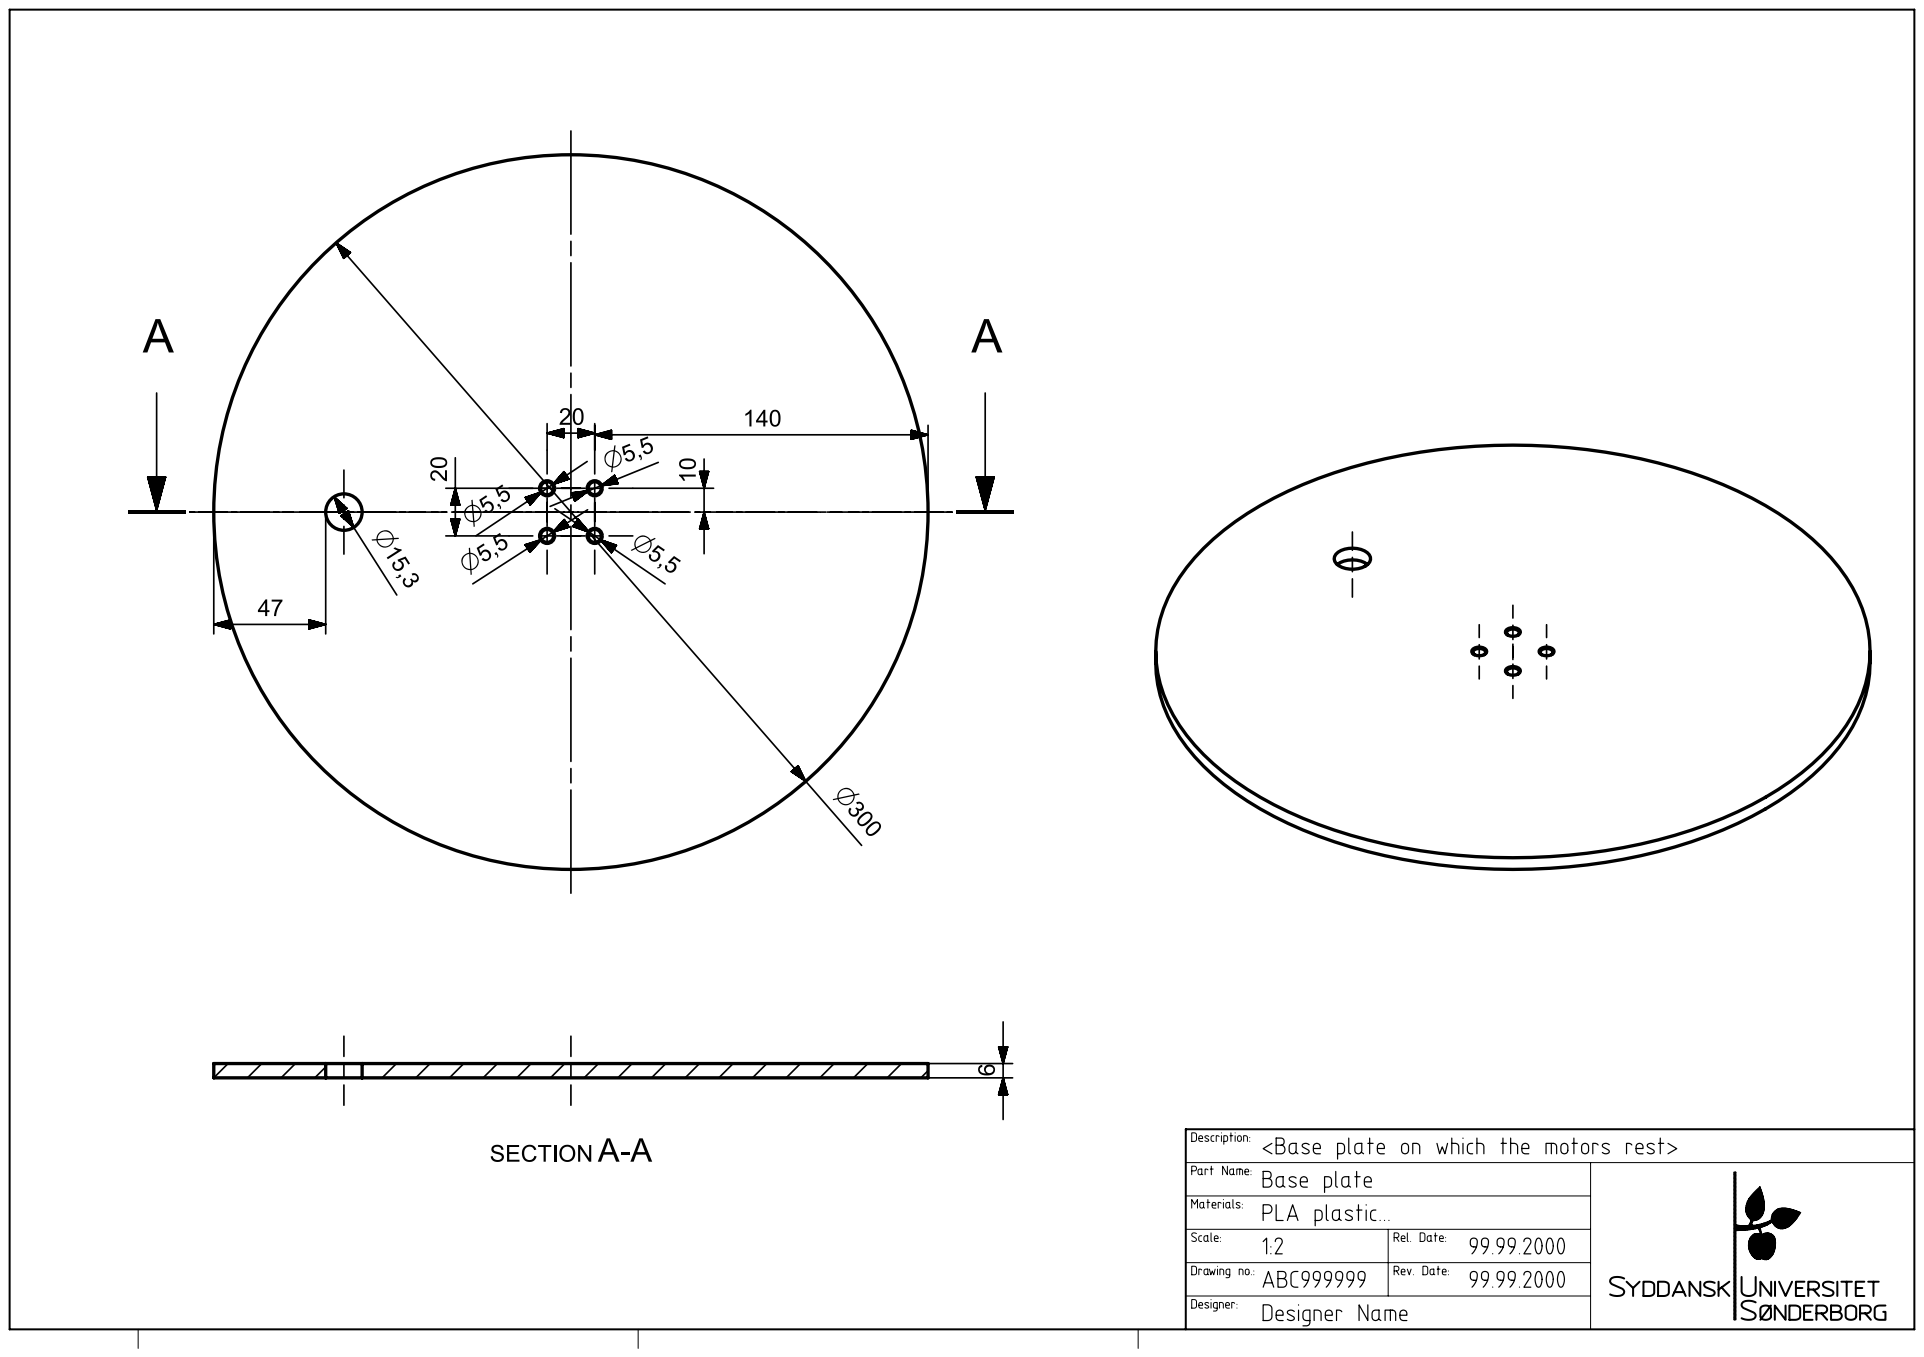
[picture p147: page 6]

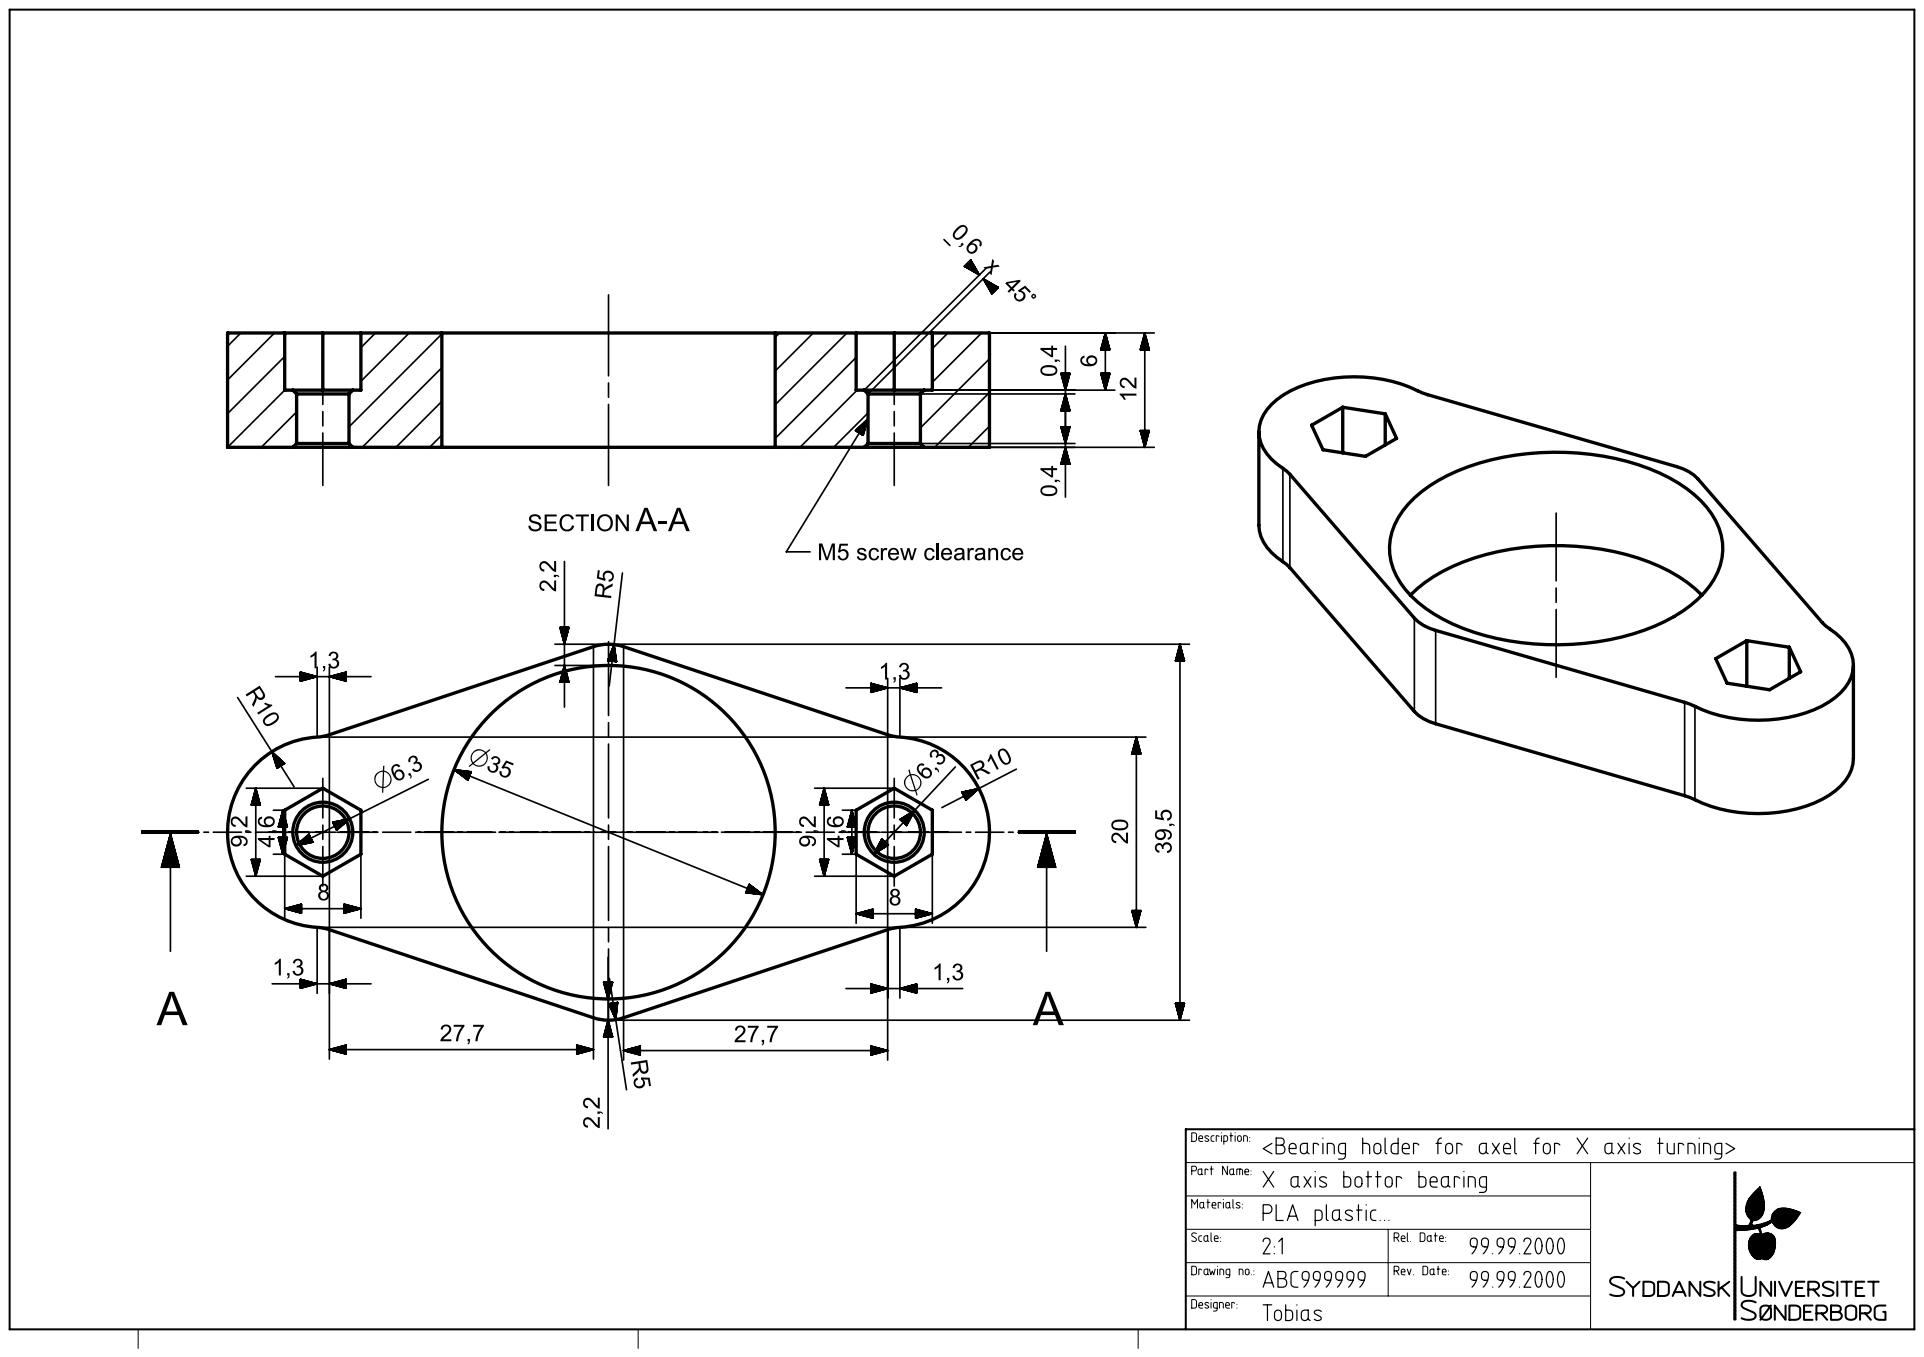
[picture p148: page 7]

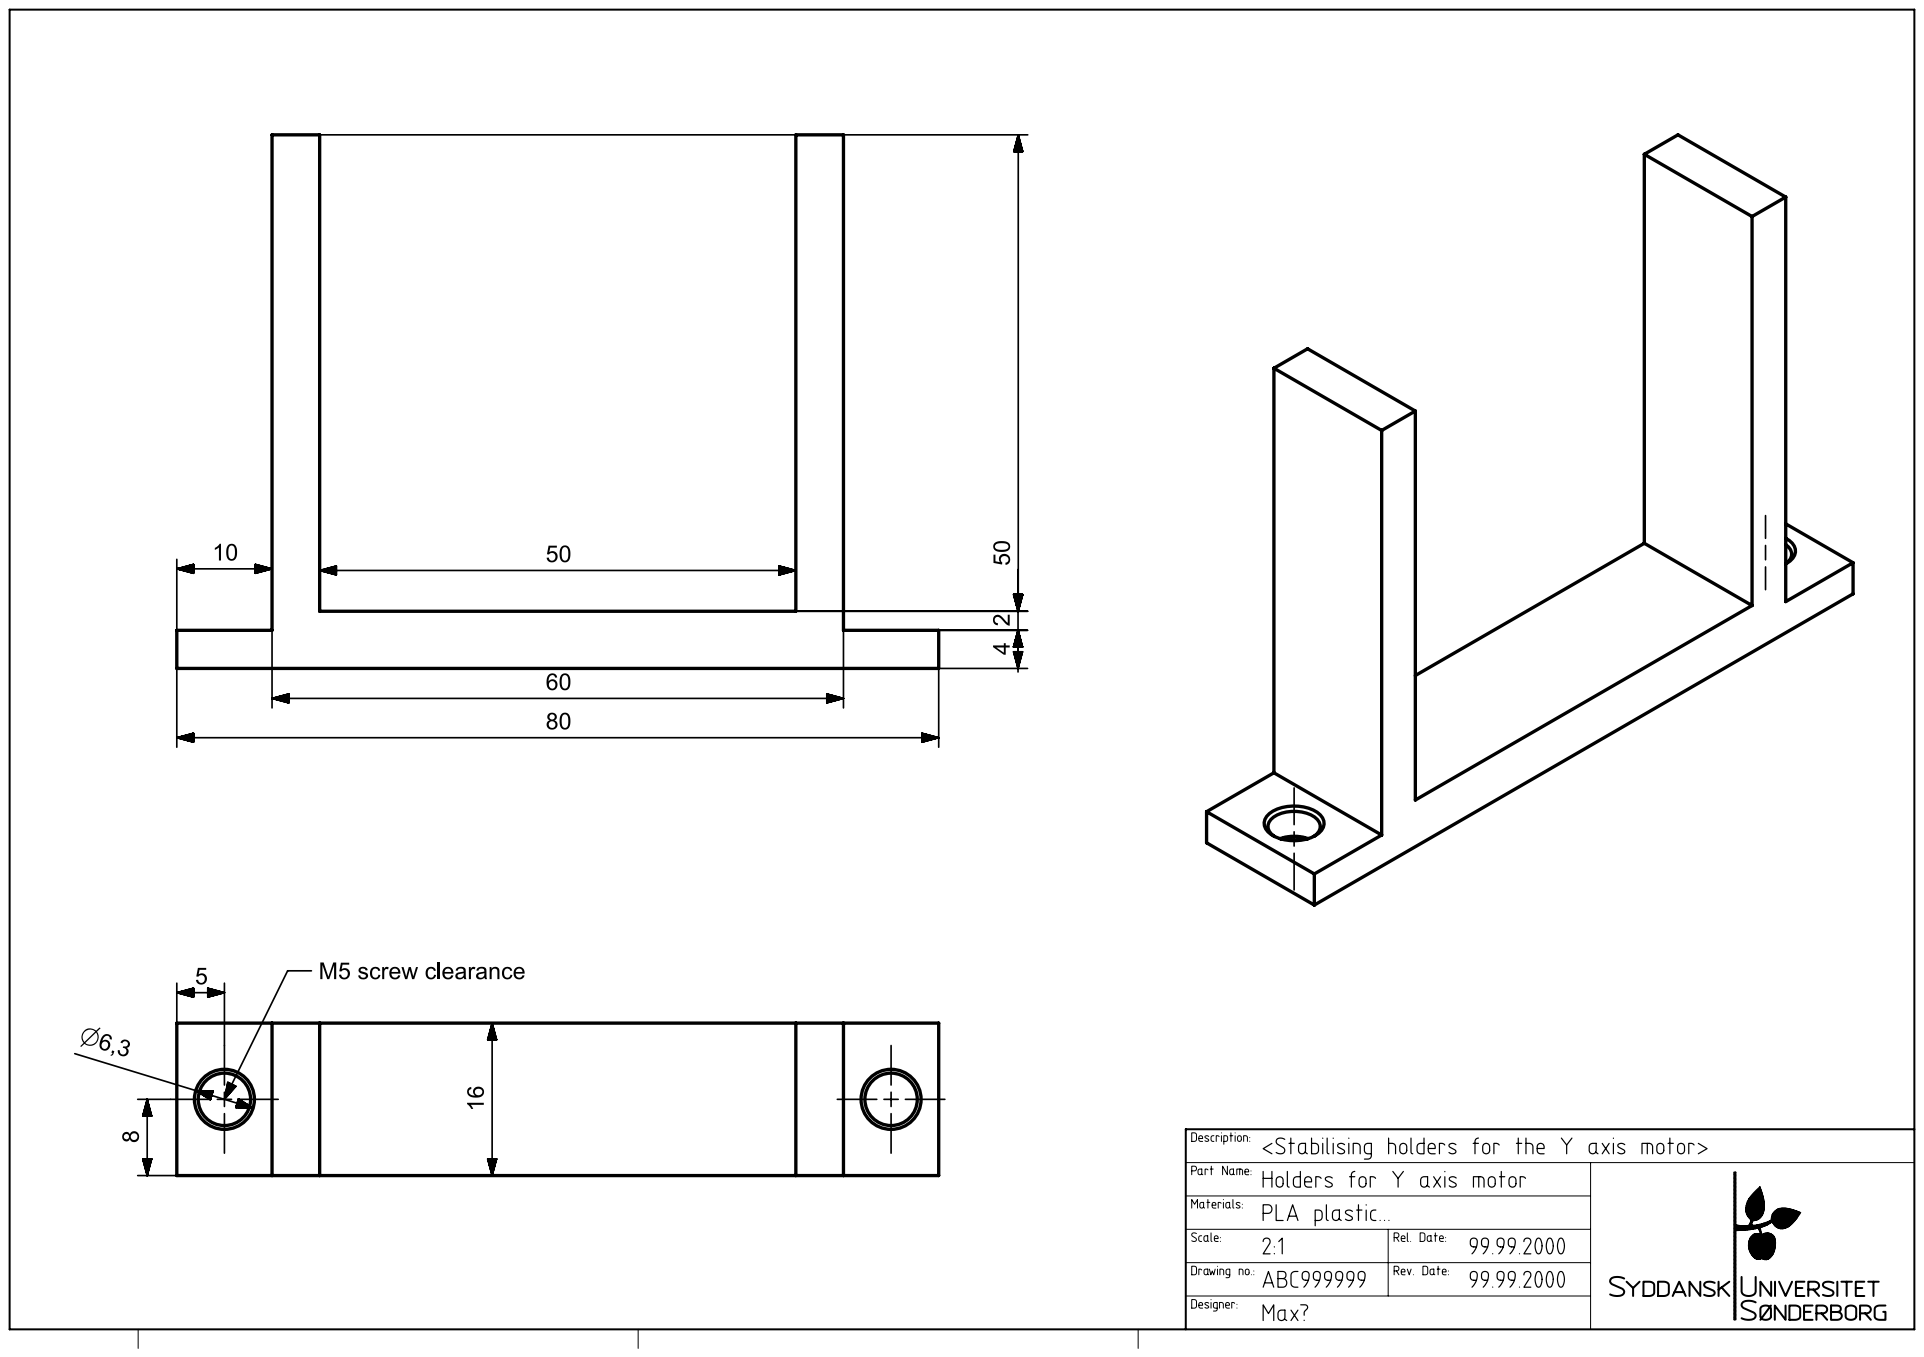
[picture p149: page 8]

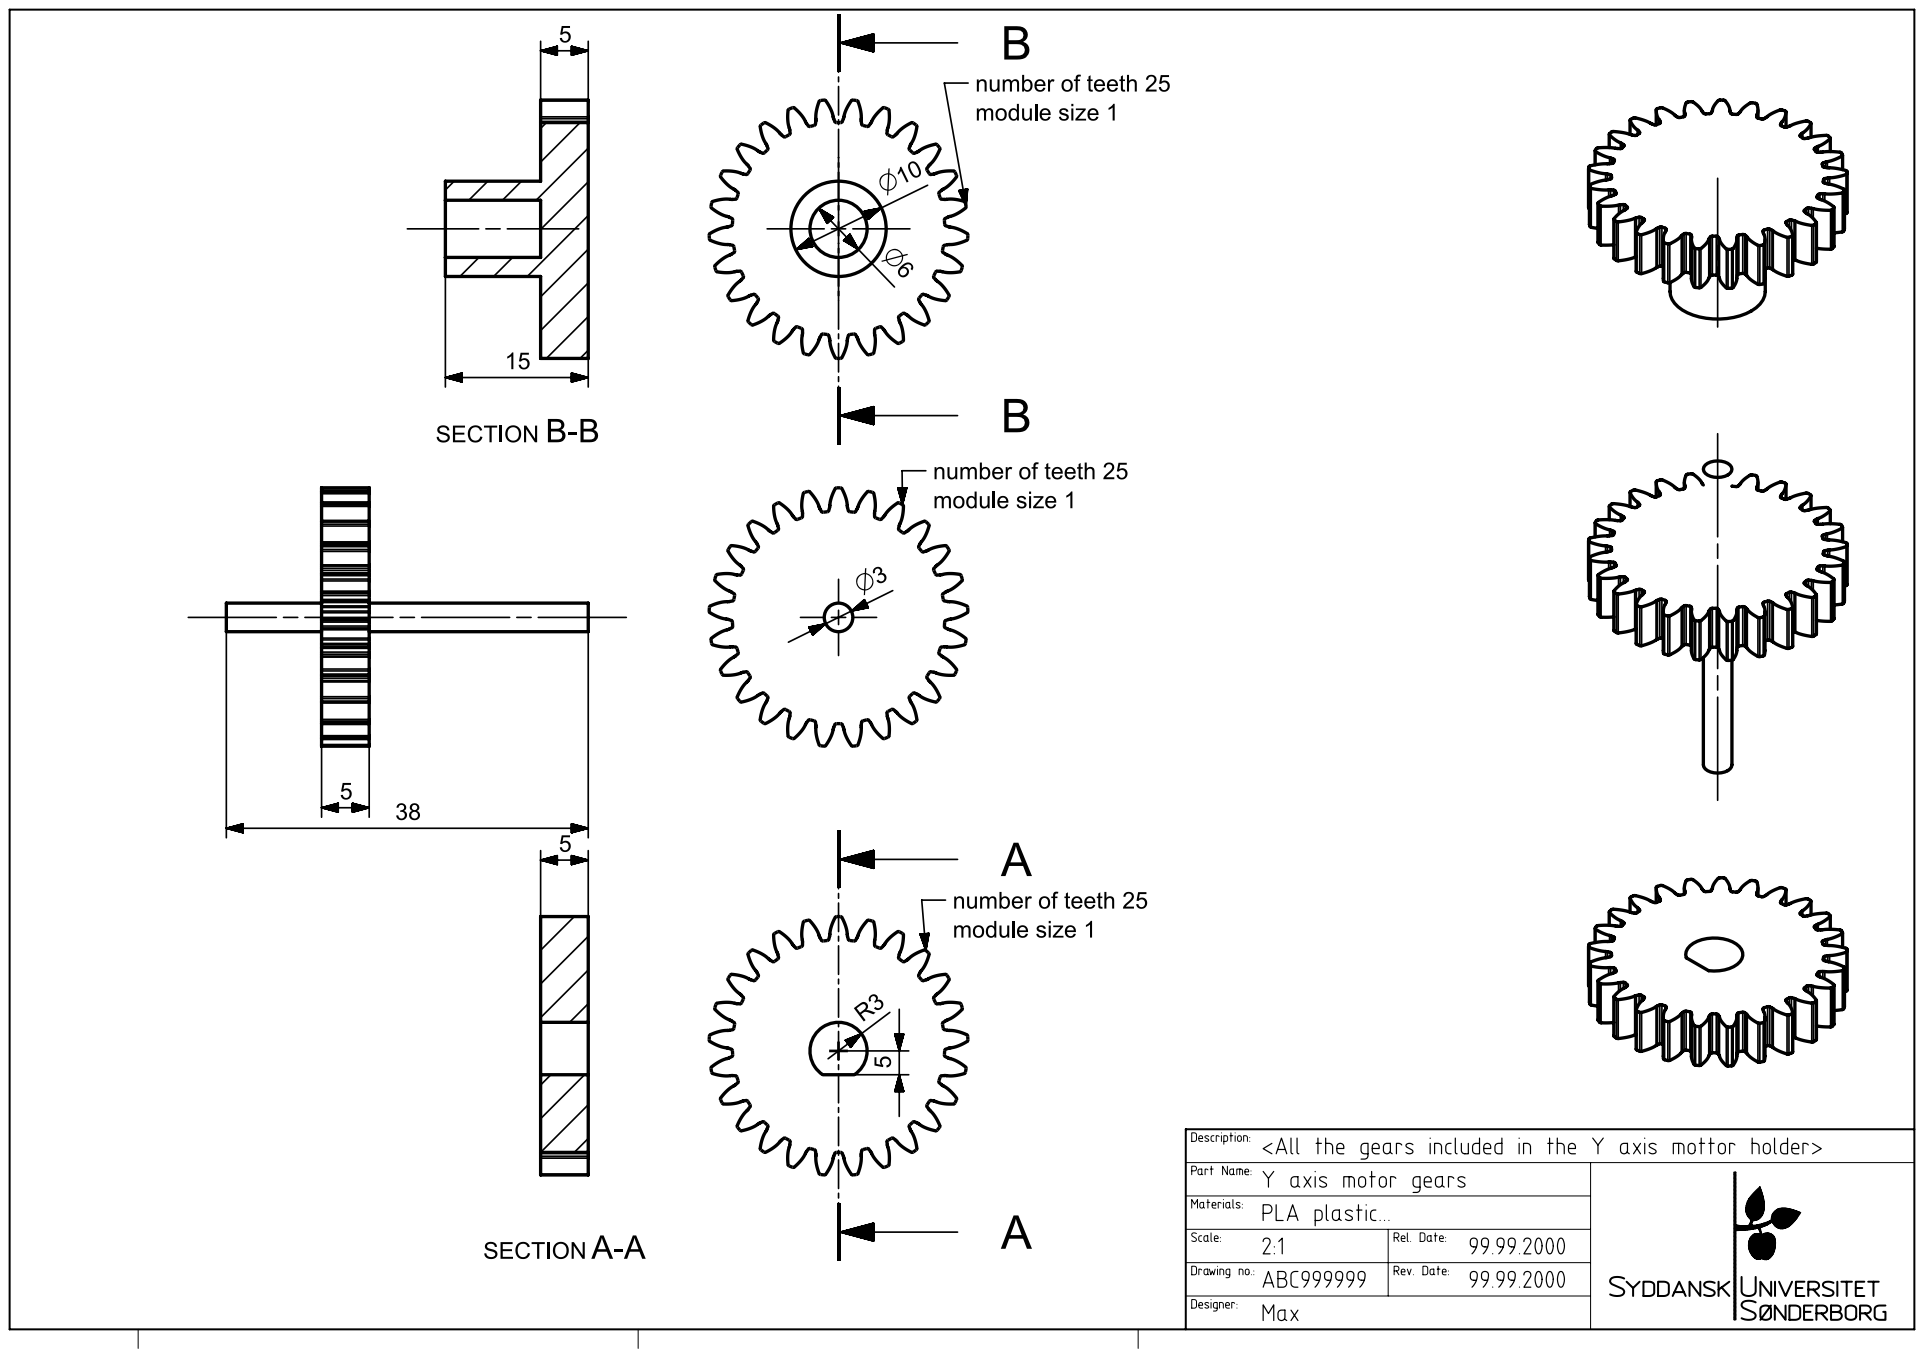
[picture p150: page 9]

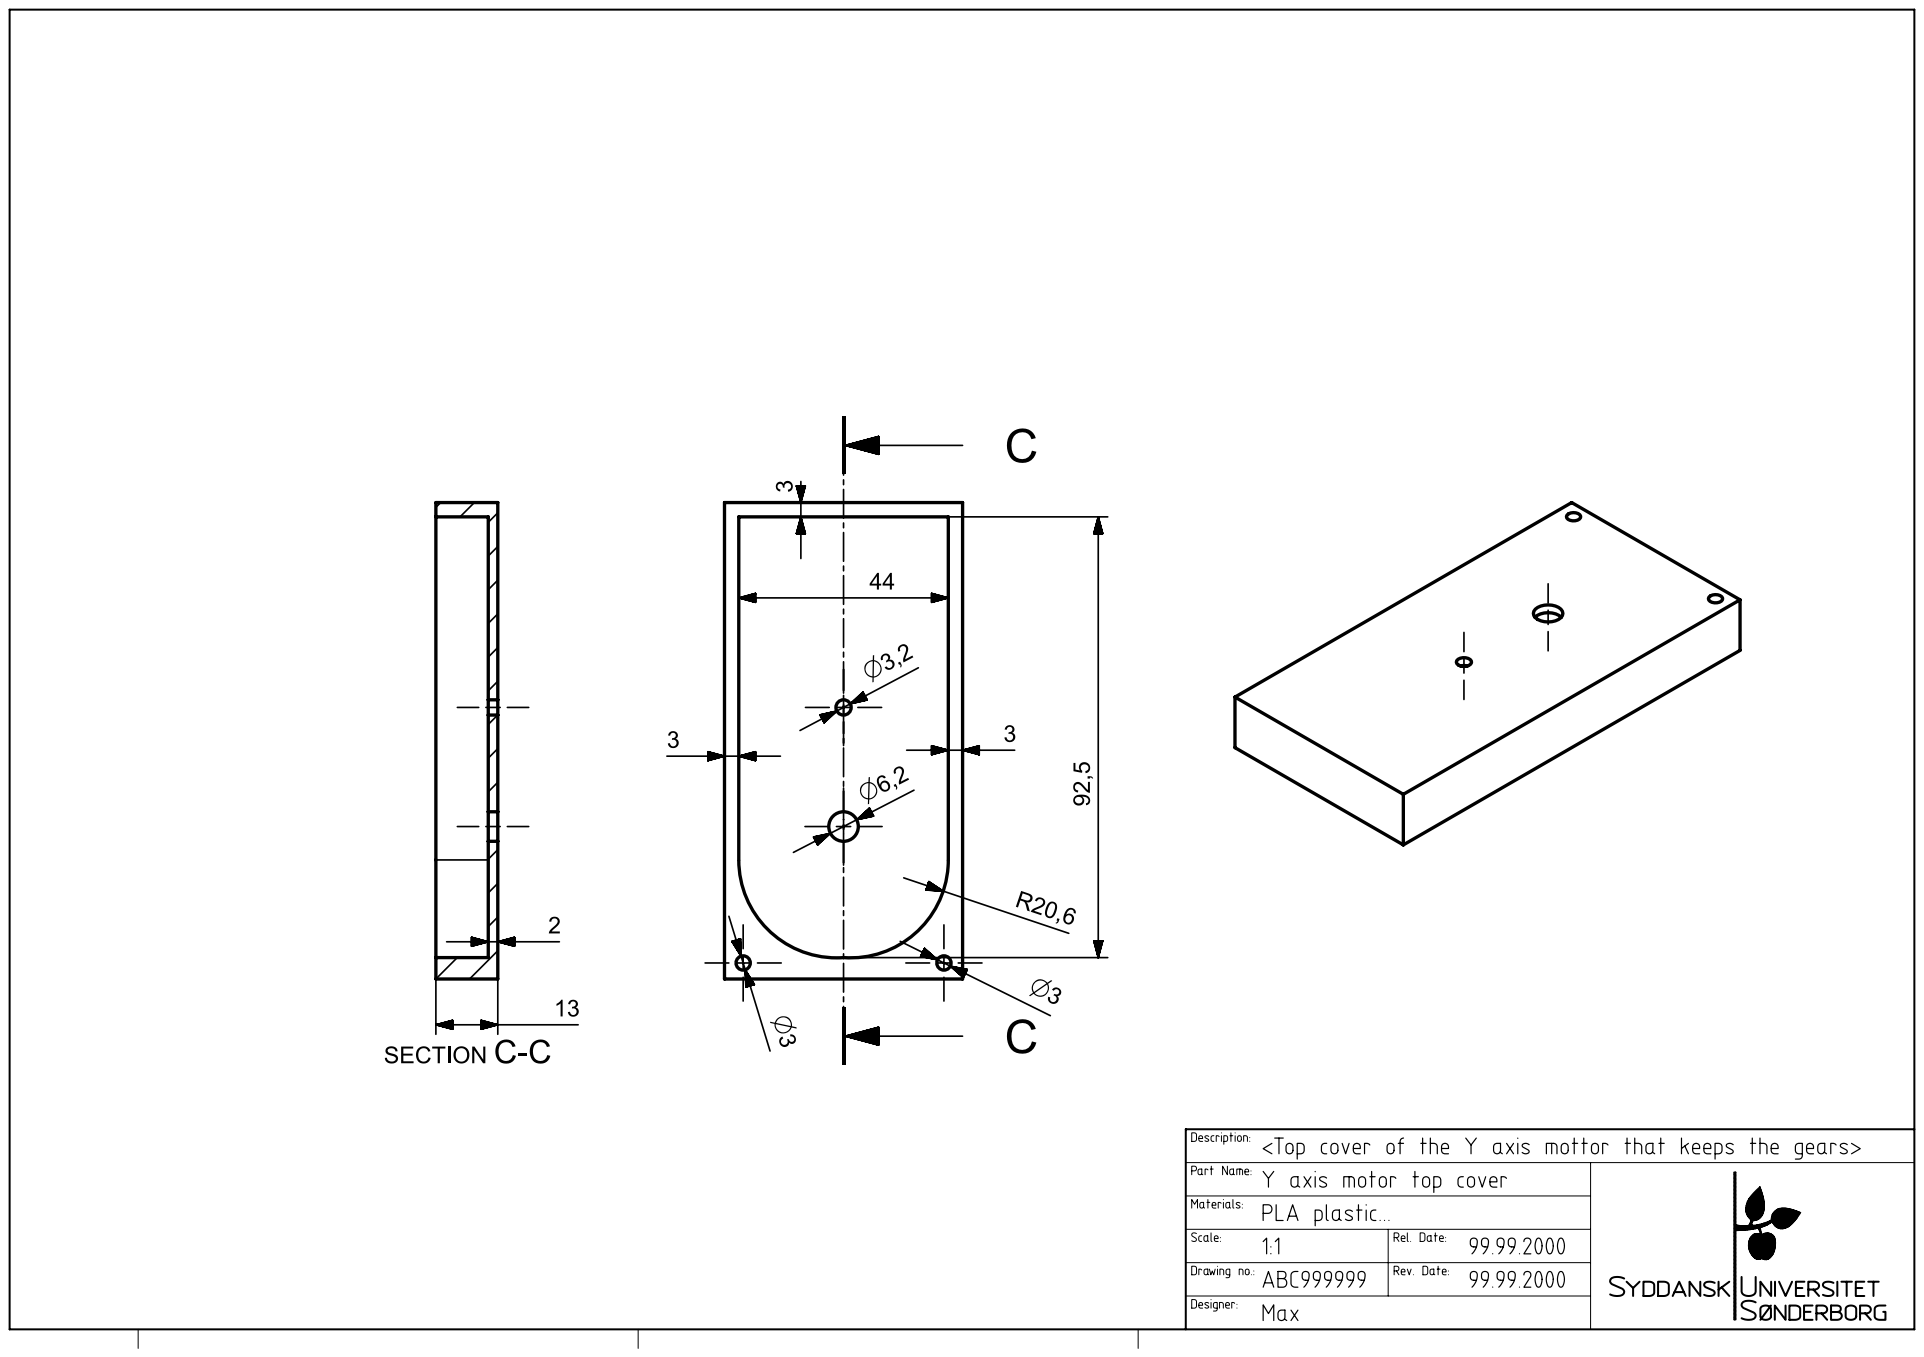
[picture p151: page 10]

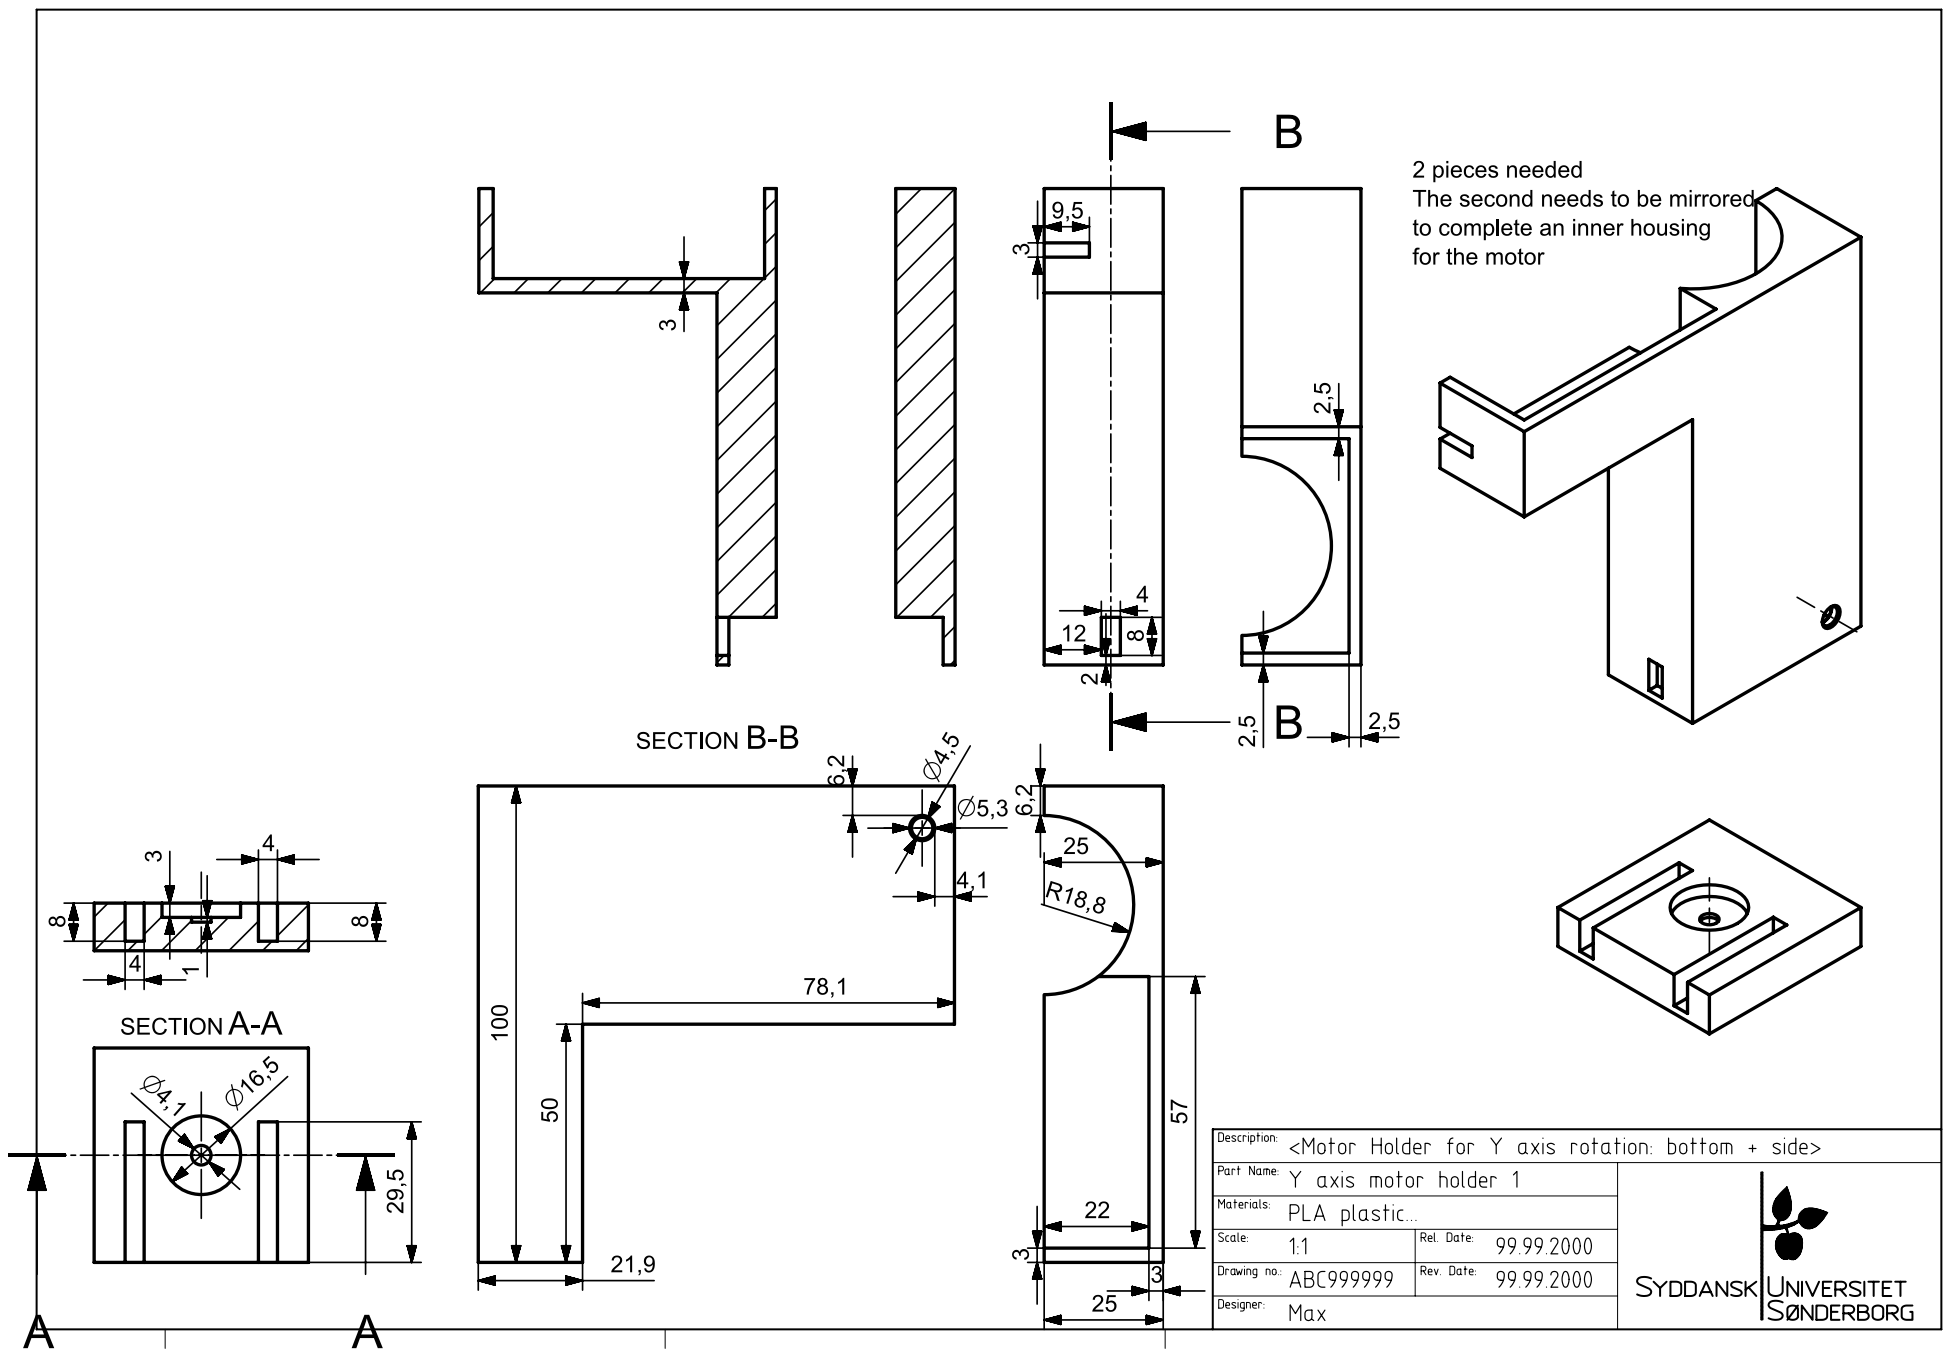
[picture p152: page 11]

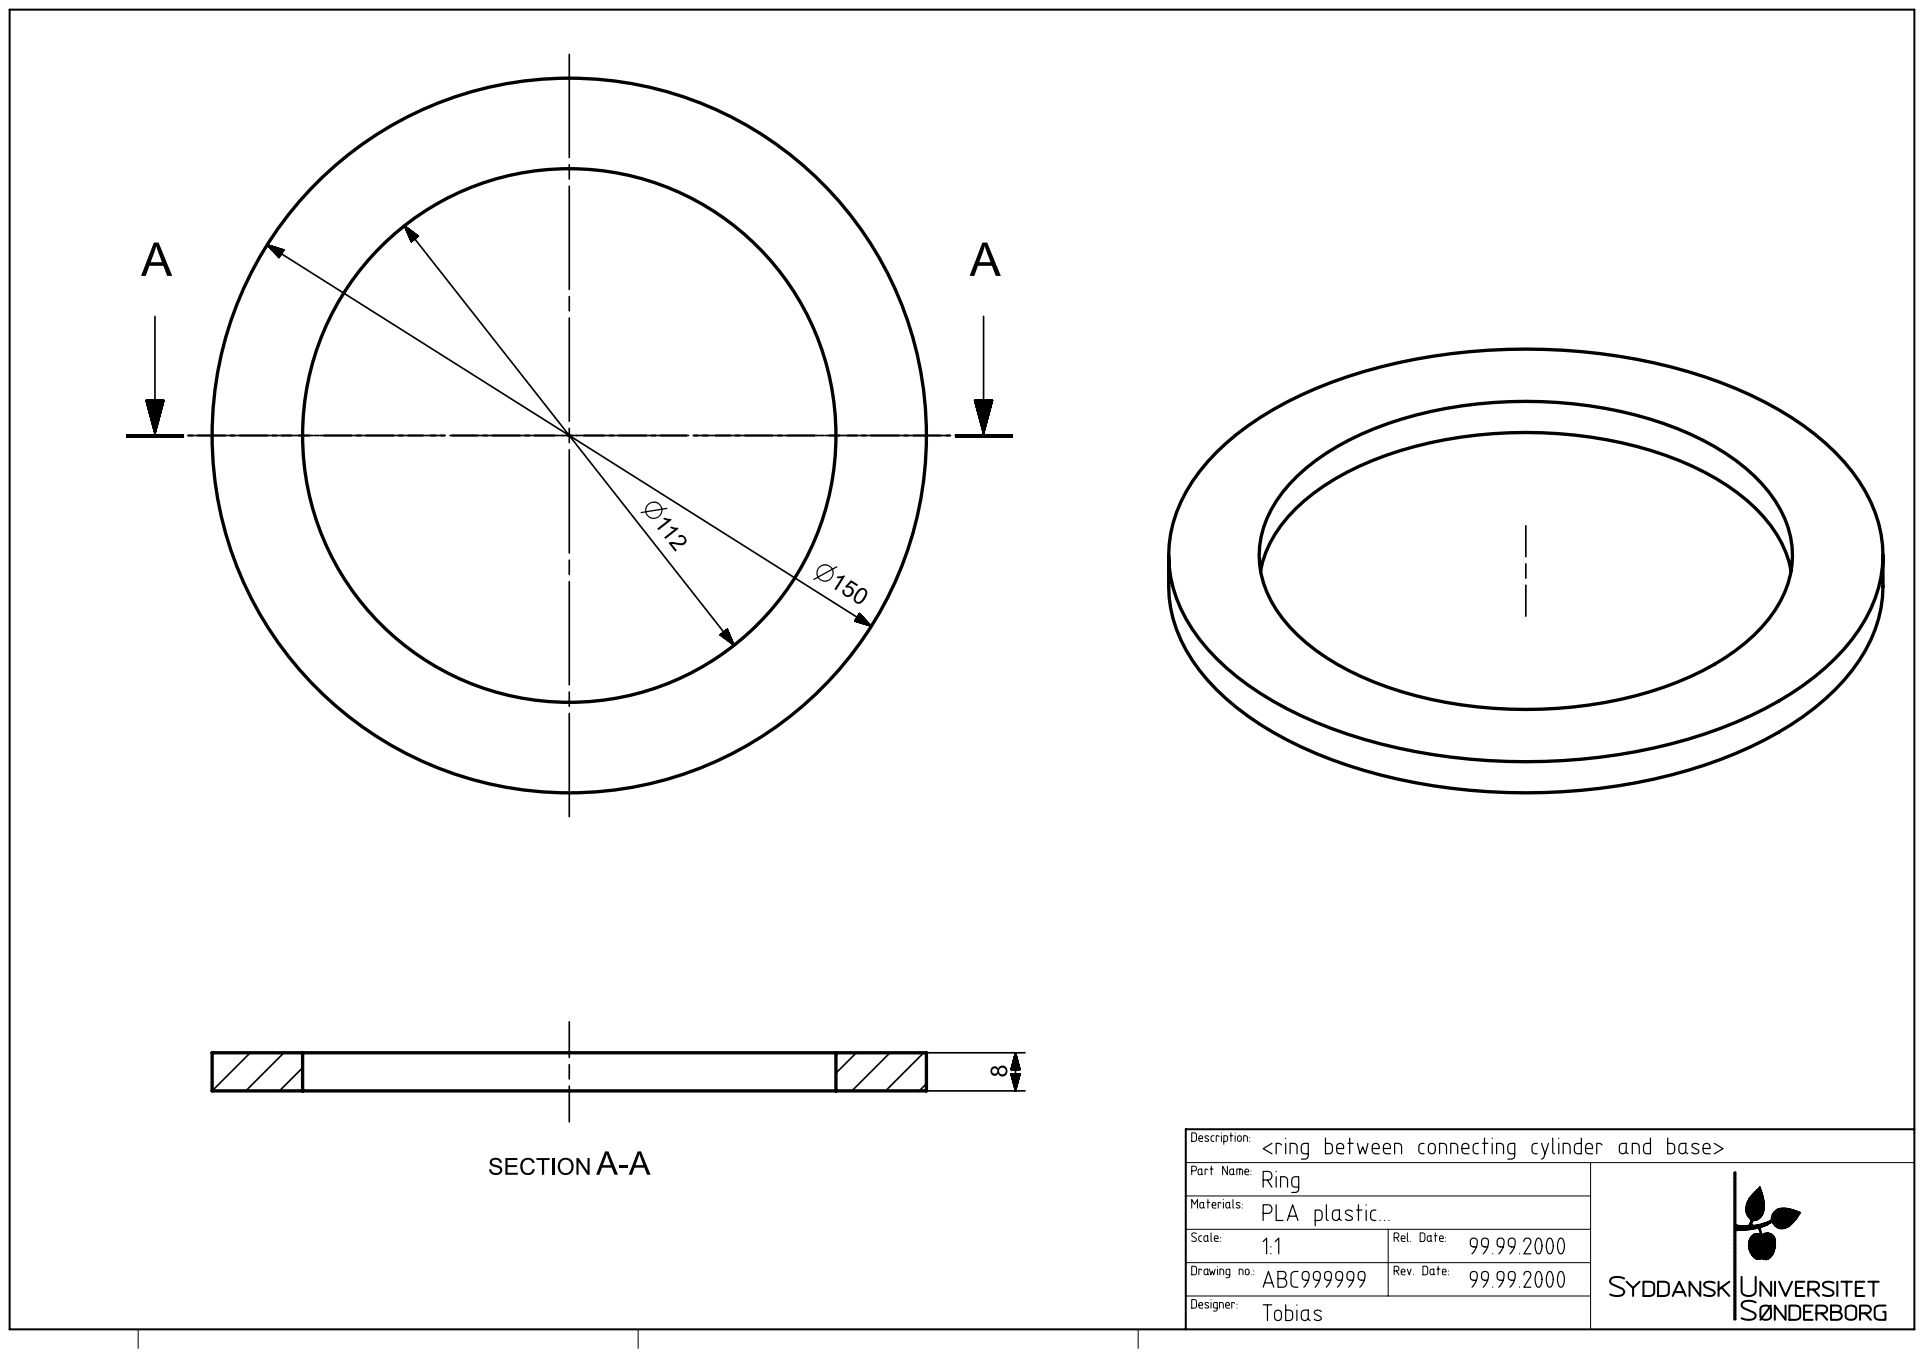
[picture p153: page 12]

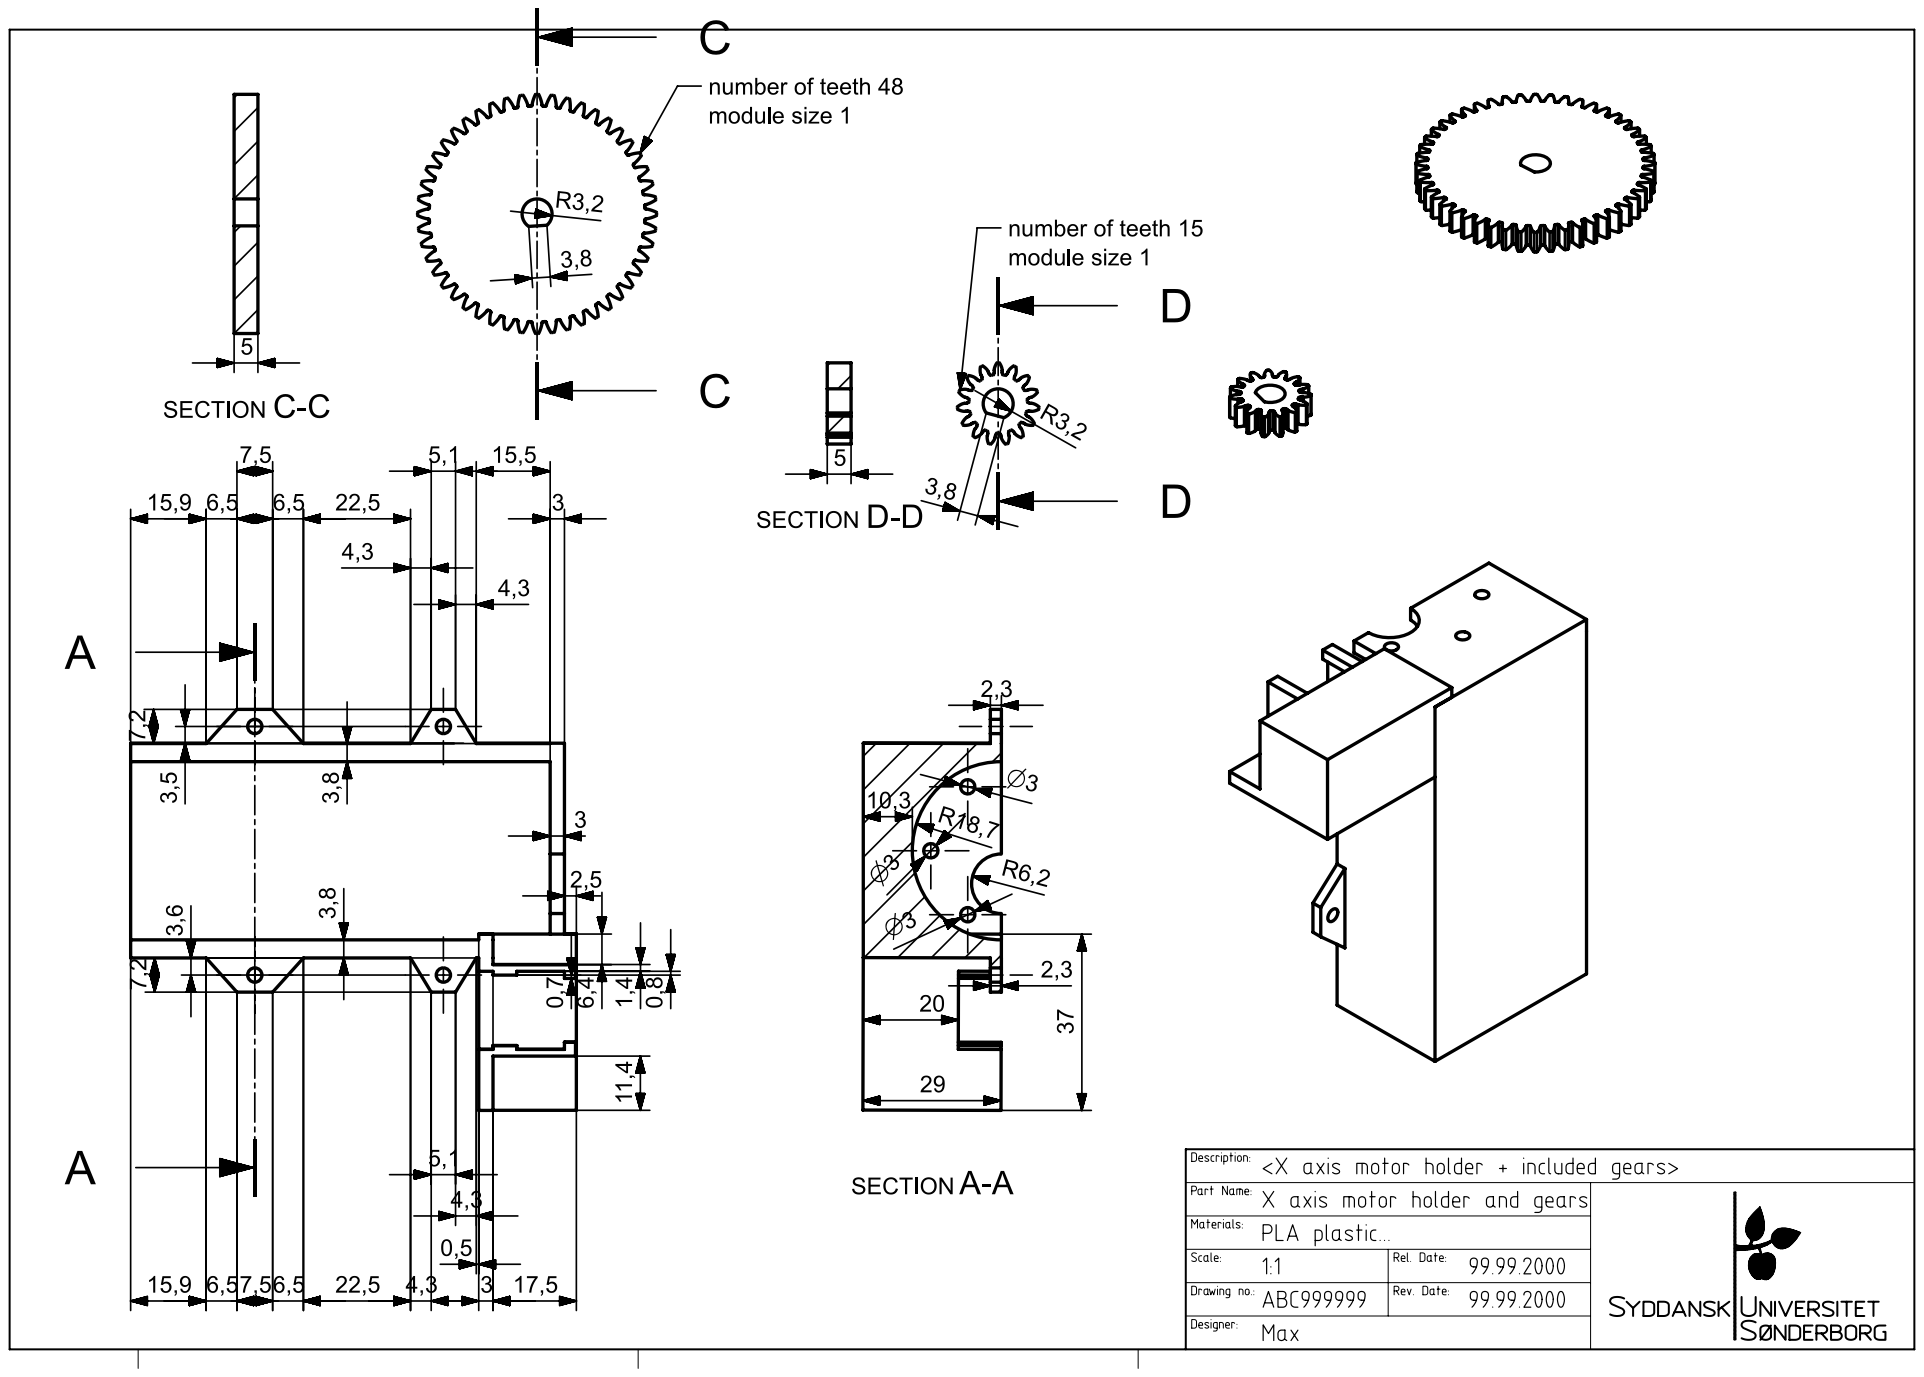
[picture p154: page 13]

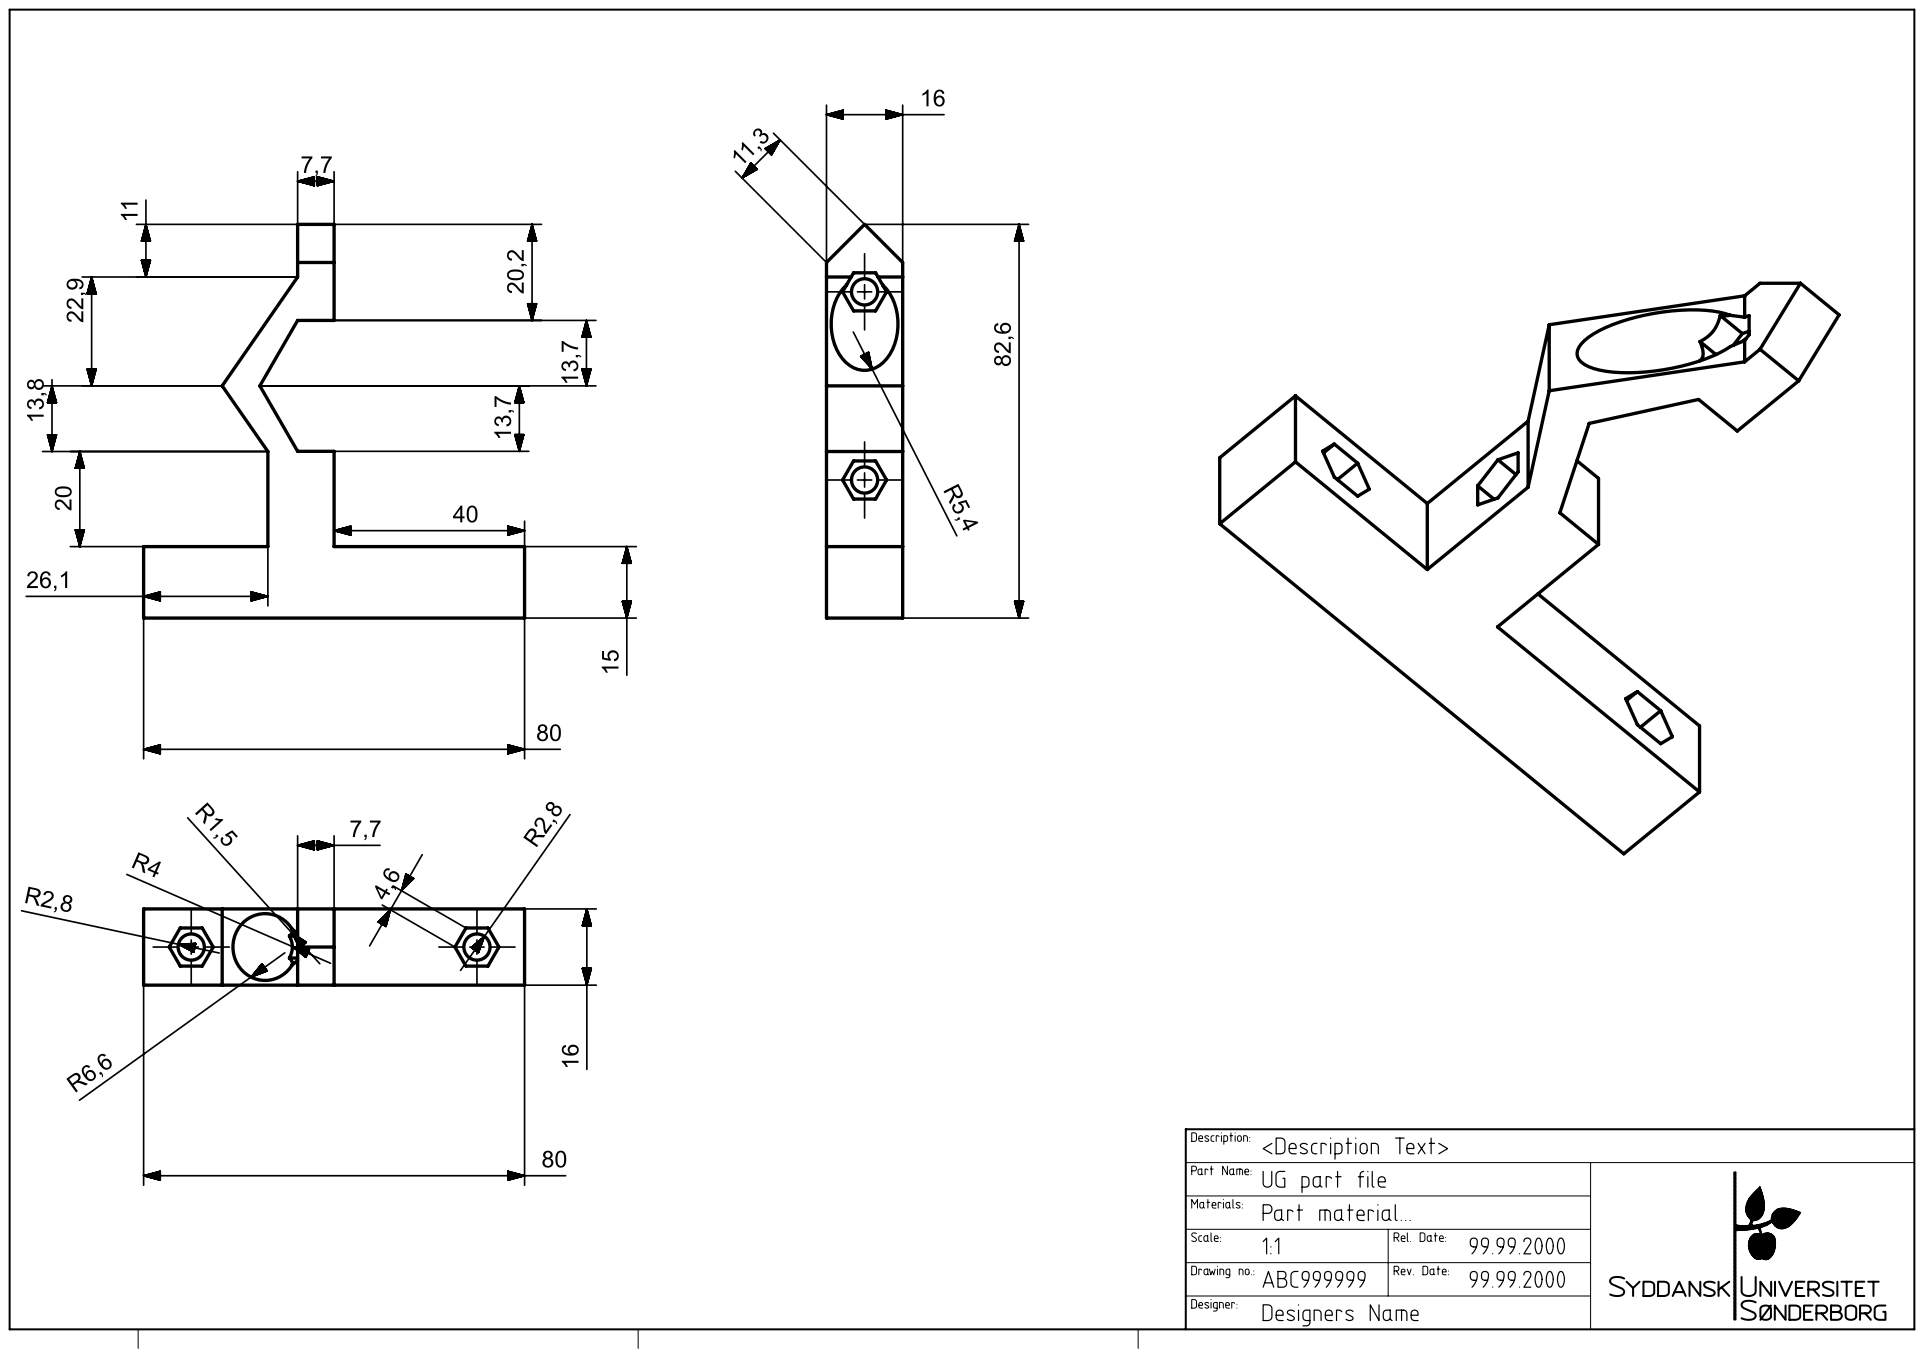
[picture p155: page 14]

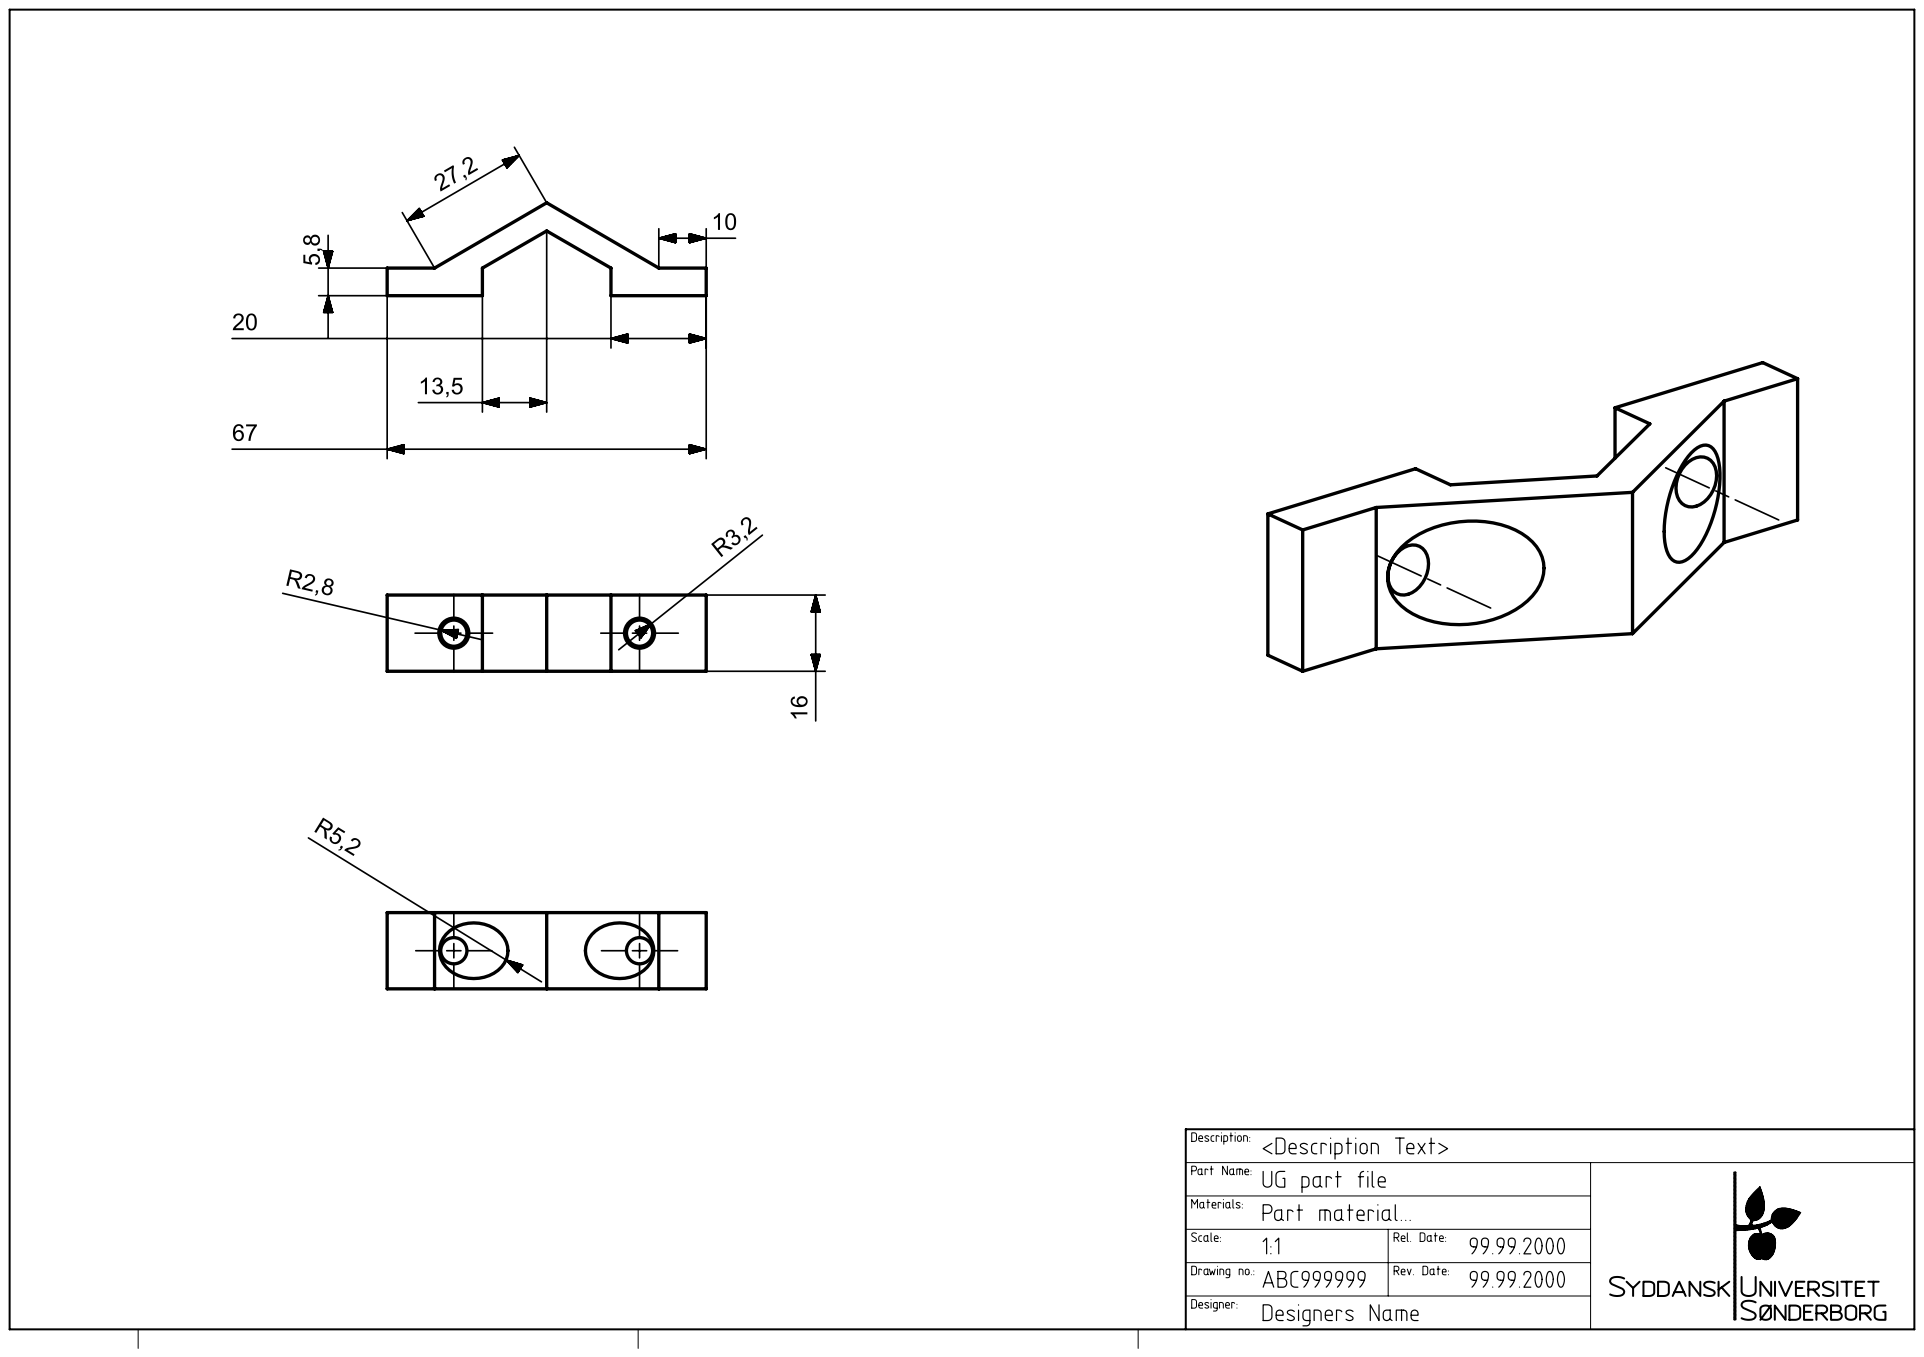
[picture p156: page 15]
