maxutko1/semester-project-2-/goonpcb/goonpcb.kicad_pcb

## KiCad design ABU2025-BL4525.kicad_sch

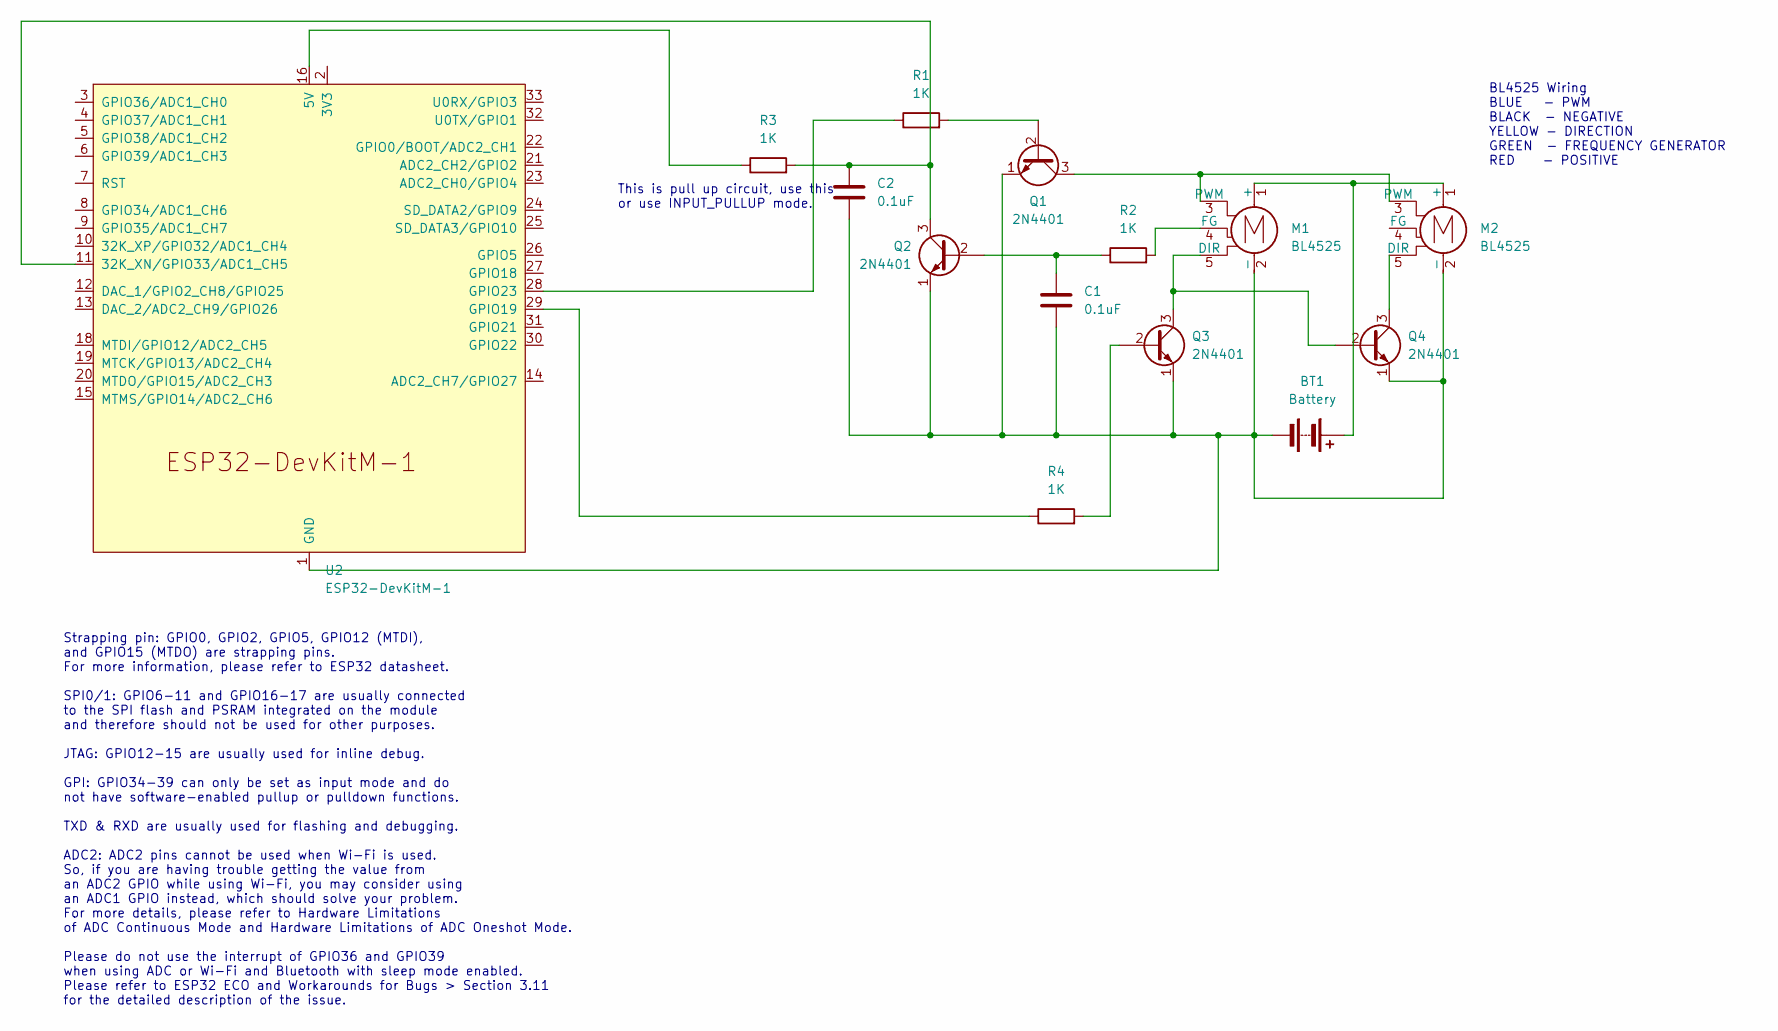
[picture p157: schematic ABU2025-BL4525.kicad_sch]

Parts:
BT1: Battery
C1, C2: 0.1uF
M1, M2: BL4525
Q1, Q2, Q3, Q4: 2N4401; TO-92_Inline
R1, R2, R3, R4: 1K
U2: ESP32-DevKitM-1

Connections:
unnamed: BT1.1 (+), M1.1 (+), M2.1 (+)
unnamed: BT1.2 (-), C1.2, C2.2, M1.2 (-), M2.2 (-), Q1.1 (E), Q2.1 (E), Q3.1 (E), Q4.1 (E), U2.1 (GND), U2.17 (GND), U2.34 (GND)
unnamed: C1.1, Q2.2 (B), R2.1
unnamed: C2.1, Q2.3 (C), R3.2, U2.11 (32K_XN/GPIO33/ADC1_CH5)
unnamed: M1.3 (PWM), M2.3 (PWM), Q1.3 (C)
unnamed: M1.4 (FG), R2.2
unnamed: M1.5 (DIR), Q3.3 (C), Q4.2 (B)
unnamed: M2.5 (DIR), Q4.3 (C)
unnamed: Q1.2 (B), R1.2
unnamed: Q3.2 (B), R4.2
unnamed: R1.1, U2.28 (GPIO23)
unnamed: R3.1, U2.16 (5V)
unnamed: R4.1, U2.29 (GPIO19)

Notes on the sheet:
BL4525 Wiring BLUE - PWM BLACK - NEGATIVE YELLOW - DIRECTION GREEN - FREQUENCY GENERATOR RED - POSITIVE
This is pull up circuit, use this or use INPUT_PULLUP mode.
Strapping pin: GPIO0, GPIO2, GPIO5, GPIO12 (MTDI), and GPIO15 (MTDO) are strapping pins. For more information, please refer to ESP32 datasheet. SPI0/1: GPIO6-11 and GPIO16-17 are usually connected to the SPI flash and PSRAM integrated on the module and therefore should not be used for other purpose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
