maxutko1/semester-project-2-/(commit log)

2025-03-20 Create model turret base.prt
    [model turret base.prt]
2025-03-20 Excel sheets I've created so far.
    [Excel Table Scores.xlsx, Micro Controller Table.xlsx, Shopping List 18.03.2025.xlsx]
2025-03-20 Update Shopping List 18.03.2025.xlsx
    [Shopping List 18.03.2025.xlsx]
2025-03-20 Time table + progress report
    [TimeTable Goals.xlsx]
2025-03-20 Pump calculations
    This is how far the pump should theoretically spray to.
    ...theoretically...
2025-03-20 Update Pressure Tank Report.docx
2025-03-20 made 3d printed tank test piece
    [Pressure tank, 3d print. rev 001 inventor file.ipt, Pressure tank, 3d print. rev 001.stp]
2025-03-20 Create Pressure tank, 3d print. rev 001 STL.stl
    [Pressure tank, 3d print. rev 001 STL.stl]
2025-03-20 Create Pressure tank, 3d print. rev 001 inventor file.stp
    [Pressure tank, 3d print. rev 001 inventor file.stp]
2025-03-20 new stl file
    [Pressure tank, 3d print. rev 001 STL.stl]
2025-03-20 more files
    [nx pressure tank.prt, nx pressure tank.stl]
2025-03-20 bullshit ass
    [Pressure tank, 3d print. rev 001 something new.stl]
2025-03-20 idk shits done
    [Pressure tank, 3d print. rev 001 inventor file.0001.ipt, Pressure tank, 3d print. rev 001 inventor file.ipt]
2025-03-22 report is going along great
    [new bigger tank.stl, nx pressure tank v2.prt]
2025-03-25 Y axis for the turret model
    [6202.prt, Cannon.prt, Head(Rotational part).prt, Pin.prt, Rotating Shaft.prt, SKF BALL BEARING 6202 15x35x11.SLDPRT, SKF BALL BEARING 6202 15x35x11.STEP, SKF BALL BEARING 6202 15x35x11.ipt]
2025-03-25 Updated Xcel with current work progress
    [TimeTable Goals.xlsx]
2025-03-25 That was the wrong folder
    [i2cmaster.h, lcd.c, lcd.h, main.c, twimaster.c, usart.c, usart.h]
2025-03-25 Revert "Nextion code"
    This reverts commit 16313af8dab95ba2695e77f6dc2c13b1ec99e220.
    [i2cmaster.h, lcd.c, lcd.h, lm75.c, main.c]
2025-03-25 new model of the tank
    [model1.prt, model1.stl]
2025-03-25 Made some more calculations
    did some more calculations for the pressure tank report. also added a maple document
2025-03-25 created a lid stl file
    [Tank Lid.stl]
2025-03-26 more pressure tank, report and stl files for the gasket
    [Tank Gasket.stl, Tank gasket.gcode.3mf]
2025-03-29 Cad Models
    Gyatt
    I was in Ohio before I met you
    I rizzed too much and that's an issue but I'm grimace shake
    Gyatt
    Tell your friends it was nice to rizz them
    But I hope I never edge again
    I know it breaks your Fanum
    Taxing in Ohio and I'm still not sigma
    Four years no Livvy
    Now you're looking pretty on Adin Ross' twitchy
    And iiiiii can't rizz
    No iiiiii can't mew
    So baby Gronk me closer
    In the back skibidi toilet
    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
    [6-Pin Header - Male - 2.54mm.step (1).prt, 6-Pin Header - Male - 2.54mm.step.prt, BMP388_Barometer v1.step, BMP388_Barometer v1_step.prt, Barometer.prt, Base.prt, Base_PCB.prt, Bosch BMP388.step.prt]
2025-04-01 code for max, plus new tank
    [Pressure tank, 3d print. rev 002 STL.stl]
2025-04-01 pretty much better nx model
    [model1.prt]
2025-04-01 Updated time table
    Included the day's progress.
    [TimeTable Goals.xlsx]
2025-04-08 Tolerances update
    [Rotating Shaft.prt, SKF BALL BEARING 6202 15x35x11_step.prt, Y-axis.prt, assembly1.prt]
2025-04-22 Added the water pump report
    water pump report (21.04.2025)
2025-04-22 idk i changed somethings apparantly
    [30212-a.x_t, Rotating Shaft.stl, Y-axis.stl]
2025-04-22 codeeeeeeeeeeeeeeeeeeeeeeeeeeeeeeeeeeeeeeeeeeeeeee for tobuias
    [goonpcb.kicad_pcb, goonpcb.kicad_sch]
2025-04-24 Update TimeTable Goals.xlsx
    update what we did for the week
    [TimeTable Goals.xlsx]
2025-04-29 made new tanks
    [Pressure tank, 3d print. rev 003 STL.stl, Pressure tank, 3d print. rev 005.stl, Pressure tank, 3d print. rev 006.stl, model rev 3.prt, model rev 4.stl, model4.prt]
2025-05-04 Updated some of the models for recent changes
    Changed the Y-axis model to have flaps rather than insertions
    Changed the model of the cannon so that it showcases its connection ring to the rotating shaft
    [Cannon.prt, Rotating Shaft.prt, Y-axis.prt, assembly1.prt]
2025-05-05 idk how to push it
    [gears.prt, model y motor.prt]
2025-05-12 Updated time table
    [TimeTable Goals.xlsx]
2025-05-12 Updated time table and tasks
    [TimeTable Goals.xlsx]
2025-05-12 made report for battery, plus new models for 3d print
    [Pressure tank, 3d print. rev 007 STL.stl, model1_1.stl, model1_2.stl, model1_3.stl, model1_4.stl, model4.prt, nozzle.prt]
2025-05-12 cad model of the lower holder for the x-axis motor
    yolo
    [Motor Holder lower.prt]
2025-05-12 motor holder upper for x-axis motor
    yolo#2
    [motor holder upper.prt]
2025-05-12 Assembly of the motor holder + updates to indiv. parts
    [Motor Holder lower.prt, assembly motor holder.prt, motor holder upper.prt]
2025-05-12 holders for the pressure tank
    [Holder.stl, holder for tank.prt]
2025-05-13 stuff was changed
    [Motor Holder lower.prt, Shopping List 18.03.2025.xlsx]
2025-05-13 Sussy baka model
    [Base Y axis.prt, assembly1.prt, gears.prt]
2025-05-13 Funny funky shiet
    [Connecting Cylinder.prt, New Legs Holder.prt, assembly1.prt]
2025-05-13 x axis gears
    [encoder gear.prt, gear 1.prt, gear 2.prt, gear 3.prt, shaft.prt]
2025-05-13 changed x axis motor holder
    [Motor Holder lower.prt, motor holder upper.prt]
2025-05-13 a lot of new models for the pump, mostly mounting
    [holder for pump 2.stl, holder for pump.stl, holder, new.stl, turn around mf.stl]
2025-05-14 changed motor holder
    [Motor Holder lower.prt, assembly motor holder.prt, motor holder upper.prt]
2025-05-14 changed the design of the motor holder
    [Motor Holder lower - test.prt, Motor Holder lower.prt, motor holder upper.prt]
2025-05-14 a lot of things for the pressure tank, mostly holders and test pieces
    [Connecting Cylinder.prt, Connecting Cylinder.stl, Holder 1 Part 1.stl, Holder 1 Part 2.stl, New Legs Holder.prt, New Legs Holder.stl]
2025-05-15 did a lot of shit for the y axis and pressure tank
    [22mm holder part 1.prt, 32mm holder.prt, 90 degree turn.prt, Relay holder part 1.prt, Relay holder part 2.prt, i have no idea at this point bro.prt, mount on y axis part 1.stl]
2025-05-15 for mario
    [encoder gear.prt, gear 1.prt, gear 2.prt, gear 3.prt, shaft.prt]
2025-05-15 these are the stls
    [base.stl, lid model.stl, motor model.stl]
2025-05-16 stls for x axis
    [base.stl, lid model.stl, motor model.stl, motor right part.stl]
2025-05-17 Changes to Cad Models
    [Test Base.3mf, Test Base.stp, encoder gear.3mf, encoder gear.prt, encoder gear.stp, gear 1.prt, gear 1.stp, gear 2.stp]
2025-05-17 More changes
    [Base Y axis.prt, Connecting Cylinder.prt]
2025-05-18 small changes, budget. plus some y axis for pressure tank
    [y axis holder part 1.prt, y axis holder part 2.prt, y axis holder part 2.stl]
2025-05-18 joystick code
    [Motor Holder lower - test.prt, motor holder upper.prt]
2025-05-18 Create new y axis.prt
    [new y axis.prt]
2025-05-19 no clue at this point
    [y axis holder part 1 rev 002.prt, y axis holder part 2 rev 002.prt, y axis holder part 2.prt]
2025-05-19 made assemblies, and stuff
    [30212 NX model.prt, 6202 bearing.prt, 6202-2z.x_t, Connecting Cylinder.prt, Entire assembly.prt, Y-axis.prt, base for big bearing.stl, base for big bearing.stl.prt]
2025-05-19 more assembly and shit
    [Entire assembly.prt]
2025-05-19 created new axel
    [axel for x axis turning.prt]
2025-05-19 x axis motor part fiile
2025-05-19 changed small things, and made a parent assembly
    [Entire assembly.prt, Y-axis.prt, assembly1.prt, axel for x axis turning.prt, base plate that was laser cut model.prt]
2025-05-19 made the pressure tank assembly, and incorpareted in the bigger assembly
    [90 degree bend.prt, ANSI B18.6.5M - 3.5 x 1.3 x 13 - B - I.prt, Body.prt, Diaphram.prt, Entire assembly.prt, Frame.prt, Piston.prt, Plunger.prt]
2025-05-19 stl for printing
    [axel for x axis turning.stl]
2025-05-20 new holders so the thing dosent bend
    [6202 bearing part 2.prt, Y-axis.prt, bearing holder for axel for x axis turning.prt]
2025-05-20 Gear Changes
    [Connecting Cylinder.prt, encoder gear.prt]
2025-05-20 Update Entire assembly.prt
    [Entire assembly.prt]
2025-05-20 Encoder Gear Change
    [encoder gear.prt]
2025-05-21 updated assembly
    [Entire assembly.prt]
2025-05-21 yeah did some stuff so the assembly would work better
    [Connecting Cylinder.prt, Connecting Cylinder_1 with holes.stl, Y-axis new.stl, new gear for encoder.stl]
2025-05-21 Changed code to the joystick code
    [Joystick Holder.prt]
2025-05-22 my code for the relay control
2025-05-22 updated the laser cut base
    [base plate that was laser cut model.prt]
2025-05-22 Code for nextion and motors combined
2025-05-23 Y-axis.prt is now able to hold the mottor box
    [Y-axis.prt]
2025-05-24 Absolutely every .prt in one file
    I dont know why it states some files are being deleted
    [1m 20t gear.prt, 22mm holder part 1.prt, 30212 NX model.prt, 32mm holder.prt, 6-Pin Header - Male - 2.54mm.step (1).prt, 6-Pin Header - Male - 2.54mm.step.prt, 6202 bearing part 2.prt, 6202 bearing.prt]
2025-05-24 Every .stl in one folder
    [Connecting Cylinder.stl, Connecting Cylinder_1 with holes.stl, Holder 1 Part 1.stl, Holder 1 Part 2.stl, Holder.stl, New Legs Holder.stl, Pressure tank, 3d print. rev 001 STL.stl, Pressure tank, 3d print. rev 001 something new.stl]
2025-05-25 Changed base due to certain issues
    [Entire assembly.prt, Y-axis.prt]
2025-05-26 fortnite battlepass
    [Joystick Holder.prt, Joystick grip.prt]
2025-05-26 moved some shit
    [Piston.prt, Plunger.prt, Pressure Plate.prt, Relay holder part 1.prt, Relay holder part 2.prt, Solenoid.prt, Y-axis.prt, model4.prt]
2025-05-26 MAIN code for the project
    Need only switch out PWM and a few changes after testing the pressure
2025-05-26 x axis model
    [x axis 2.0.prt]
2025-05-26 more design thinks
    [holder for y axis motor.prt, holder for y axis motor.stl]
2025-05-26 wrote a bit on the report
    [Entire assembly.prt, Y-axis.prt, assembly of pressure tank.prt, holder for y axis motor.prt]
2025-05-27 pressure tank report
2025-05-27 made some things for the report, and y axis motor
    [holders for y axis motor rev 002.prt, holders for y axis motor rev 002.stl]
2025-05-27 x axis motor holder
    [x axis 2.0.prt]
2025-05-27 Update model y motor.prt
    [model y motor.prt]
2025-05-28 Maschine drawings
    [base for big bearing.stl.prt, base plate that was laser cut model.prt, ring between connecting cylinder and base.prt, x axis 2.0.prt]
2025-05-28 joystick designing
    [Joystick Holder.prt, Manche V2.prt, assembly joystick.prt]
2025-05-28 did stuff
    [assembly joystick.prt]
2025-05-28 finished the report, added pictures
    [Joystick Holder.stl, Manche V2.stl]
2025-05-29 some changes
    [Tank Model.prt, Y-axis.prt, base plate that was laser cut model.prt]
2025-05-29 MOARRRR CHENYES
    MANI MORE CHENGES MORE STL FOR POTENTIOMETER
    [POT10K.step, PotentiometerB10K.SLDPRT]
2025-05-29 Assembly changed
    [Entire assembly.prt]
2025-05-29 All current Maschine drawings
    [Entire assembly.prt, axel for x axis turning.prt, base for big bearing.stl.prt, bearing holder for axel for x axis turning.prt, holders for y axis motor rev 002.prt]
2025-05-30 Box and .txt explaining why it would not work
    [Box Assembly.prt, Box shell.prt, Box side 1.prt, Box.prt, Entire assembly.prt, Y-axis.prt, ada boks.prt, box part 2.prt]
2025-05-30 made a bearing document
2025-06-01 updated budget and made word document
    [Shopping List 18.03.2025.xlsx]
2025-06-01 power distribution system word dox
